SoC-Labs/TideLink-Chiplet-Interconnect-AHB/docs/CALIBRATOR_9_11F_POSTREBOOT_SESSION_2026_05_28.md

# §9.11f post-reboot session — Layer-2 bit-error-rate confirmed

Date: 2026-05-28 (continuing from §9.11e overnight session report 4f31f41)
Branch: `feat/calibrator-eyecenter` HEAD = 4f31f41
Boards: bridge1 (z2_02 master die_a, z2_03 slave die_b), POST-REBOOT
Lease: bridge1 held mapstone-dev → 1h TTL

## Headline

Boards rebooted clean. §9.11d-equivalent bitstreams redeployed, **bilateral
LINK_IDLE recovers reproducibly** (Symptom A from yesterday: SOLVED). However
**no data traffic crosses in either direction post-LINK_IDLE** (Symptom B from
yesterday: still UNSOLVED). New evidence below isolates this to **long-packet
bit-error-rate failure** — the calibrator's eye-center is correct for the
training pattern and for short link-control packets (CR / CRACK), but
insufficient for long data packets (AHB-encapsulated writes such as the
doorbell-response).
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
