SoC-Labs/TideLink-Chiplet-Interconnect-AHB/syn/asic/fusion-compiler/INTEGRATION_CHANGES.md

# TideLink FC partition — integration changes + characterised dead-ends

This document captures the non-obvious decisions, characterised dead-ends,
and waivers the TideLink FC partition flow carries. Read this **before**
investigating any of the following symptoms — they are all already
explained.

---

## 1. PG floating-cell count (~4.6k) — PASS\*, not WAIVE

**Symptom:** `check_pg_connectivity` reports ~4622 floating std-cells in
the post-route block, despite check_pg_drc PASS, timing closed, LEC PASS.

**Characterised mechanism:** trim:true PG-mesh wire-stub fragments +
partition PG-terminal hand-off gaps (ZRT-740). The cells are tied to
VDD/VSS via the lib_cell `pg_pin` attribute (inferred), not via explicit
Verilog wiring — `get_cells -of_objects [get_nets VDD]` walks explicit
connections only, so the inferred ties appear as "floating" in the
canonical net's cells_of_objects collection.

**Audit script:** `scripts/pg_deepdive.tcl` (`make fc_pg_deepdive`).
Confirmed 49,622 / 54,868 = 90.4% of leaf cells are explicit-tied; the
9.6% "neither VDD nor VSS" population matches check_pg_connectivity's
count to within ~600 (same fragment population, slightly different
counting methodology between the two tools).

**Disposition:** PASS\* — characterised benign, ceiling at
`FC_PG_CONN_FLOAT_MAX=5500` (default). `FC_PG_CONN_WAIVER=0` restores
the strict ==0 gate.

**Supporting evidence the count is artefact:**
- `check_pg_drc` PASS (no PG geometric defect)
- Timing closed on both setup (WNS 0.00 ns) and hold (-0.00 ns) —
  would fail catastrophically if cells were truly disconnected
- Formality LEC clean (18,531 / 0 / 0 / 0)
- Same mechanism characterised by ahb_qspi's INTEGRATION_CHANGES.md
  "PG floating-cell deep-dive"

**Dead-end:** tightening the M5/M6 mesh from 50 µm → 25 µm in
pg_mesh.tcl was tried (2026-05-20) and **doubled** the count to ~9023.
The denser mesh adds more trim:true stub fragments; the count is a
property of trim:true geometry, not a function of mesh density.
Reverted.

---

## 2. End-of-line spacing DRCs — 9 residual after 3-pass ECO

**Symptom:** `check_routes` reports 9 EOL spacing DRCs concentrated in
the std-cell band shadowing the rf_16k macro (bottom-right corner).

**Convergence path proven on this build:**
| Pass | DRCs |
|---|---|
| Initial `route_auto` + `route_opt` (4_route.tcl) | 99 |
| Single `route_eco` (4_route.tcl, –max_detail_route_iterations 40) | 57 |
| 3-pass loop in pg_rails.tcl (route_eco / route_detail / route_eco, each 40 iter) | 9 |

The 3-pass loop is the ECO-relief recipe the ahb_qspi reference flow
validated. App_options that materially affect the convergence:
- `route.detail.force_max_number_iterations = true`
- `route.detail.drc_convergence_effort_level = high`
- `route.detail.eco_max_number_of_iterations = 50`
- `place.legalize.reduce_conservatism_in_eol_check = true`
- `route.common.eco_route_fix_existing_drc = true`

All set in pg_rails.tcl before the route_eco loop.

**Dead-end:** `route_opt -from final_route -to final_route` (the
ahb_qspi flow's documented relief command) is **ICC2-only syntax** —
fc_shell FS-COMPILER_2022.12 rejects it with CMD-010. Both the
ahb_qspi and tidelink flows were silently catch-and-skipping this
command for months before the diagnosis (2026-05-20). `route_eco`
without positional args is the FC equivalent.

**Disposition:** 9 EOL residuals are structural at this util /
floorplan (router can't escape local congestion without re-placement,
which would risk timing). Chip-top ECO required at top-level assembly,
or foundry waiver. Documented in the per-build MANIFEST.md.

---

## 3. Wav cell substitution (gap B + C) — DORMANT in v1

**Symptom:** enabling `+define+ASIC_TSMC65` (which swaps the
WavDemet{Set,Reset,Reset_*} flops to explicit `SDFFRPQ_X1M_A12TR` /
`SDFFSRPQ_X1M_A12TR` instances + the WavClockMux to a structural
glitch-free 2-flop-handshake mux) **regressed scen_fast hold WNS to
−4.85 ns** on 63 endpoints. Setup remained clean.

**Investigation log:**

| Attempt | Change | Hold WNS (scen_fast) | Note |
|---|---|---|---|
| 1 (2026-05-20) | Substitution raw, no SDC handling | −4.71 ns | Hypothesised reset-tree imbalance |
| 2 (2026-05-21) | Added `set_false_path -to` on 840 R/SN pins | −4.85 ns | False_path didn't help — failure mode isn't the reset pins |
| 3 (2026-05-21) | 2× `BUF_X1M_A12TR` between u_f1.Q and u_f2.D | −4.76 ns | 160 ps of explicit BUF delay → barely improved. Failure mode is NOT a localised f1→f2 hold-margin issue |

**Real failure mode (attempt 3 finding):** attempt 2's hypothesis was
wrong. ~160 ps of explicit BUF delay on the f1→f2 path moved hold WNS
by only ~90 ps (−4.85 → −4.76). The violations CANNOT all be local f1→f2
hold-margin issues — that scale of regression points at either
(a) a global clock-skew change when SDFFRPQ replaces FC's inferred
flops, (b) violations on OTHER paths (e.g. demet f2.Q fanning into
Wlink Chisel combinational paths with very short delays), or (c) FC's
hold-fix opto being inhibited on the substituted instances.

**v1.1 next step:** open the pg_probe.design block and inspect WHERE
the −4.76 ns hold violations actually are (count by ref_name; check
the failing-endpoint distribution; verify clock-tree skew around the
substituted vs non-substituted cells). Don't rebuild blind a fourth
time — the next iteration needs `report_timing -delay_type min -max_paths 50`
on the substituted block first.

**Attempt 3 mechanical record:** inserted two `BUF_X1M_A12TR` cells in
series between each u_f1.Q and u_f2.D inside each WavDemet*.v
`\`ifdef ASIC_TSMC65` arm. Per-bit inside the generate-for loop for the
width variants. The wrappers are still in-tree (no harm when the gate
is off); re-enable `+define+ASIC_TSMC65` once the actual failure
mechanism is diagnosed.

**Timing guards:** pg_rails.tcl now has both a setup WNS guard
(< −0.05 ns aborts) and a scen_fast hold WNS guard (< −0.5 ns aborts),
both via `report_qor` text parse (fc_shell doesn't expose `setup_wns`
as a scenario attribute in this build — ATTR-1 warning).

---

## 4. fc_shell vs ICC2 syntax — the silent failures

fc_shell FS-COMPILER_2022.12 inherits much of its command set from
ICC2 but has subtle differences. Several ICC2 idioms silently fail
here (`Error: unknown option …` is caught and the command becomes a
no-op):

| Command / option | Status in this build | Workaround |
|---|---|---|
| `route_opt -from final_route -to final_route` | REJECTED | Use `route_eco` |
| `route_opt -effort high` | REJECTED | Fall back to a second default-effort `route_opt` |
| `get_attribute [get_scenarios …] setup_wns` | Returns "" | Parse `report_qor` text output instead |
| `get_ports -quiet` (in SDC) | REJECTED | Use unconditional get_ports, accept warning |
| `sizeof_collection` (in SDC) | REJECTED | Move to read_sdc caller (full fc_shell Tcl scope) |
| `check_design -checks {netlist_pre_check}` | EMS-035 (not a valid check name) | Skip — handled by 7_drc.tcl's adv-runner |
| `check_design -checks {pre_signoff_stage}` | EMS-035 | Same |
| `check_design -checks {placement}` | EMS-035 | Same |

Every one of these is caught by `catch{}` in the flow scripts so the
flow proceeds; the failures appear only in the .log. The diagnostic
hint is "this command does nothing" — if a command was supposed to
make a measurable change and you can't see one, grep the log for
`(CMD-010|CMD-005|CMD-012|EMS-035)`.

---

## 5. ICG library safety net — Wav clock-gates land on PREICG

**Risk:** the Wlink Chisel `WavClockGate` + `wav_latch_model` cells are
not explicitly mapped at RTL — they rely on FC's clock-gating
inference to land on the sc12 `PREICG_X*B_A12TR` ICG family (20 cells).
If `set_dont_use */PREICG_*_A12TR` is ever applied earlier in the link
chain (e.g. ahb_qspi-style global ban) the 870 ICG sites silently
collapse to ungated enable-fanout flops — large dynamic-power
regression that survives DRC, LEC, and timing checks.

**Safety net:** setup.tcl asserts the 20 PREICG cells are visible at
the start of every stage. If `sizeof_collection` returns 0, `error`
out with a diagnostic listing the likely causes (wrong TARGET_LIB,
wrong sc12 cut, fusion_lib without Liberty). The supported off-switch
remains `FC_CLOCK_GATING=off` in setup_design_options.tcl — that path
applies `set_dont_use` AFTER the assertion has run.

---

## 6. GDS-034 noise around write_gds — suppressed

**Symptom:** `write_gds` fires ~400 GDS-034 "view ' layout' not
available" warnings during the lib-cell layout lookup pass, even when
the warned cells ARE present in the `-merge_files` stream.

**Mechanism:** the lib-view lookup runs before merge-substitution.
ahb_qspi's logs show the same warning count and they tape out clean.
The warnings are benign — the cells DO land in the emitted GDS.

**Fix:** `suppress_message GDS-034` around the `write_gds` call in
6_partition_export.tcl. Removed the noise (407 → 3 warnings in the
log) without affecting the GDS output.

---

## 7. Scripting conventions that bit us

- **fc_shell exits 0 even on Tcl errors.** Every stage script ends
  with a `puts "FC_STAGE_OK: <stage>"` marker; the Makefile recipes
  `grep -q` for that marker and exit 1 if absent. **Do not** rely on
  the bash exit code of `fc_shell` alone.
- **`get_attribute [get_scenarios X] setup_wns` returns empty string,
  not an error.** Test the value (`eq ""`) before using.
- **SDC-mode is stricter than fc_shell Tcl.** read_sdc rejects
  procs that work in standalone Tcl (sizeof_collection,
  get_ports -quiet, get_clocks -quiet). For conditional logic,
  apply commands from the read_sdc caller (1_init_design.tcl).
- **`catch {expr {"" < -0.05}}` returns 1 in some interpreter modes
  and 0 in others.** Always guard `expr` with explicit `eq ""` test
  before comparing parsed values to a threshold.

---

## 8. What is NOT in the flow (and why)

| Stage | Reason |
|---|---|
| DFT compiler / scan stitching | Out of scope for v1. Substituted SI/SE pins on SDFFRPQ scan flops are tied to 1'b0 — a later DFT step needs to rip them up and stitch chains. |
| Foundry sign-off DRC (ICV runset) | Needs cln65lp .rs runset from foundry. Hook exists: `ICV_DRC_RUNSET=<path> make fc_drc`. |
| Sign-off LVS | Needs Calibre or ICV LVS with the foundry deck. Run against `tidelink_top.pg.v`. |
| Power IR-drop / EM | Needs RedHawk-SC or Voltus + SAIF/VCD activity. PG mesh is a conservative starting point (50 µm M5/M6) but never characterised against real current density. |
| Crosstalk SI delta-delay | `update_timing -full` ran with TLU+ but no explicit SI annotation pass. Needs PrimeTime SI run. |
| MBIST for rf_16k | Chip-top responsibility — the rf_16k macro exposes BIST hooks but no wrapper here. |

---

## Reference / further reading

- ahb_qspi reference flow: `/home/dam1n19/SoCLabs/ahb_qspi/syn/asic/fusion-compiler/INTEGRATION_CHANGES.md`
- ASIC_HARD_IP_INVENTORY: `/home/dam1n19/td_idelay_wt/docs/ASIC_HARD_IP_INVENTORY.md` (§4.2, §4.3, §7.5 for gap B/C context)
- PG floating-cell deep-dive audit: `reports/08_pg_deepdive.rep` (after `make fc_pg_deepdive`)
- DRC summary: `reports/07_summary.rep`
- Per-build manifest: `outputs/MANIFEST.md`
