SoC-Labs/TideLink-Chiplet-Interconnect-AHB/src/rtl/tidelink_ptp_servo.sv

//-----------------------------------------------------------------------------
// SoCLabs TideLink PTP Servo — Autonomous Hardware Clock Synchronisation
//
// Implements fully autonomous PTP clock synchronisation without CPU
// intervention. Operates in one of two modes:
//
//   Grandmaster: Captures t1/t4 timestamps after SYNC/DELAY_REQ exchange,
//                sends timestamps to Subordinate via FC SIDEBAND packets.
//
//   Subordinate: Captures t2/t3 timestamps, receives t1/t4 from Grandmaster
//                via FC SIDEBAND mailbox, computes offset/delay, adjusts PHC.
//
// Timestamp exchange uses FC SIDEBAND packets (4 per timestamp, 32 bits each)
// written to the remote side's mailbox registers via the existing FC RX
// config path. No short packet data_id allocation is needed.
//
// Clock discipline:
//   - Large offset (|offset| > threshold or seconds mismatch): SET_TIME phase step
//   - Small offset: PI controller adjusts NS_INCR_FRAC for frequency steering
//
// A joint work commissioned on behalf of SoC Labs, under Arm Academic
// Access license.
//
// Contributors
//
// David Mapstone (d.a.mapstone@soton.ac.uk)
//
// Copyright 2026, SoC Labs (www.soclabs.org)
//-----------------------------------------------------------------------------

module tidelink_ptp_servo #(
    parameter SYS_DATA_W = 32,
    parameter FC_DATA_W  = 48,
    // Default PI gains in Q0.32 fixed-point
    parameter [SYS_DATA_W-1:0] DEFAULT_KP         = 32'h0000_B333,  // ~0.7
    parameter [SYS_DATA_W-1:0] DEFAULT_KI         = 32'h0000_4CCC,  // ~0.3
    parameter [SYS_DATA_W-1:0] DEFAULT_STEP_THRESH = 32'd1000,       // 1000 ns
    // Multiplier mode: 0=iterative (small, 32-cycle), 1=combinational (large, 1-cycle)
    parameter MULTIPLIER_MODE = 0
)(
    // --------------------------------------------------------------------------
    // Clock and Reset
    // --------------------------------------------------------------------------
    input  logic                    clk,
    input  logic                    resetn,

    // --------------------------------------------------------------------------
    // Register Interface (Region 3 from APB pass-through)
    // --------------------------------------------------------------------------
    input  logic                    servo_reg_write,
    input  logic              [2:0] servo_reg_addr,
    input  logic   [SYS_DATA_W-1:0] servo_reg_wdata,
    output logic   [SYS_DATA_W-1:0] servo_reg_rdata,

    // --------------------------------------------------------------------------
    // PTP Event Inputs (from tidelink_ptp)
    // --------------------------------------------------------------------------
    input  logic                    sync_tx_done,
    input  logic                    dreq_tx_done,
    input  logic                    sync_rx_done,
    input  logic                    dreq_rx_done,

    // --------------------------------------------------------------------------
    // PHC Hardware Capture (direct wire from PHC clock core)
    // --------------------------------------------------------------------------
    input  logic             [47:0] hw_cap_seconds,
    input  logic             [29:0] hw_cap_nanoseconds,

    // --------------------------------------------------------------------------
    // FC SIDEBAND Injection (to FC adapter TX arbiter)
    // --------------------------------------------------------------------------
    output logic                    servo_fc_valid,
    output logic   [FC_DATA_W-1:0]  servo_fc_data,
    input  logic                    servo_fc_ready,

    // --------------------------------------------------------------------------
    // Timestamp Mailbox Write (from FC RX config path via APB)
    // --------------------------------------------------------------------------
    input  logic                    mbox_reg_write,
    input  logic              [2:0] mbox_reg_addr,   // 3-bit offset within mailbox
    input  logic  [SYS_DATA_W-1:0]  mbox_reg_wdata,

    // --------------------------------------------------------------------------
    // DELAY_REQ Trigger (to tidelink_ptp TX path)
    // --------------------------------------------------------------------------
    output logic                    servo_dreq_trigger,

    // --------------------------------------------------------------------------
    // PHC Adjustment Outputs (direct wire to PHC clock core)
    // --------------------------------------------------------------------------
    output logic                    phc_hw_set_time,
    output logic             [47:0] phc_hw_set_seconds,
    output logic             [29:0] phc_hw_set_nanoseconds,
    output logic                    phc_hw_adj_valid,
    output logic  [SYS_DATA_W-1:0]  phc_hw_adj_ns_incr_frac,

    // --------------------------------------------------------------------------
    // Status
    // --------------------------------------------------------------------------
    output logic                    servo_locked
);

    // =========================================================================
    // Constants
    // =========================================================================
    localparam [1:0]  PKT_SIDEBAND = 2'b01;
    // (NS_PER_SECOND was declared here and never referenced; ONE_SEC_NS below
    // is the constant this block actually uses. Removed rather than waived.)
    // One second in nanoseconds
    localparam signed [31:0] ONE_SEC_NS = 32'sd1_000_000_000;

    // Saturated seconds-difference encodings, shared by the assignment sites
    // and the case tags below. Named because `-2'sd1` is a unary-minus
    // EXPRESSION rather than a literal, and an expression used as a case item
    // is a real trap in general (HAL CSTEXP) -- here the value is constant-
    // folded, so this is naming, not a behaviour change. 2'sd(-1) == 2'b11.
    localparam signed [1:0] SEC_DIFF_ZERO = 2'sd0;
    localparam signed [1:0] SEC_DIFF_POS1 = 2'sd1;
    localparam signed [1:0] SEC_DIFF_NEG1 = -2'sd1;

    // Mailbox target offsets (where SIDEBAND packets write on the remote side)
    // These are APB register offsets within TideLink config space
    localparam [13:0] MBOX_SEC_LO_OFFSET  = 14'h068;
    localparam [13:0] MBOX_SEC_HI_OFFSET  = 14'h06C;
    localparam [13:0] MBOX_NS_OFFSET      = 14'h070;
    // Mailbox slot 0x074 (sub-ns) exists in the remote register map but this
    // Grandmaster never transmits it -- the sub-ns field is dropped from the
    // 30-bit ns arithmetic below. The localparam that named it was unreferenced
    // and is removed; the address is recorded here so the map stays documented.

    // =========================================================================
    // Configuration Registers
    // Region 2 (addr 3-7, servo_reg_addr 0-4):
    //   0 (0x04C): SERVO_CTRL       — [0] enable, [1] mode (0=GM, 1=Sub)
    //   1 (0x050): SERVO_KP         — Proportional gain Q0.32
    //   2 (0x054): SERVO_KI         — Integral gain Q0.32
    //   3 (0x058): SERVO_STEP_THRESH — Step threshold (ns)
    //   4 (0x05C): SERVO_STATUS     — [0] locked, [1] active, [31:2] offset
    // Region 3 (addr 0-1, servo_reg_addr 5-6):
    //   5 (0x060): SERVO_DELAY      — Last one-way delay (ns)
    //   6 (0x064): SERVO_NS_FRAC    — Current NS_INCR_FRAC driven
    // =========================================================================

    logic        servo_enable_r;
    logic        servo_mode_r;           // 0=Grandmaster, 1=Subordinate
    logic [SYS_DATA_W-1:0] servo_kp_r;
    logic [SYS_DATA_W-1:0] servo_ki_r;
    logic [SYS_DATA_W-1:0] servo_step_thresh_r;

    // Status registers (read-only, updated by computation)
    logic signed [31:0] last_offset_r;   // Signed nanoseconds
    logic        [31:0] last_delay_r;    // Unsigned nanoseconds
    logic [SYS_DATA_W-1:0] current_frac_r;

    // Forward declarations (FSMs defined below)
    wire gm_active;
    wire sub_active;

    // Register writes
    always_ff @(posedge clk or negedge resetn) begin
        if (!resetn) begin
            servo_enable_r     <= 1'b0;
            servo_mode_r       <= 1'b0;
            servo_kp_r         <= DEFAULT_KP;
            servo_ki_r         <= DEFAULT_KI;
            servo_step_thresh_r <= DEFAULT_STEP_THRESH;
        end else if (servo_reg_write) begin
            case (servo_reg_addr)
                3'h0: begin
                    servo_enable_r <= servo_reg_wdata[0];
                    servo_mode_r   <= servo_reg_wdata[1];
                end
                3'h1: servo_kp_r          <= servo_reg_wdata;
                3'h2: servo_ki_r          <= servo_reg_wdata;
                3'h3: servo_step_thresh_r <= servo_reg_wdata;
                default: ;
            endcase
        end
    end

    // Register reads (addr 0-4 = config from Region 2, addr 5-6 = status from Region 3)
    always_comb begin
        servo_reg_rdata = '0;
        case (servo_reg_addr)
            3'h0: servo_reg_rdata = {{(SYS_DATA_W-2){1'b0}}, servo_mode_r, servo_enable_r};
            3'h1: servo_reg_rdata = servo_kp_r;
            3'h2: servo_reg_rdata = servo_ki_r;
            3'h3: servo_reg_rdata = servo_step_thresh_r;
            3'h4: servo_reg_rdata = {{(SYS_DATA_W-2){1'b0}}, gm_active | sub_active, servo_locked};
            3'h5: servo_reg_rdata = $unsigned(last_offset_r);  // Region 3 offset 0x060 (signed ns, read as a raw word)
            3'h6: servo_reg_rdata = last_delay_r;        // Region 3 offset 0x064
            3'h7: servo_reg_rdata = current_frac_r;      // Region 3 offset 0x068
            default: ;
        endcase
    end

    // =========================================================================
    // Timestamp Storage (110 bits each: 48-bit sec + 30-bit ns + 32-bit sub_ns)
    // =========================================================================

    // GM timestamps (captured from PHC hw_cap wires)
    logic [47:0] gm_t1_sec, gm_t4_sec;
    logic [29:0] gm_t1_ns,  gm_t4_ns;

    // Sub local timestamps (captured from PHC hw_cap wires)
    logic [47:0] sub_t2_sec, sub_t3_sec;
    logic [29:0] sub_t2_ns,  sub_t3_ns;

    // Sub remote timestamps (received via FC SIDEBAND mailbox)
    logic [47:0] sub_t1_sec, sub_t4_sec;
    logic [29:0] sub_t1_ns,  sub_t4_ns;

    // =========================================================================
    // Timestamp Mailbox — Receives FC SIDEBAND writes from remote side
    // =========================================================================
    // The FC RX config path writes SIDEBAND payload to APB registers.
    // When the address falls in the mailbox range, it's routed here.
    // Writing SUB_NS (last word) triggers a "timestamp complete" pulse.

    logic [31:0] mbox_sec_lo_r;
    logic [15:0] mbox_sec_hi_r;
    logic [29:0] mbox_ns_r;
    logic        mbox_ts_complete;  // Pulse: full timestamp received

    always_ff @(posedge clk or negedge resetn) begin
        if (!resetn) begin
            mbox_sec_lo_r   <= '0;
            mbox_sec_hi_r   <= '0;
            mbox_ns_r       <= '0;
            mbox_ts_complete <= 1'b0;
        end else begin
            mbox_ts_complete <= 1'b0;
            if (mbox_reg_write) begin
                // Region 3 paddr[4:2]: 2=SEC_LO, 3=SEC_HI, 4=NS (last word triggers complete)
                case (mbox_reg_addr)
                    3'h2: mbox_sec_lo_r <= mbox_reg_wdata;
                    3'h3: mbox_sec_hi_r <= mbox_reg_wdata[15:0];
                    3'h4: begin
                        mbox_ns_r        <= mbox_reg_wdata[29:0];
                        mbox_ts_complete <= 1'b1;
                    end
                    default: ;
                endcase
            end
        end
    end

    // Assembled mailbox timestamp
    wire [47:0] mbox_seconds    = {mbox_sec_hi_r, mbox_sec_lo_r};
    wire [29:0] mbox_nanoseconds = mbox_ns_r;

    // =========================================================================
    // Grandmaster FSM
    // =========================================================================

    typedef enum logic [3:0] {
        GM_IDLE         = 4'd0,
        GM_CAPTURE_T1   = 4'd1,
        GM_WAIT_DREQ_RX = 4'd2,
        GM_CAPTURE_T4   = 4'd3,
        GM_SEND_T1_0    = 4'd4,
        GM_SEND_T1_1    = 4'd5,
        GM_SEND_T1_2    = 4'd6,
        GM_SEND_T1_3    = 4'd7,
        GM_SEND_T4_0    = 4'd8,
        GM_SEND_T4_1    = 4'd9,
        GM_SEND_T4_2    = 4'd10,
        GM_SEND_T4_3    = 4'd11
    } gm_state_t;

    gm_state_t gm_state_r;
    assign gm_active = (gm_state_r != GM_IDLE);

    always_ff @(posedge clk or negedge resetn) begin
        if (!resetn) begin
            gm_state_r <= GM_IDLE;
        end else if (!servo_enable_r || servo_mode_r) begin
            // Disabled or in Subordinate mode
            gm_state_r <= GM_IDLE;
        end else begin
            case (gm_state_r)
                GM_IDLE: begin
                    if (sync_tx_done)
                        gm_state_r <= GM_CAPTURE_T1;
                end

                GM_CAPTURE_T1: begin
                    gm_t1_sec  <= hw_cap_seconds;
                    gm_t1_ns   <= hw_cap_nanoseconds;

                    gm_state_r <= GM_WAIT_DREQ_RX;
                end

                GM_WAIT_DREQ_RX: begin
                    if (dreq_rx_done)
                        gm_state_r <= GM_CAPTURE_T4;
                end

                GM_CAPTURE_T4: begin
                    gm_t4_sec  <= hw_cap_seconds;
                    gm_t4_ns   <= hw_cap_nanoseconds;

                    gm_state_r <= GM_SEND_T1_0;
                end

                // Send t1 as 3 FC SIDEBAND packets (sec_lo, sec_hi, ns)
                GM_SEND_T1_0: if (servo_fc_ready) gm_state_r <= GM_SEND_T1_1;
                GM_SEND_T1_1: if (servo_fc_ready) gm_state_r <= GM_SEND_T1_2;
                GM_SEND_T1_2: if (servo_fc_ready) gm_state_r <= GM_SEND_T4_0;

                // Send t4 as 3 FC SIDEBAND packets (sec_lo, sec_hi, ns)
                GM_SEND_T4_0: if (servo_fc_ready) gm_state_r <= GM_SEND_T4_1;
                GM_SEND_T4_1: if (servo_fc_ready) gm_state_r <= GM_SEND_T4_2;
                GM_SEND_T4_2: if (servo_fc_ready) gm_state_r <= GM_IDLE;

                default: gm_state_r <= GM_IDLE;
            endcase
        end
    end

    // GM FC SIDEBAND TX mux
    logic                   gm_fc_valid;
    logic [FC_DATA_W-1:0]  gm_fc_data;

    always_comb begin
        gm_fc_valid = 1'b0;
        gm_fc_data  = '0;
        case (gm_state_r)
            GM_SEND_T1_0: begin gm_fc_valid = 1'b1; gm_fc_data = {PKT_SIDEBAND, MBOX_SEC_LO_OFFSET, gm_t1_sec[31:0]};  end
            GM_SEND_T1_1: begin gm_fc_valid = 1'b1; gm_fc_data = {PKT_SIDEBAND, MBOX_SEC_HI_OFFSET, {16'b0, gm_t1_sec[47:32]}}; end
            GM_SEND_T1_2: begin gm_fc_valid = 1'b1; gm_fc_data = {PKT_SIDEBAND, MBOX_NS_OFFSET,     {2'b0, gm_t1_ns}};  end
            GM_SEND_T4_0: begin gm_fc_valid = 1'b1; gm_fc_data = {PKT_SIDEBAND, MBOX_SEC_LO_OFFSET, gm_t4_sec[31:0]};  end
            GM_SEND_T4_1: begin gm_fc_valid = 1'b1; gm_fc_data = {PKT_SIDEBAND, MBOX_SEC_HI_OFFSET, {16'b0, gm_t4_sec[47:32]}}; end
            GM_SEND_T4_2: begin gm_fc_valid = 1'b1; gm_fc_data = {PKT_SIDEBAND, MBOX_NS_OFFSET,     {2'b0, gm_t4_ns}};  end
            default: ;
        endcase
    end

    // =========================================================================
    // Subordinate FSM
    // =========================================================================

    typedef enum logic [3:0] {
        SUB_IDLE         = 4'd0,
        SUB_CAPTURE_T2   = 4'd1,
        SUB_SEND_DREQ    = 4'd2,
        SUB_WAIT_DREQ_TX = 4'd3,
        SUB_CAPTURE_T3   = 4'd4,
        SUB_WAIT_T1      = 4'd5,
        SUB_LATCH_T1     = 4'd6,
        SUB_WAIT_T4      = 4'd7,
        SUB_LATCH_T4     = 4'd8,
        SUB_COMPUTE_1    = 4'd9,
        SUB_COMPUTE_2    = 4'd10,
        SUB_COMPUTE_3    = 4'd11,
        SUB_COMPUTE_4    = 4'd12,
        SUB_ADJUST       = 4'd13,
        SUB_PI_MUL_P     = 4'd14,
        SUB_PI_MUL_I     = 4'd15
    } sub_state_t;

    sub_state_t sub_state_r;
    assign sub_active = (sub_state_r != SUB_IDLE);

    // =========================================================================
    // Offset/Delay Computation Pipeline Registers
    // =========================================================================
    // All arithmetic uses 30-bit nanosecond values (sub-ns dropped).
    // Seconds differences checked separately for phase step decisions.

    // 32 bits: after a +/-1 s carry a path difference reaches +/-1.999999999 s,
    // which overflowed the old 31-bit form above 1.07 s (rev-2 LP-13, measured
    // 2026-09-23: a +1.5 s start stepped once and ended 1.57 s off).
    logic signed [31:0] d_fwd_r;      // t2 - t1 (forward path, ns)
    logic signed [31:0] d_rev_r;      // t4 - t3 (reverse path, ns)
    logic signed [32:0] raw_offset_r; // d_fwd - d_rev spans +/-4 s
    logic signed [32:0] raw_delay_r;
    logic signed [31:0] offset_r;     // raw_offset >>> 1
    logic signed [31:0] delay_r;      // raw_delay >>> 1

    // Seconds difference tracking (compressed: only need -1/0/+1 or overflow)
    logic signed [1:0]  sec_diff_fwd_r;   // -1, 0, +1 (saturated)
    logic               sec_diff_fwd_ovf; // |diff| > 1 → force phase step
    logic signed [1:0]  sec_diff_rev_r;   // -1, 0, +1 (saturated)
    logic               sec_diff_rev_ovf; // |diff| > 1 → force phase step
    logic               needs_phase_step_r;

    // PI controller state (32-bit: ±2.15 seconds max accumulated error)
    logic signed [31:0] integral_r;

    // Locked detection: offset below threshold for consecutive exchanges
    // Sized to lock_counter_r's width so the `<` below compares like with like
    // (was an unsized integer -> 32-bit RHS, HAL ULRELE). lock_counter_r is
    // unsigned and saturates at LOCK_COUNT, so zero-extending the 4-bit LHS to
    // 32 bits gave the same answer -- this is width hygiene, not a bug fix.
    localparam [3:0] LOCK_COUNT = 4'd4;
    logic [3:0] lock_counter_r;

    // =========================================================================
    // Iterative Multiplier for PI Controller
    // =========================================================================
    logic              mul_start;
    logic signed [31:0] mul_a;
    logic        [31:0] mul_b;
    logic signed [63:0] mul_result;
    logic              mul_done;
    logic              mul_busy;
    logic signed [31:0] pi_p_term_r;

    generate
        if (MULTIPLIER_MODE == 0) begin : gen_iter_mul
            tidelink_mul_iter u_mul (
                .clk    (clk),
                .resetn (resetn),
                .start  (mul_start),
                .busy   (mul_busy),
                .done   (mul_done),
                .a      (mul_a),
                .b      (mul_b),
                .result (mul_result)
            );
        end else begin : gen_comb_mul
            assign mul_result = $signed({{32{mul_a[31]}}, mul_a}) * $signed({1'b0, mul_b});
            assign mul_done   = mul_start;
            assign mul_busy   = 1'b0;
        end
    endgenerate

    // =========================================================================
    // Subordinate FSM Logic
    // =========================================================================

    // ── Carry-adjusted reverse path, used by SUB_COMPUTE_3 in the same cycle ──
    logic signed [31:0] d_rev_adj;
    always_comb begin
        case (sec_diff_rev_r)
            SEC_DIFF_POS1: d_rev_adj = d_rev_r + ONE_SEC_NS;
            SEC_DIFF_NEG1: d_rev_adj = d_rev_r - ONE_SEC_NS;
            default:       d_rev_adj = d_rev_r;
        endcase
    end

    // ── Saturating frequency word (see SUB_PI_MUL_I) ─────────────────────────
    logic signed [33:0] frac_next;
    logic        [31:0] frac_next_sat;
    always_comb begin
        frac_next = $signed({2'b00, current_frac_r})
                  - (34'(pi_p_term_r) + 34'($signed(mul_result[63:32])));
        if (frac_next < 0)
            frac_next_sat = 32'h0000_0000;
        else if (frac_next > 34'sh0_FFFF_FFFF)
            frac_next_sat = 32'hFFFF_FFFF;
        else
            frac_next_sat = frac_next[31:0];
    end

    // ── Phase-step target: master time at t2 = t1 + one-way delay ─────────────
    // delay_r is trusted only when both seconds differences were representable
    // (|dsec| <= 1) and it is non-negative and below a second; otherwise the step
    // lands on t1 itself and the next exchange removes the residual path delay.
    logic               step_delay_ok;
    logic signed [31:0] step_delay;
    logic signed [31:0] step_ns_sum;     // t1_ns (< 1e9) + delay (< 1e9) < 2^31
    logic        [47:0] step_sec;
    logic        [29:0] step_ns;
    always_comb begin
        step_delay_ok = !sec_diff_fwd_ovf && !sec_diff_rev_ovf &&
                        !delay_r[31] && (delay_r < ONE_SEC_NS);
        step_delay    = step_delay_ok ? delay_r : 32'sd0;
        step_ns_sum   = $signed({2'b00, sub_t1_ns}) + step_delay;
        if (step_ns_sum >= ONE_SEC_NS) begin
            step_sec = sub_t1_sec + 48'd1;
            step_ns  = 30'(step_ns_sum - ONE_SEC_NS);
        end else begin
            step_sec = sub_t1_sec;
            step_ns  = 30'(step_ns_sum);
        end
    end

    always_ff @(posedge clk or negedge resetn) begin
        if (!resetn) begin
            sub_state_r        <= SUB_IDLE;
            d_fwd_r            <= 32'sd0;
            d_rev_r            <= 32'sd0;
            raw_offset_r       <= 33'sd0;
            raw_delay_r        <= 33'sd0;
            offset_r           <= 32'sd0;
            delay_r            <= 32'sd0;
            sec_diff_fwd_r     <= SEC_DIFF_ZERO;
            sec_diff_fwd_ovf   <= 1'b0;
            sec_diff_rev_r     <= SEC_DIFF_ZERO;
            sec_diff_rev_ovf   <= 1'b0;
            needs_phase_step_r <= 1'b0;
            integral_r         <= 32'sd0;
            lock_counter_r     <= '0;
            servo_locked       <= 1'b0;
            last_offset_r      <= 32'sd0;
            last_delay_r       <= '0;
            current_frac_r     <= '0;
            phc_hw_set_time       <= 1'b0;
            phc_hw_set_seconds    <= '0;
            phc_hw_set_nanoseconds <= '0;
            phc_hw_adj_valid      <= 1'b0;
            phc_hw_adj_ns_incr_frac <= '0;
        end else begin
            // Default: deassert one-cycle pulses
            phc_hw_set_time  <= 1'b0;
            phc_hw_adj_valid <= 1'b0;

            if (!servo_enable_r || !servo_mode_r) begin
                // Disabled or in Grandmaster mode
                sub_state_r <= SUB_IDLE;
            end else begin
                case (sub_state_r)
                    SUB_IDLE: begin
                        if (sync_rx_done)
                            sub_state_r <= SUB_CAPTURE_T2;
                    end

                    SUB_CAPTURE_T2: begin
                        sub_t2_sec  <= hw_cap_seconds;
                        sub_t2_ns   <= hw_cap_nanoseconds;

                        sub_state_r <= SUB_SEND_DREQ;
                    end

                    SUB_SEND_DREQ: begin
                        // servo_dreq_trigger asserted combinationally below
                        sub_state_r <= SUB_WAIT_DREQ_TX;
                    end

                    SUB_WAIT_DREQ_TX: begin
                        if (dreq_tx_done)
                            sub_state_r <= SUB_CAPTURE_T3;
                    end

                    SUB_CAPTURE_T3: begin
                        sub_t3_sec  <= hw_cap_seconds;
                        sub_t3_ns   <= hw_cap_nanoseconds;

                        sub_state_r <= SUB_WAIT_T1;
                    end

                    SUB_WAIT_T1: begin
                        if (mbox_ts_complete)
                            sub_state_r <= SUB_LATCH_T1;
                    end

                    SUB_LATCH_T1: begin
                        sub_t1_sec  <= mbox_seconds;
                        sub_t1_ns   <= mbox_nanoseconds;

                        sub_state_r <= SUB_WAIT_T4;
                    end

                    SUB_WAIT_T4: begin
                        if (mbox_ts_complete)
                            sub_state_r <= SUB_LATCH_T4;
                    end

                    SUB_LATCH_T4: begin
                        sub_t4_sec  <= mbox_seconds;
                        sub_t4_ns   <= mbox_nanoseconds;

                        sub_state_r <= SUB_COMPUTE_1;
                    end

                    // ── Offset Computation Pipeline ──────────────────────
                    SUB_COMPUTE_1: begin
                        // d_fwd = t2_ns - t1_ns
                        d_fwd_r <= $signed({2'b00, sub_t2_ns}) -
                                   $signed({2'b00, sub_t1_ns});
                        // PER-EXCHANGE, not sticky. Until 2026-09-23 this flag was
                        // only ever SET (COMPUTE_2/3) and cleared by reset, so one
                        // exchange with |dsec| > 1 (a start more than a second out,
                        // or a software coarse set) forced the step branch on every
                        // later exchange: the servo never frequency-steered and
                        // servo_locked could never set. Re-derived each exchange.
                        needs_phase_step_r <= 1'b0;
                        // Seconds difference: compressed to -1/0/+1 with overflow flag
                        if (sub_t2_sec == sub_t1_sec) begin
                            sec_diff_fwd_r  <= SEC_DIFF_ZERO;
                            sec_diff_fwd_ovf <= 1'b0;
                        end else if (sub_t2_sec == sub_t1_sec + 48'd1) begin
                            sec_diff_fwd_r  <= SEC_DIFF_POS1;
                            sec_diff_fwd_ovf <= 1'b0;
                        end else if (sub_t2_sec + 48'd1 == sub_t1_sec) begin
                            sec_diff_fwd_r  <= SEC_DIFF_NEG1;
                            sec_diff_fwd_ovf <= 1'b0;
                        end else begin
                            sec_diff_fwd_r  <= SEC_DIFF_ZERO;
                            sec_diff_fwd_ovf <= 1'b1;  // |diff| > 1 → phase step
                        end
                        sub_state_r <= SUB_COMPUTE_2;
                    end

                    SUB_COMPUTE_2: begin
                        // d_rev = t4_ns - t3_ns
                        d_rev_r <= $signed({2'b00, sub_t4_ns}) -
                                   $signed({2'b00, sub_t3_ns});
                        // Seconds difference for reverse path
                        if (sub_t4_sec == sub_t3_sec) begin
                            sec_diff_rev_r  <= SEC_DIFF_ZERO;
                            sec_diff_rev_ovf <= 1'b0;
                        end else if (sub_t4_sec == sub_t3_sec + 48'd1) begin
                            sec_diff_rev_r  <= SEC_DIFF_POS1;
                            sec_diff_rev_ovf <= 1'b0;
                        end else if (sub_t4_sec + 48'd1 == sub_t3_sec) begin
                            sec_diff_rev_r  <= SEC_DIFF_NEG1;
                            sec_diff_rev_ovf <= 1'b0;
                        end else begin
                            sec_diff_rev_r  <= SEC_DIFF_ZERO;
                            sec_diff_rev_ovf <= 1'b1;
                        end
                        // Adjust d_fwd for seconds borrow/carry
                        case (sec_diff_fwd_r)
                            SEC_DIFF_ZERO: ; // Same second — no adjustment
                            SEC_DIFF_POS1: d_fwd_r <= d_fwd_r + ONE_SEC_NS;
                            SEC_DIFF_NEG1: d_fwd_r <= d_fwd_r - ONE_SEC_NS;
                            default: ;
                        endcase
                        if (sec_diff_fwd_ovf)
                            needs_phase_step_r <= 1'b1;
                        sub_state_r <= SUB_COMPUTE_3;
                    end

                    SUB_COMPUTE_3: begin
                        // Adjust d_rev for seconds borrow/carry. The adjusted value
                        // is ALSO what raw_offset/raw_delay below must use: they are
                        // computed in this same state, and a non-blocking update of
                        // d_rev_r is not visible to them until the next cycle. Until
                        // 2026-09-23 they read the UNADJUSTED d_rev_r, so the reverse
                        // carry was silently dropped: at a +/-0.5 s offset where the
                        // two paths straddle a second boundary in opposite directions
                        // the computed offset came out near ZERO and the servo
                        // declared servo_locked=1 while 0.5 s wrong (measured in the
                        // closed-loop bench, cocotb/tidelink_ptp_servo/test_closed_loop.py).
                        d_rev_r <= d_rev_adj;
                        // Compute raw offset and delay.
                        // d_fwd_r/d_rev_adj are `signed [31:0]`, raw_* are
                        // `signed [32:0]`; the 33'() casts sign-extend.
                        raw_offset_r <= 33'(d_fwd_r) - 33'(d_rev_adj);
                        raw_delay_r  <= 33'(d_fwd_r) + 33'(d_rev_adj);
                        if (sec_diff_rev_ovf)
                            needs_phase_step_r <= 1'b1;
                        sub_state_r <= SUB_COMPUTE_4;
                    end

                    SUB_COMPUTE_4: begin
                        // Divide by 2 (arithmetic right shift)
                        // raw_* are 33-bit; halved they span +/-2 s and fit 32 bits.
                        offset_r <= 32'(raw_offset_r >>> 1);
                        delay_r  <= 32'(raw_delay_r  >>> 1);
                        sub_state_r <= SUB_ADJUST;
                    end

                    // ── Clock Adjustment ─────────────────────────────────
                    SUB_ADJUST: begin
                        // offset_r and delay_r are now directly in nanoseconds
                        last_offset_r <= offset_r;
                        last_delay_r  <= $unsigned(delay_r);  // delay is non-negative by construction

                        if (needs_phase_step_r ||
                            (offset_r > $signed(servo_step_thresh_r)) ||
                            (offset_r < -$signed(servo_step_thresh_r))) begin
                            // Phase step — correct time directly
                            // Step to the MASTER's time at the t2 instant: t1 + one-way
                            // delay, with the seconds carried. Until 2026-09-23 this
                            // wrote sub_t2_sec (the slave's OWN seconds) and
                            // sub_t2_ns - offset_r[29:0] (30-bit truncation, no
                            // borrow), so a start more than a second out was stepped
                            // back onto itself every exchange and never corrected.
                            // The delay is taken from this exchange only when its
                            // seconds differences were representable; otherwise 0,
                            // leaving one path delay for the next exchange to remove.
                            phc_hw_set_time        <= 1'b1;
                            phc_hw_set_seconds     <= step_sec;
                            phc_hw_set_nanoseconds <= step_ns;
                            needs_phase_step_r     <= 1'b0;
                            integral_r     <= 32'sd0;
                            lock_counter_r <= '0;
                            servo_locked   <= 1'b0;
                            sub_state_r    <= SUB_IDLE;
                        end else begin
                            // Frequency steering — update integral then start PI multiply
                            if ((integral_r[31] == 1'b0) && (offset_r[31] == 1'b0) &&
                                (integral_r + offset_r < 0))
                                integral_r <= 32'sh7FFF_FFFF;
                            else if ((integral_r[31] == 1'b1) && (offset_r[31] == 1'b1) &&
                                     (integral_r + offset_r >= 0))
                                integral_r <= 32'sh8000_0000;
                            else
                                integral_r <= integral_r + offset_r;

                            // Start P-term multiply: kp × offset
                            mul_start   <= 1'b1;
                            mul_a       <= offset_r;
                            mul_b       <= servo_kp_r;
                            sub_state_r <= SUB_PI_MUL_P;
                        end
                    end

                    // ── PI P-term Multiply ───────────────────────────────
                    SUB_PI_MUL_P: begin
                        mul_start <= 1'b0;
                        if (mul_done) begin
                            pi_p_term_r <= mul_result[63:32];
                            mul_start   <= 1'b1;
                            mul_a       <= integral_r;
                            mul_b       <= servo_ki_r;
                            sub_state_r <= SUB_PI_MUL_I;
                        end
                    end

                    // ── PI I-term Multiply ───────────────────────────────
                    SUB_PI_MUL_I: begin
                        mul_start <= 1'b0;
                        if (mul_done) begin
                            // SATURATE, never wrap. The PHC consumes this as an UNSIGNED
                            // fraction added to a software-set integer increment, so a
                            // negative result used to wrap to ~+1 ns/tick: at 250 MHz the
                            // subordinate ran 25% FAST exactly when it was ahead and
                            // needed to slow (measured 2026-09-23 in the closed-loop
                            // bench: +50 ns grew to +2.7 us in ten exchanges). Clamping
                            // to [0, 2^32-1] stops the runaway. It does NOT give the
                            // servo a way to run slower than the integer increment:
                            // that needs either a signed adjust in the PHC or software
                            // running the PHC one integer ns low with a biased fraction
                            // (registered separately; a design decision, not a fix here).
                            current_frac_r          <= frac_next_sat;
                            phc_hw_adj_valid        <= 1'b1;
                            phc_hw_adj_ns_incr_frac <= frac_next_sat;

                            // Lock detection: |offset| < step_thresh/4.
                            //
                            // BEHAVIOUR-CHANGING FIX (was: `$unsigned(offset_r)
                            // < servo_step_thresh_r[31:2]`). offset_r is
                            // `logic signed [31:0]` (:362). $unsigned() is a
                            // reinterpretation of the bit pattern, NOT an
                            // absolute value: any negative offset became
                            // >= 2**31, which can never be below
                            // servo_step_thresh_r[31:2] (max 2**30-1), so the
                            // else arm fired and cleared lock_counter_r and
                            // servo_locked. Lock could therefore only latch on
                            // LOCK_COUNT consecutive POSITIVE offsets, and a
                            // tracking servo dithers about zero -- so it never
                            // latched in practice. Line 585-587 of this file
                            // does the equivalent magnitude test correctly with
                            // a bidirectional $signed() compare; this is that
                            // form, applied to the quarter-threshold.
                            //
                            // {2'b00, ...} keeps the value non-negative before
                            // $signed(), so a software-written threshold with
                            // bit[31] set cannot flip the comparison sign.
                            // Also clears the HAL ULRELE (32 vs 30 bits) here.
                            if ((offset_r <  $signed({2'b00, servo_step_thresh_r[31:2]})) &&
                                (offset_r > -$signed({2'b00, servo_step_thresh_r[31:2]}))) begin
                                if (lock_counter_r < LOCK_COUNT)
                                    lock_counter_r <= lock_counter_r + 4'd1;
                                else
                                    servo_locked <= 1'b1;
                            end else begin
                                lock_counter_r <= '0;
                                servo_locked   <= 1'b0;
                            end

                            sub_state_r <= SUB_IDLE;
                        end
                    end

                    default: sub_state_r <= SUB_IDLE;
                endcase
            end
        end
    end

    // =========================================================================
    // Output Muxing — Servo DELAY_REQ Trigger
    // =========================================================================
    assign servo_dreq_trigger = (sub_state_r == SUB_SEND_DREQ);

    // =========================================================================
    // Output Muxing — FC SIDEBAND TX (from active FSM)
    // =========================================================================
    // Only GM FSM sends FC packets; Sub FSM only receives via mailbox.
    assign servo_fc_valid = gm_fc_valid;
    assign servo_fc_data  = gm_fc_data;

endmodule
