SoC-Labs/TideLink-Chiplet-Interconnect-AHB/src/rtl/tidelink_top.sv

//-----------------------------------------------------------------------------
// SoCLabs TideLink Top-Level Chiplet Subsystem
//
// Wraps all chiplet communication components into a single module:
//   - TideLink RX FIFO (tidelink_fifo_ahb): receive-side packet buffer
//   - TideLink FC Adapter: bridges AHB TX aperture and returner to
//     a dedicated Wlink FC node (data_id=0xa1, 48-bit)
//   - XHB500 AHB-to-AXI bridge: regular AHB subordinate path
//   - XHB500 AXI-to-AHB bridge: regular AHB manager path
//   - Address Translator: APB-configurable address remapping for AXI path
//   - Chiplet Controller (modified Wlink): link layer, FC, CRC/ECC, PHY
//
// External interfaces:
//   ahb_sub_*  — AHB subordinate: regular AHB access to remote side
//                (via XHB500 → AXI → Wlink, address translated)
//   ahb_tx_*   — AHB subordinate: TideLink TX aperture (direct to FC node,
//                same aperture size as remote RX FIFO, no address translation)
//   ahb_fifo_* — AHB subordinate: local RX FIFO data window (read packets)
//   ahb_mng_*  — AHB manager: incoming from remote side (via XHB500)
//   apb_*      — APB subordinate: unified configuration port
//                (0x0000-0x1FFF: Wlink chiplet controller,
//                 0x2000-0x3FFF: TideLink config + PTP registers,
//                 0x4000-0x5FFF: Address translator configuration)
//
// Reference: nanosoc_ss_chiplet_mng.v in nanosoc-chiplet-tech
//
// A joint work commissioned on behalf of SoC Labs, under Arm Academic
// Access license.
//
// Contributors
//
// David Mapstone (d.a.mapstone@soton.ac.uk)
//
// Copyright 2026, SoC Labs (www.soclabs.org)
//-----------------------------------------------------------------------------

module tidelink_top #(
    // System parameters
    parameter SYS_ADDR_W = 32,
    parameter SYS_DATA_W = 32,

    // TideLink FIFO parameters
    parameter RAM_ADDR_W = 14,       // FIFO SRAM address width (16KB default)
    parameter RAM_DATA_W = 32,       // FIFO SRAM data width
    parameter APB_ADDR_W = 12,       // APB register address width

    // TideLink FC node parameters
    parameter FC_DATA_W  = 48,       // FC node data width (matches AXI W channel)

    // PHY parameters
    parameter NUM_PHY_LANES = 8,     // Number of GPIO PHY lanes (default 8 for production)

    // Default pair base address (for returner — routed through FC sideband)
    parameter [SYS_ADDR_W-1:0] TIDELINK_PAIR_BASE = '0,

    // PHC lock gate for multi-hop PTP chaining
    // 0 = no gating (backward compat), 1 = gate HW sync on phc_locked_i
    parameter PHC_LOCK_GATE_EN = 0,

    // SoC Labs §9 structural fix: per-lane IDELAYE2 RX delay element driven
    // by the calibrator. 0 (default) = bit-exact passthrough, no Xilinx
    // primitive (sim / ASIC). The FPGA IP wrapper overrides to 1 (carried in
    // the packaged IP's component.xml — no preprocessor define needed; see
    // tidelink_idelay_rx.sv header for why the old `ifdef was removed).
    parameter USE_IDELAY = 1'b0,
    // §9 clock fix: recovered-RX-clock BUFG forward (sim/ASIC default 0;
    // FPGA wrapper sets 1, carried in component.xml). tidelink_rxclk_buf.sv.
    parameter USE_CLKBUF = 1'b0,
    // §9 T3a (2026-05-19): per-lane self-aligning RX comma hunt (sim/ASIC
    // default 0; FPGA wrapper sets 1, carried in component.xml). Each
    // WavD2DGpioRx slips its `count` once per io_por_reset to align to the
    // peer's training-byte boundary, killing the per-deploy 16-cycle phase
    // lottery. See deps/.../wlink/WavD2DGpioRx.v header.
    parameter USE_T3A    = 1'b0,
    // Z2 no-data-delivery fix (2026-07-30, docs/HANDOVER_Z2_PICKUP_2026_07_30.md
    // §5): pass-through to axi_chiplet_controller.EPOCH_ANCHOR_EN ->
    // Wlink.EPOCH_ANCHOR_EN -> WlinkGPIOPHY_v2 (V2 only; inert under V1 — the
    // V1 WlinkGPIOPHY has no such parameter, and Wlink.v only forwards it to
    // the phy instance under `ifdef TIDELINK_PHY_V2). Default 0 = today's
    // shipping deskew corrector (SYNC_REANCHOR_EN), which never arms on real
    // silicon because the idle-gated SYNC beacon can't fire. 1 swaps in the
    // training-EXIT anchored corrector proven in sim to fix s2m delivery.
    // This is a real netlist change; a board integration opts in explicitly.
    parameter EPOCH_ANCHOR_EN = 1'b0,
    // S2 scaffold (PLAN_TIDELINK_INTEGRATION, 2026-06-10): select the NEW
    // shared PHY component (deps/tidelink-phy, feat/phy-refactor line) in
    // place of the current WavD2DGpio datapath inside u_chiplet_controller.
    // 0 (default, EVERYWHERE today) = bit-identical to the pre-scaffold RTL:
    // the g_phy_v2 generate arm (see u_chiplet_controller site below)
    // elaborates empty and nothing else is touched. 1 = reserved for the S3
    // drop-in; sources come from flists/tidelink_phy_v2.flist (not yet
    // included by any live flist). Do NOT set to 1 yet — the arm is a
    // placeholder, not a functional PHY.
    parameter logic USE_PHY_V2 = 1'b0,
    // Tier 2 RTL hardening (2026-05-25): force swi_enable=1 on any APB write
    // that asserts swi_swreset=1 to Wlink register 0x208. Protects the 7
    // FCSMs from buggy SW that writes {swreset=1, swi_enable=0} together —
    // without this guard such a write returns all FCSMs to IDLE and loses
    // CR/CRACK sticky state per FC.scala:619. Default 1 (ON) on FPGA/ASIC
    // — bit-exact-safe because the OR engages ONLY when SW already toggles
    // swreset, leaving the well-behaved swreset W1S→W1C sequence unaffected.
    // See docs/TIDELINK_PHASE0_OBS_20260524_2109.md §9.
    parameter HARDEN_SWI_ENABLE = 1'b1,

    // Interface-debug stubs (Phase 3 of TIDELINK_INTERFACE_DEBUG_PLAN §5).
    // When asserted, the corresponding module is replaced by tie-offs to
    // minimise the implicated logic surface for ILA debug bitstreams.
    // Defaults to 0 → normal instantiation (this change is a no-op).
    //   STUB_SERVO        — replaces u_servo (tidelink_ptp_servo)
    //   STUB_PERF         — replaces u_perf  (tidelink_perf)
    //   STUB_PTP          — replaces u_ptp   (tidelink_ptp); REQUIRES
    //                       STUB_SERVO=1 (servo waits on dreq_tx_done from PTP)
    //   BYPASS_ADDR_XLAT  — replaces u_addr_translator with passthrough
    parameter STUB_SERVO       = 1'b0,
    parameter STUB_PERF        = 1'b0,
    parameter STUB_PTP         = 1'b0,
    parameter BYPASS_ADDR_XLAT = 1'b0,

    // v1 PL-side TX traffic generator (docs/TXGEN_V1_DESIGN.md). Present on
    // FPGA benchmark builds; set 0 for tapeout so the block AND its mux are
    // removed by the generate below and the netlist is provably unchanged.
    parameter TXGEN_PRESENT     = 1'b1,
    // SIM-ONLY negative control: defeats the hardware credit gate so a test can
    // prove the peer DOES overrun without it. NEVER set in a shipping flist.
    parameter TXGEN_CREDIT_GATE_DIS = 1'b0,

    // Phase 2 autonomy — POR-default for NEGO_TRAIN_CFG @ 0x4403_210C.
    // 16'h0001 = train_auto_en=1; all timers fall back to FSM defaults.
    // ASIC, FPGA and sim all enter the autonomous training arm out of
    // reset with no SW config write. Cocotb wrappers that need to test
    // the legacy bypass (train_auto_en=0) override this to 16'h0000.
    parameter [15:0] NEGO_TRAIN_CFG_RESET = 16'h0001,
    // NEGO_CFG POR value (companion to NEGO_TRAIN_CFG_RESET).
    // 7'h61 = nego_en + nego_force_lock + mask_hs_auto_en
    // ASIC + FPGA POR boot directly into autonomous bring-up.
    // SoC Labs 2026-06-18: default 7'h00 (autoneg OFF, SW-driven) for the
    // reduced-lane bring-up — see axi_chiplet_controller NEGO_CFG_RESET note.
    // The slave's lane mask is autoneg-locked at 0xff under 7'h61; SW-driven
    // lets both dies set their mask. Revisit 7'h61 once mask-handshake
    // propagates the reduced mask to the slave.
    parameter [6:0]  NEGO_CFG_RESET       = 7'h00,
    // Zero-poke winscan converge-lock — POR-default forwarded verbatim to the
    // axi_chiplet_controller (see its WINSCAN_CONVERGE_LOCK_EN note). 1'b0 =
    // today's behaviour, bit-identical for sim/ASIC; the FPGA vivado wrapper
    // drives 1'b1, exactly the NEGO_CFG_RESET plumbing pattern.
    parameter bit    WINSCAN_CONVERGE_LOCK_EN = 1'b0,
    // HONEST_MASK_HS — peer-mask handshake authenticity gate (from kr260-pair-onchip).
    //   1 (DEFAULT — see the declaration immediately below) = drive the inner
    //       axi_chiplet_controller from the real top-level apb_debug_unlock_i /
    //       mask_hs_bypass_i ports (declared in the port list below; they were
    //       DEAD before this param existed) so the peer-mask handshake must
    //       GENUINELY match. Used by the kr260 on-chip pair to prove hardware
    //       autonomy without either bypass strap, and the intended ASIC
    //       production posture (closes the "APB permanently unlocked"
    //       chip-killer).
    //   0 = legacy bench tie: those two controller inputs are held 1'b1 (see the
    //       u_chiplet_controller instantiation below), so mask_hs_gate_open is
    //       permanently forced open.
    //
    // HISTORY — READ THIS BEFORE TRUSTING ANY OLDER NOTE. DECISION #2 (David,
    // 2026-07-19) is DECIDED AND APPLIED. The default was 1'b0 from 227d1f95
    // until 27db79f9 ("feat: DECISION #2 — APPLY the split; debug UNLOCKED +
    // HONEST_MASK_HS=1"), which flipped it to 1'b1 and split the old single
    // knob into HONEST_MASK_HS + DEBUG_UNLOCK_DEFAULT below. Any comment that
    // still says "default 0", "SPLIT PREPARED, NOT APPLIED", "nothing is
    // applied here" or "byte-identical to today" predates that commit and is
    // WRONG. Ground truth: nanosoc_eth_chiplet.sv instantiates tidelink_top
    // WITHOUT overriding this, so the taped-out eth-chiplet netlists carry the
    // 1'b1 default.
    parameter        HONEST_MASK_HS       = 1'b1,
    // DECISION #2 (David, 2026-07-19) — APPLIED in 27db79f9. Debug-unlock, now
    // INDEPENDENT of HONEST_MASK_HS.
    //   1'b1 (DEFAULT, and what the eth-chiplet ships) = apb_debug_unlock_i
    //       tied 1 at the controller: APB debug permanently unlocked.
    //       nanosoc_eth_chiplet.sv instantiates tidelink_top without overriding
    //       this, so the taped-out die carries 1'b1.
    //   1'b0 = drive the controller from the real top-level apb_debug_unlock_i
    //       port, so APB debug is strap-lockable. This is what the ASIC DFT
    //       wrapper selects (src/rtl/asic/tidelink_dft_wrapper.sv); that
    //       wrapper is NOT in the eth-chiplet's instantiation path.
    // HONEST_MASK_HS=1'b1 with this left at 1'b1 — the combination that ships —
    // is an honest peer-mask handshake WITH debug still unlocked. That holds
    // only because 5c856024 removed apb_debug_unlock_i from mask_hs_gate_open
    // in src/rtl/local_overrides/axi_chiplet_controller.sv; against the
    // unpatched deps/axi-chiplet-controller copy, which still ORs it in,
    // DEBUG_UNLOCK_DEFAULT=1 forces the gate open regardless of HONEST_MASK_HS.
    parameter        DEBUG_UNLOCK_DEFAULT = 1'b1,
    // Phase 2 autonomy — RETIRE-AUTONOMY enable (the B->A channel fix).
    // Forwards to axi_chiplet_controller.RETIRE_EN. When 1, an event-gated
    // retire latches on (reanchored & fcsm==4) held ~160 ms and DISARM-PARKs
    // the winscan FSM, replicating the manual `0x210C=0` escape hatch that the
    // silicon recipe takes. Silicon-validated 10/10 all channels at cd2db38.
    //
    // DEFAULT = 1'b1. Deliberate; the reasoning:
    //  1. BIT-EQUIVALENCE (mandatory): the FPGA image is validated WITH the
    //     retire. Defaulting 0 here would silently REVERT the validated
    //     bitstream to the known-livelocking B->A 0/10 behaviour — the exact
    //     class of regression the NEGO_CFG_RESET precedent warns about
    //     (plumbed, never forwarded => every bitstream silently built 7'h00).
    //  2. NOT A SILENT CHIP-DEFAULT: the retire SET is *already* gated on the
    //     raw armed conjunction (nego_en & role_locked & train_auto_en). The
    //     autonomy opt-in gate is NEGO_CFG_RESET, whose tidelink_top default
    //     is the safe 7'h00 => nego_en=0 => the retire can NEVER fire on a
    //     default ASIC integration regardless of RETIRE_EN. So 1'b1 changes
    //     behaviour for nobody who has not ALREADY consciously opted into
    //     autonomy by strapping NEGO_CFG_RESET != 0.
    //  3. FAIL-SAFE DIRECTION: an ASIC that DOES strap nego_en wants autonomy
    //     that WORKS. RETIRE_EN=0 + nego_en=1 is precisely the broken
    //     configuration (winscan livelock, B->A dead). Defaulting 0 would ship
    //     the known-bad autonomy to any integration that straps 7'h61.
    // The F4 gap is closed by making RETIRE_EN EXPRESSIBLE at the top (and on
    // the packaged IP face), not by flipping the default: the ASIC integration
    // can now set 0 or wire a bond strap without editing the controller.
    parameter        RETIRE_EN            = 1'b1,
    // RX-FIFO TWIN 2 master enable. Forwards to
    // tidelink_fifo → tidelink_fifo_mem → tidelink_fifo_ctrl.ENABLE_AHB_WRITE.
    //   1'b1 (default, and the ASIC setting) = AHB CPU-write-into-RX is a
    //         SUPPORTED, FUNCTIONAL path (David, 2026-07-19).
    //   1'b0 = optional FC-write-only posture for an integration that wants it.
    // TWIN 2 (stray AHB write mis-frames the next FC packet) is closed by the
    // QUALIFIED write-side arm in tidelink_fifo_ctrl, NOT by this gate.
    parameter bit    ENABLE_AHB_WRITE     = 1'b1,
    // Terminal role from strap, not the I2C-NACK constant.
    // Forwards to axi_chiplet_controller.ROLE_FROM_STRAP → tidelink_autoneg.
    // DECISION (David, 2026-07-19): ENABLED GLOBALLY — default is now 1'b1.
    //   1'b1 (default) = NACK terminal role AND timeout fallback derive from
    //         role_strap_i, so a (master,slave) strap survives a dead I2C.
    //         The FPGA paired targets drive role_strap_i from a real AXI GPIO
    //         (0x4404_0000 bit 0, per-die from FPGAHUB_LOCAL_ROLE: die_a=0
    //         master, die_b=1 slave), so the FPGA inherits the correct pair.
    //   1'b0 = LEGACY trap: I2C NACK => slave, timeout => nego_fallback, so a
    //         dead I2C makes BOTH dies slave and autonomy is structurally dead.
    parameter bit    ROLE_FROM_STRAP      = 1'b1,
    // Forwards to axi_chiplet_controller.TRAIN_ENTRY_FALLBACK → tidelink_autoneg.
    // DEFAULT OFF (shipping behaviour unchanged). 1 = training-entry starts from
    // strap on a dead I2C bus, so the SYNC beacon lights and the link can
    // self-start without a peer I2C ACK — the training-side completion of #3.
    parameter bit    TRAIN_ENTRY_FALLBACK = 1'b0,
    // Forwards to axi_chiplet_controller.SELF_ARM_TRAIN_EN (I1 eth-chiplet
    // bring-up fix, docs/I1_SELFARM_FIX.md). DEFAULT OFF — every existing target
    // is byte-behaviour-identical. When 1, a SW W1S of ROLE_CFG[1] self-latches
    // role_lock without the peer mask-handshake gate (the eth-chiplet's peer-I2C
    // control plane never completes). Enabled ONLY on the eth-chiplet's
    // tidelink_top instantiation (nanosoc_eth_chiplet.sv passes 1'b1); the
    // standalone-link FPGA/ASIC wrappers keep the default OFF.
    parameter bit    SELF_ARM_TRAIN_EN    = 1'b0,
    // Forwards to axi_chiplet_controller.AUTO_ANCHOR_EN (2026-08-04): on link-up,
    // pulse the SYNC beacon once (TX-idle-gated) to latch the deskew re-anchor on
    // the SELF_ARM path. DEFAULT OFF; nanosoc_eth_chiplet.sv passes 1'b1.
    parameter bit    AUTO_ANCHOR_EN       = 1'b0,
    // Link-rate control registers (docs/D2D_RATE_CONTROL_ARCH.md). When 1, the
    // previously undecoded APB quadrant 11 (apb_paddr[14:13]==2'b11, SoC
    // 0x2E03_6000 on the ethernet chiplet) is populated with
    // tidelink_link_rate_regs, and its ratio takes over u_link_clk_div.ratio_i
    // through a STICKY source mux once software has written CTRL at least once.
    //
    // DEFAULT OFF, and the OFF build is behaviourally identical to the build
    // before this parameter existed: BOTH the register instance AND the source
    // mux live inside the generate below, so at 1'b0 the divider's ratio_i is
    // the link_clk_div_ratio_i port itself (a plain alias, no mux), quadrant 11
    // keeps its old read-as-zero / pready=1 fall-through, and no flop is added.
    // The feature is NOT confined to that generate, though — apb_sel_rate, the
    // rate_* response wires and the u_link_clk_div port bindings are at module
    // scope in both arms. The block comment at g_link_rate_regs enumerates that
    // residue, says why each item is inert at 1'b0, and says what a real revert
    // has to touch.
    parameter bit    LINK_RATE_REGS_PRESENT = 1'b0
)(
    // --------------------------------------------------------------------------
    // Clock and Reset
    // --------------------------------------------------------------------------
    input  wire                     hclk,           // AHB / application clock
    input  wire                     hresetn,        // Active-low reset
    input  wire                     poresetn,       // Power-on reset (active-low)
    input  wire                     phc_clk,        // PHC clock (may differ from hclk)
    input  wire                     phc_resetn,     // PHC reset (active-low)

    // --------------------------------------------------------------------------
    // AHB Subordinate — Regular AHB access to remote side
    // (via XHB500 AHB→AXI → Wlink → remote XHB500 AXI→AHB)
    // --------------------------------------------------------------------------
    input  wire                     ahb_sub_hsel,
    input  wire  [SYS_ADDR_W-1:0]  ahb_sub_haddr,
    input  wire               [2:0] ahb_sub_hburst,
    input  wire               [3:0] ahb_sub_hprot,
    input  wire               [2:0] ahb_sub_hsize,
    input  wire               [1:0] ahb_sub_htrans,
    input  wire  [SYS_DATA_W-1:0]  ahb_sub_hwdata,
    input  wire                     ahb_sub_hwrite,
    input  wire                     ahb_sub_hready,
    output wire  [SYS_DATA_W-1:0]  ahb_sub_hrdata,
    output wire                     ahb_sub_hresp,
    output wire                     ahb_sub_hreadyout,

    // BURST FIX (2026-08-18): per-BEAT W-consumption strobe for the chiplet's
    // peer-write data-hold re-arm. = internal s_axi_wvalid & s_axi_wready (the
    // XHB500 u_xhb_sub W handshake). Replaces a downward hierarchical reference
    // from nanosoc_eth_chiplet into u_tidelink. Plain observability output; no
    // existing tb wires it (unobserved, not X).
    output wire                     ahb_sub_w_beat_consumed_o,

    // --------------------------------------------------------------------------
    // AHB Subordinate — TideLink TX Aperture
    // (direct to TideLink FC node, same size as remote RX FIFO)
    // --------------------------------------------------------------------------
    input  wire                     ahb_tx_hsel,
    input  wire  [RAM_ADDR_W-1:0]  ahb_tx_haddr,
    input  wire               [1:0] ahb_tx_htrans,
    input  wire               [2:0] ahb_tx_hsize,
    input  wire                     ahb_tx_hwrite,
    input  wire  [SYS_DATA_W-1:0]  ahb_tx_hwdata,
    input  wire                     ahb_tx_hready,
    output wire  [SYS_DATA_W-1:0]  ahb_tx_hrdata,
    output wire                     ahb_tx_hresp,
    output wire                     ahb_tx_hreadyout,

    // --------------------------------------------------------------------------
    // AHB Subordinate — Local RX FIFO data window (read received packets)
    // --------------------------------------------------------------------------
    input  wire                     ahb_fifo_hsel,
    input  wire   [RAM_ADDR_W-1:0]  ahb_fifo_haddr,
    input  wire               [1:0] ahb_fifo_htrans,
    input  wire               [2:0] ahb_fifo_hsize,
    input  wire                     ahb_fifo_hwrite,
    input  wire   [SYS_DATA_W-1:0]  ahb_fifo_hwdata,
    input  wire                     ahb_fifo_hready,
    output wire   [SYS_DATA_W-1:0]  ahb_fifo_hrdata,
    output wire                     ahb_fifo_hresp,
    output wire                     ahb_fifo_hreadyout,

    // --------------------------------------------------------------------------
    // AHB Manager — Incoming from remote side (via XHB500 AXI→AHB)
    // --------------------------------------------------------------------------
    output wire    [SYS_ADDR_W-1:0] ahb_mng_haddr,
    output wire               [2:0] ahb_mng_hburst,
    output wire               [6:0] ahb_mng_hprot,
    output wire               [2:0] ahb_mng_hsize,
    output wire               [1:0] ahb_mng_htrans,
    output wire    [SYS_DATA_W-1:0] ahb_mng_hwdata,
    output wire                     ahb_mng_hwrite,
    // HREADY flows slave→manager in AHB. tidelink_top is the manager
    // on this bus (the chiplet drives transactions out into the local
    // SoC fabric), so HREADY is an input — the slave's ready signal
    // back to the manager. Formality LEC flagged the previous `output`
    // declaration as a directly-undriven primary output port.
    input  wire                     ahb_mng_hready,
    input  wire    [SYS_DATA_W-1:0] ahb_mng_hrdata,
    input  wire                     ahb_mng_hresp,

    // --------------------------------------------------------------------------
    // APB Subordinate — Unified configuration port
    //   0x0000-0x1FFF: Wlink chiplet controller (PHY, link, FC nodes)
    //   0x2000-0x203F: TideLink FIFO config + PTP registers
    // --------------------------------------------------------------------------
    input  wire              [14:0] apb_paddr,
    input  wire                     apb_penable,
    input  wire                     apb_pwrite,
    input  wire               [3:0] apb_pstrb,
    input  wire               [2:0] apb_pprot,
    input  wire  [SYS_DATA_W-1:0]  apb_pwdata,
    input  wire                     apb_psel,
    output wire  [SYS_DATA_W-1:0]  apb_prdata,
    output wire                     apb_pready,
    output wire                     apb_pslverr,

    // --------------------------------------------------------------------------
    // Scan / DFT
    // --------------------------------------------------------------------------
    input  wire                     scan_mode,
    input  wire                     scan_asyncrst_ctrl,
    input  wire                     scan_clk,
    input  wire                     scan_shift,
    input  wire                     scan_in,
    output wire                     scan_out,

    // --------------------------------------------------------------------------
    // Reference clock for Wlink PLL
    // --------------------------------------------------------------------------
    input  wire                     user_ref_clk,

    // --------------------------------------------------------------------------
    // Link-clock divider ratio (quasi-static, integration-driven)
    //
    // 0=/1 bypass, 1=/2, 2=/4, 3=/8, 4=/16. Lowers the D2D bit rate at bring-up
    // to open a marginal receive eye without moving the SoC system clock. See
    // tidelink_link_clk_div.sv for the safety properties.
    //
    // SAFE TO LEAVE UNCONNECTED. An undriven (X) ratio never satisfies the
    // divider's two-consecutive-samples-equal filter, so the ratio register
    // holds its RATIO_RESET value and the module stays in /1 bypass — i.e.
    // byte-behaviour-identical to this module before the divider existed.
    // That property is deliberate and load-bearing: it is what lets the ~20
    // existing cocotb tb_top.sv instantiations stay untouched, and what lets
    // the compute chiplet pick this up on its next bump without a coordinated
    // change. Do not "improve" the filter into something X-optimistic.
    // --------------------------------------------------------------------------
    input  wire               [2:0] link_clk_div_ratio_i,

    // --------------------------------------------------------------------------
    // PHY Pads (width depends on NUM_PHY_LANES: 1 for GPIO, 8 for SerDes)
    // --------------------------------------------------------------------------
    output wire                              pad_clk_tx,
    output wire        [NUM_PHY_LANES-1:0]   pad_tx,
    input  wire                              pad_clk_rx,
    input  wire        [NUM_PHY_LANES-1:0]   pad_rx,

    // SoC Labs §9 IDELAYE2 RX delay: 200 MHz IDELAYCTRL reference clock.
    // Used only when USE_IDELAY=1 (FPGA). Tie 1'b0 in sim / ASIC — the
    // controller's tidelink_idelay_rx is pure passthrough then.
    input  wire                              idelay_ref_clk,

    // --------------------------------------------------------------------------
    // AHB Subordinate — PTP TX Write Port
    // (CPU writes here to trigger PTP FC messages)
    // --------------------------------------------------------------------------
    input  wire                     ahb_ptp_hsel,
    input  wire               [3:0] ahb_ptp_haddr,
    input  wire               [1:0] ahb_ptp_htrans,
    input  wire               [2:0] ahb_ptp_hsize,
    input  wire                     ahb_ptp_hwrite,
    input  wire  [SYS_DATA_W-1:0]  ahb_ptp_hwdata,
    input  wire                     ahb_ptp_hready,
    output wire  [SYS_DATA_W-1:0]  ahb_ptp_hrdata,
    output wire                     ahb_ptp_hresp,
    output wire                     ahb_ptp_hreadyout,

    // --------------------------------------------------------------------------
    // PHC Hardware Capture Output (directly to external PHC hw_capture input)
    // --------------------------------------------------------------------------
    output wire                     phc_hw_capture,

    // --------------------------------------------------------------------------
    // PHC Time Inputs (from external PHC, for hardware sync initiator)
    // --------------------------------------------------------------------------
    input  wire              [29:0] phc_nanoseconds,
    input  wire              [47:0] phc_seconds,
    input  wire                     phc_pps,

    // --------------------------------------------------------------------------
    // PHC Hardware Capture Inputs (from external PHC, for servo timestamp capture)
    // --------------------------------------------------------------------------
    input  wire              [47:0] phc_hw_cap_seconds,
    input  wire              [29:0] phc_hw_cap_nanoseconds,
    input  wire  [SYS_DATA_W-1:0]  phc_hw_cap_sub_nanoseconds,

    // --------------------------------------------------------------------------
    // PHC Hardware Adjustment Outputs (from servo to external PHC)
    // --------------------------------------------------------------------------
    output wire                     phc_hw_set_time,
    output wire              [47:0] phc_hw_set_seconds,
    output wire              [29:0] phc_hw_set_nanoseconds,
    output wire                     phc_hw_adj_valid,
    output wire    [SYS_DATA_W-1:0] phc_hw_adj_ns_incr_frac,

    // --------------------------------------------------------------------------
    // External PHC Lock Gate (for multi-hop PTP chaining)
    // When PHC_LOCK_GATE_EN=1, gates HW sync initiator on this signal.
    // Tie to 1'b1 for single-link deployments.
    // --------------------------------------------------------------------------
    input  wire                     phc_locked_i,

    // --------------------------------------------------------------------------
    // Servo Status
    // --------------------------------------------------------------------------
    output wire                     servo_locked,

    // --------------------------------------------------------------------------
    // Interrupt Outputs
    // --------------------------------------------------------------------------
    output wire                     released_credits_irq,
    output wire                     doorbell_irq,
    output wire                     packet_committed_irq,
    output wire                     ptp_irq,
    output wire                     perf_irq,
    output wire                     wlink_irq,

    // --------------------------------------------------------------------------
    // TideChart AXI-Stream Port (for TideChart or other external modules)
    // Packets with pkt_type=2'b10 are routed to/from this port.
    // Subtype 0x0020 (PUF_READ_REQ) is handled locally by the FC adapter.
    // --------------------------------------------------------------------------
    input  wire                     tc_axis_tx_tvalid,
    input  wire    [FC_DATA_W-1:0]  tc_axis_tx_tdata,
    output wire                     tc_axis_tx_tready,

    output wire                     tc_axis_rx_tvalid,
    output wire    [FC_DATA_W-1:0]  tc_axis_rx_tdata,
    input  wire                     tc_axis_rx_tready,

    // --------------------------------------------------------------------------
    // QoS Priority Hint (Phase 5A, from TideChart TC_QOS_CFG register)
    // When >0: TideChart PKT_EXT packets are prioritised above FIFO_DATA
    // When =0: original fixed priority (FIFO_DATA may win over PKT_EXT)
    // --------------------------------------------------------------------------
    input  wire               [2:0] tc_qos_priority,

    // --------------------------------------------------------------------------
    // Congestion sideband (Phase 1, to TideChart link-state agent)
    // Pure combinational: same hclk domain as everything else in this module.
    // See docs/../../../tidechart/docs/CONGESTION_AWARE_ROUTING.md.
    //   tl_local_link_state_o = {starve, trend[1:0], level[1:0]}
    //   tl_link_state_change_o = one-cycle pulse on any quantised transition
    //   tl_bcast_ack_i = level-sensitive, clears starve-sticky after broadcast
    // --------------------------------------------------------------------------
    output wire               [4:0] tl_local_link_state_o,
    output wire                     tl_link_state_change_o,
    output wire              [12:0] tl_ewma_credit_o,
    input  wire                     tl_bcast_ack_i,

    // --------------------------------------------------------------------------
    // Link active status (Wlink link layer is up and operational)
    // --------------------------------------------------------------------------
    output wire                     link_active,

    // --------------------------------------------------------------------------
    // Data-mode strobe (TideChart election sequencing contract — G1 dual-root)
    // See docs/TIDECHART_G1_SEQUENCING_CONTRACT.md.
    //
    // 1 = the Wlink link layer has reached its credit/data-exchange region
    // (FCSM state >= 4), i.e. the link genuinely CARRIES FC/EXT words.
    //
    // This is DISTINCT from link_active above. link_active == role_locked_o,
    // which asserts ~5us EARLIER, at role-lock, when the link cannot yet carry
    // anything. TideChart's root election MUST be gated on this port, not on
    // link_active: gating on link_active lets both dies settle their election
    // before any CLAIM crosses the die boundary, producing a silent dual-root
    // (neither die installs an uplink, enumeration never crosses the boundary).
    //
    // Domain: apb_clk (== hclk in all current integrations). Already CDC-synced
    // inside the chiplet controller; it is a direct flop output, so it is a
    // clean, glitch-free level. link_active/role_locked_o keep their existing
    // meaning and existing users (d2d TX aperture, status/LEDs) unchanged.
    // --------------------------------------------------------------------------
    output wire                     tl_data_mode_o,

    // --------------------------------------------------------------------------
    // Reset output
    // --------------------------------------------------------------------------
    output wire                     d2d_reset_o,

    // --------------------------------------------------------------------------
    // Chiplet Controller Role Selection
    // --------------------------------------------------------------------------
    input  wire                     role_strap_i,
    output wire                     role_is_master_o,
    output wire                     role_locked_o,
    input  wire                     apb_debug_unlock_i,
    input  wire                     mask_hs_bypass_i,

    // --------------------------------------------------------------------------
    // Auto-Negotiation
    // --------------------------------------------------------------------------
    input  wire [15:0]              nego_priority_i,    // External negotiation priority (OTP/UID)
    input  wire [15:0]              puf_seed,           // From TideChart PUF sampler
    input  wire                     puf_ready,          // PUF sampling complete
    output wire                     nego_error_irq,     // Negotiation error interrupt
    // Phase 1 autonomy G1b: sticky IRQ asserted when the autoneg FSM enters
    // ST_TRAIN_FAIL (see deps/axi-chiplet-controller/logical/top/tidelink_autoneg.sv
    // line 1665). Latched and W1C-cleared inside u_chiplet_controller —
    // Region 8 slot 3'h3 bit[16] (MMIO 0x4403_210C). Kept separate from
    // nego_error_irq so existing handlers don't get re-routed.
    output wire                     train_fail_irq,

    // --------------------------------------------------------------------------
    // I2C Sideband (open-drain tristate)
    // --------------------------------------------------------------------------
    input  wire                     i2c_scl_i,
    output wire                     i2c_scl_o,
    output wire                     i2c_scl_t,
    input  wire                     i2c_sda_i,
    output wire                     i2c_sda_o,
    output wire                     i2c_sda_t,

    // --------------------------------------------------------------------------
    // I2C Sideband AXI (master mode: CPU → I2C master → remote)
    // --------------------------------------------------------------------------
    input  wire                     s_i2c_axi_awvalid,
    input  wire               [1:0] s_i2c_axi_awid,
    input  wire               [3:0] s_i2c_axi_awaddr,
    input  wire               [7:0] s_i2c_axi_awlen,
    input  wire               [2:0] s_i2c_axi_awsize,
    input  wire               [1:0] s_i2c_axi_awburst,
    input  wire                     s_i2c_axi_awlock,
    input  wire               [3:0] s_i2c_axi_awcache,
    input  wire               [2:0] s_i2c_axi_awprot,
    output wire                     s_i2c_axi_awready,
    input  wire                     s_i2c_axi_wvalid,
    input  wire  [SYS_DATA_W-1:0]  s_i2c_axi_wdata,
    input  wire               [3:0] s_i2c_axi_wstrb,
    input  wire                     s_i2c_axi_wlast,
    output wire                     s_i2c_axi_wready,
    output wire                     s_i2c_axi_bvalid,
    output wire               [1:0] s_i2c_axi_bid,
    output wire               [1:0] s_i2c_axi_bresp,
    input  wire                     s_i2c_axi_bready,
    input  wire                     s_i2c_axi_arvalid,
    input  wire               [1:0] s_i2c_axi_arid,
    input  wire               [3:0] s_i2c_axi_araddr,
    input  wire               [7:0] s_i2c_axi_arlen,
    input  wire               [2:0] s_i2c_axi_arsize,
    input  wire               [1:0] s_i2c_axi_arburst,
    input  wire                     s_i2c_axi_arlock,
    input  wire               [3:0] s_i2c_axi_arcache,
    input  wire               [2:0] s_i2c_axi_arprot,
    output wire                     s_i2c_axi_arready,
    output wire                     s_i2c_axi_rvalid,
    output wire               [1:0] s_i2c_axi_rid,
    output wire  [SYS_DATA_W-1:0]  s_i2c_axi_rdata,
    output wire               [1:0] s_i2c_axi_rresp,
    output wire                     s_i2c_axi_rlast,
    input  wire                     s_i2c_axi_rready,

    // --------------------------------------------------------------------------
    // I2C Interrupts
    // --------------------------------------------------------------------------
    output wire                     i2c_nbsy_irq,
    output wire                     i2c_nrd_empty_irq
);

    // =========================================================================
    // Internal AXI wiring (XHB500 ↔ Chiplet Controller)
    // =========================================================================

    // AXI subordinate path (ahb_sub → XHB500 AHB→AXI → chiplet controller s_axi)
    wire [11:0]  s_axi_awid;
    wire [35:0]  s_axi_awaddr;
    wire  [7:0]  s_axi_awlen;
    wire  [2:0]  s_axi_awsize;
    wire  [1:0]  s_axi_awburst;
    wire         s_axi_awlock;
    wire  [3:0]  s_axi_awcache;
    wire  [2:0]  s_axi_awprot;
    wire  [3:0]  s_axi_awqos;
    wire         s_axi_awvalid;
    wire         s_axi_awready;

    wire [31:0]  s_axi_wdata;
    wire  [3:0]  s_axi_wstrb;
    wire         s_axi_wlast;
    wire         s_axi_wvalid;
    wire         s_axi_wready;

    // BURST FIX (2026-08-18): drive the new output from the internal per-beat W
    // handshake. This is TL-002's own wr_hold_clr WITHOUT the & s_axi_wlast term,
    // so it strobes on EVERY beat, not just the burst-final one — which is the
    // whole point: the chiplet's capture must re-arm per beat, not per burst.
    assign ahb_sub_w_beat_consumed_o = s_axi_wvalid & s_axi_wready;

    wire [11:0]  s_axi_bid;         // muxed: controller B, or synthetic SLVERR (F-1/F-2)
    wire  [1:0]  s_axi_bresp;
    wire         s_axi_bvalid;
    wire [11:0]  s_axi_bid_ctrl;    // real B from the chiplet controller (pre-mux)
    wire  [1:0]  s_axi_bresp_ctrl;
    wire         s_axi_bvalid_ctrl;
    wire         s_axi_bready;

    wire [11:0]  s_axi_arid;
    wire [35:0]  s_axi_araddr;
    wire  [7:0]  s_axi_arlen;
    wire  [2:0]  s_axi_arsize;
    wire  [1:0]  s_axi_arburst;
    wire         s_axi_arlock;
    wire  [3:0]  s_axi_arcache;
    wire  [2:0]  s_axi_arprot;
    wire  [3:0]  s_axi_arqos;
    wire         s_axi_arvalid;
    wire         s_axi_arready;

    wire [11:0]  s_axi_rid;
    wire [31:0]  s_axi_rdata;
    wire  [1:0]  s_axi_rresp;
    wire         s_axi_rlast;
    wire         s_axi_rvalid;
    wire         s_axi_rready;

    // AXI manager path (chiplet controller m_axi → XHB500 AXI→AHB → ahb_mng)
    wire [11:0]  m_axi_awid;
    wire [35:0]  m_axi_awaddr;
    wire  [7:0]  m_axi_awlen;
    wire  [2:0]  m_axi_awsize;
    wire  [1:0]  m_axi_awburst;
    wire         m_axi_awlock;
    wire  [3:0]  m_axi_awcache;
    wire  [2:0]  m_axi_awprot;
    wire  [3:0]  m_axi_awqos;
    wire         m_axi_awvalid;
    wire         m_axi_awready;

    wire [31:0]  m_axi_wdata;
    wire  [3:0]  m_axi_wstrb;
    wire         m_axi_wlast;
    wire         m_axi_wvalid;
    wire         m_axi_wready;

    wire [11:0]  m_axi_bid;
    wire  [1:0]  m_axi_bresp;
    wire         m_axi_bvalid;
    wire         m_axi_bready;

    wire [11:0]  m_axi_arid;
    wire [35:0]  m_axi_araddr;
    wire  [7:0]  m_axi_arlen;
    wire  [2:0]  m_axi_arsize;
    wire  [1:0]  m_axi_arburst;
    wire         m_axi_arlock;
    wire  [3:0]  m_axi_arcache;
    wire  [2:0]  m_axi_arprot;
    wire  [3:0]  m_axi_arqos;
    wire         m_axi_arvalid;
    wire         m_axi_arready;

    wire [11:0]  m_axi_rid;
    wire [31:0]  m_axi_rdata;
    wire  [1:0]  m_axi_rresp;
    wire         m_axi_rlast;
    wire         m_axi_rvalid;
    wire         m_axi_rready;

    // =========================================================================
    // TideLink FC Node wiring (FC adapter ↔ Chiplet Controller)
    // =========================================================================
    // Separate valid/ready/data signals (used by FC adapter)
    // mark_debug — Bug A probes per docs/ILA_PLACEMENT_AUDIT_2026_05_29.md §3
    // (master FC TX boundary + slave FC RX boundary). hclk-native, captured by
    // u_dbg_int via insert_debug_core.tcl auto-scrape.
    wire                   tl_fc_a2l_valid;
    wire [FC_DATA_W-1:0]   tl_fc_a2l_data;
    wire                   tl_fc_a2l_ready;
    wire                   tl_fc_l2a_valid;
    wire [FC_DATA_W-1:0]   tl_fc_l2a_data;
    wire                   tl_fc_l2a_accept;

    // =========================================================================
    // PTP Short Packet wiring (PTP module ↔ Chiplet Controller)
    // =========================================================================
    // mark_debug on PHC short-packet boundary nets — ILA capture per
    // docs/PHC_PHASE1_HW_REPORT.md §"Build #13 + Proposal #3"
    // (feat/phc-ila-debug). hclk-domain, captured by insert_debug_core.tcl.
    wire                   ptp_sp_tx_valid;
    wire            [7:0]  ptp_sp_tx_data_id;
    wire           [15:0]  ptp_sp_tx_payload;
    wire                   ptp_sp_tx_ready;
    wire                   ptp_sp_rx_valid;
    wire            [7:0]  ptp_sp_rx_data_id;
    wire           [15:0]  ptp_sp_rx_payload;
    wire                   ptp_sp_rx_accept;

    // TX link idle signal from chiplet controller (Wlink tx_link_idle output)
    // Directly driven by .tx_link_idle port on the Wlink instance
    // mark_debug — Bug B probe (HW_SYNC defer gate) per audit §4
    wire                   tx_router_idle;

    // PTP register interface (PTP module ↔ APB regs, via pass-through)
    wire                   ptp_reg_write;
    wire            [2:0]  ptp_reg_addr;
    wire [SYS_DATA_W-1:0] ptp_reg_wdata;
    wire [SYS_DATA_W-1:0] ptp_reg_rdata;
    wire                   ptp_reg_region;

    // Servo register interface (servo ↔ APB regs, via pass-through)
    wire                   servo_reg_write;
    wire            [2:0]  servo_reg_addr;
    wire [SYS_DATA_W-1:0] servo_reg_wdata;
    wire [SYS_DATA_W-1:0] servo_reg_rdata;

    // Servo mailbox interface (FC RX SIDEBAND → servo timestamp mailbox)
    wire                   mbox_reg_write;
    wire            [2:0]  mbox_reg_addr;
    wire [SYS_DATA_W-1:0] mbox_reg_wdata;

    // Chiplet controller register interface (APB regs Regions 4 + 8 + C ↔ controller).
    // ctrl_reg_addr is 5 bits — bits[2:0] are the slot within the region;
    // bits[4:3] are the region selector:
    //   2'b01 → Region 4 (slots 0..7, 0x080..0x09C, ROLE/I²C/NEGO)
    //   2'b10 → Region 8 (slots 0..7, 0x100..0x11C, PHY-align / I²C-train)
    //   2'b11 → Region C (slots 0..7, 0x180..0x19C, Bug N7/N8 silicon
    //                     observability — autoneg probe registers, RO)
    wire                   ctrl_reg_write;
    wire            [4:0]  ctrl_reg_addr;
    // SoC Labs perlane-wp (2026-06-16): Region 10 (SoC 0x2144/0x2148/0x214C)
    // select from tidelink_apb_regs into the chiplet controller (the sweep
    // oracle + per-lane word-pin registers). V1 ties it low (bit-identical).
    wire                   ctrl_reg_r10;
    // SoC Labs RX-FRAMER long-DATA STICKY CAPTURE 2026-06-21 (rxcap): Region D
    // (SoC 0x4403_21A0-0x4403_21A8) select from tidelink_apb_regs into the
    // chiplet controller. V1 ties it low (bit-identical).
    wire                   ctrl_reg_rd;
    // SoC Labs AXI data-node observability 2026-07-29 (I4): Region F
    // (SoC 0x4403_21E0) select from tidelink_apb_regs into the chiplet
    // controller (OBS_AXI_NODES). LIVE in both V1 and V2.
    wire                   ctrl_reg_rf;
    wire [SYS_DATA_W-1:0] ctrl_reg_wdata;
    wire [SYS_DATA_W-1:0] ctrl_reg_rdata;

    // Performance profiling register interface (APB regs Regions 5-7 ↔ perf)
    wire                   perf_reg_write;
    wire            [2:0]  perf_reg_addr;
    wire [SYS_DATA_W-1:0] perf_reg_wdata;
    wire [SYS_DATA_W-1:0] perf_reg_rdata;
    wire            [1:0]  perf_reg_region;
    wire [RAM_ADDR_W-2:0]  perf_credit_count;

    // Servo ↔ PTP event signals
    wire                   sync_tx_done;
    wire                   dreq_tx_done;
    wire                   sync_rx_done;
    wire                   dreq_rx_done;
    wire                   servo_dreq_trigger;

    // Servo ↔ FC adapter (SIDEBAND injection)
    wire                   servo_fc_valid;
    wire [FC_DATA_W-1:0]  servo_fc_data;
    wire                   servo_fc_ready;

    // =========================================================================
    // PHC CDC intermediate wires (hclk-domain ↔ tidelink_phc_cdc ↔ phc_clk)
    // =========================================================================
    // _raw signals: hclk-domain outputs from u_ptp / u_servo (before CDC)
    // _sync signals: hclk-domain inputs to u_ptp / u_servo (after CDC)
    wire                    phc_hw_capture_raw;     // from u_ptp → CDC → PHC
    wire             [29:0] phc_nanoseconds_sync;   // from PHC → CDC → u_ptp
    wire             [47:0] phc_seconds_sync;        // from PHC → CDC → u_ptp
    wire                    phc_pps_sync;            // from PHC → CDC → u_ptp
    wire             [47:0] phc_hw_cap_seconds_sync;       // from PHC → CDC → u_servo
    wire             [29:0] phc_hw_cap_nanoseconds_sync;   // from PHC → CDC → u_servo
    wire [SYS_DATA_W-1:0]  phc_hw_cap_sub_nanoseconds_sync;
    wire                    phc_hw_set_time_raw;           // from u_servo → CDC → PHC
    wire             [47:0] phc_hw_set_seconds_raw;
    wire             [29:0] phc_hw_set_nanoseconds_raw;
    wire                    phc_hw_adj_valid_raw;
    wire [SYS_DATA_W-1:0]  phc_hw_adj_ns_incr_frac_raw;

    // =========================================================================
    // Returner AHB master wiring (tidelink_fifo_ahb → FC adapter interception)
    // =========================================================================
    wire [SYS_ADDR_W-1:0]  rtn_haddr;
    wire [SYS_DATA_W-1:0]  rtn_hwdata;
    wire              [1:0] rtn_htrans;
    wire              [2:0] rtn_hsize;
    wire                    rtn_hwrite;
    wire                    rtn_hready;
    wire                    rtn_hresp;
    wire [SYS_DATA_W-1:0]  rtn_hrdata;

    // =========================================================================
    // FC adapter RX direct write wiring (single-cycle, replaces AHB mux)
    // =========================================================================
    wire                    fc_rx_fifo_valid;
    wire                    fc_rx_fifo_write;
    wire [RAM_ADDR_W-1:0]  fc_rx_fifo_addr;
    wire [SYS_DATA_W-1:0]  fc_rx_fifo_wdata;
    // mark_debug — Bug A probe (back-pressure from FIFO controller) per audit §3
    wire                    fc_rx_fifo_ready;

    // SoC Labs Bug-A FCSM observation 2026-06-02 — apb_clk synced gate
    // signals for the FCSM state-4 → state-5 transition, exposed by
    // u_chiplet_controller. mark_debug + dont_touch + keep_hierarchy is
    // needed because the signal chain from WlinkGenericFCSM_6 has no
    // logical sink outside dbg_hub — without dont_touch Vivado optimizes
    // the whole chain away. (mark_debug alone works for fc_rx_fifo_wdata
    // because it has real downstream logic sinks; obs_* don't.)
    wire        obs_a2l_replay_link_valid_w;
    wire [7:0]  obs_fe_rx_credit_max_w;
    wire        obs_fe_rx_is_full_w;
    // SoC Labs Bug-A FCSM observation 2026-06-03
    wire        obs_a2l_replay_app_valid_w;

    // PUF SRAM read path (FC adapter ↔ FIFO)
    wire [RAM_ADDR_W-3:0]  puf_addr;
    wire                    puf_req;
    wire [31:0]             puf_rdata;
    wire                    puf_ack;

    // FC adapter RX config path — APB-native
    wire [APB_ADDR_W-1:0]  fc_cfg_apb_paddr;
    wire [SYS_DATA_W-1:0]  fc_cfg_apb_pwdata;
    wire                    fc_cfg_apb_psel;
    wire                    fc_cfg_apb_penable;
    wire                    fc_cfg_apb_pwrite;
    wire [SYS_DATA_W-1:0]  fc_cfg_apb_prdata;
    wire                    fc_cfg_apb_pready;
    wire                    fc_cfg_apb_pslverr;

    // =========================================================================
    // Unified APB address decode
    //   paddr[14:13] == 00 → Wlink chiplet controller (paddr[12:0])
    //   paddr[14:13] == 01 → TideLink config registers (paddr[11:0])
    //   paddr[14:13] == 10 → Address translator config (paddr[12:0])
    //   paddr[14:13] == 11 → Link-rate control registers (paddr[12:0]),
    //                        populated only when LINK_RATE_REGS_PRESENT=1.
    //                        With the parameter at its 1'b0 default this
    //                        quadrant behaves exactly as the "Reserved,
    //                        undecoded" quadrant it used to be: reads return
    //                        zero, pready is 1, pslverr is 0 — see the
    //                        rate_* constant tie-off in the generate below.
    // =========================================================================
    wire apb_sel_wlink     = apb_psel && !apb_paddr[14] && !apb_paddr[13];
    wire apb_sel_tidelink  = apb_psel && !apb_paddr[14] &&  apb_paddr[13];
    wire apb_sel_addr_xlat = apb_psel &&  apb_paddr[14] && !apb_paddr[13];
    wire apb_sel_rate      = apb_psel &&  apb_paddr[14] &&  apb_paddr[13];

    // Wlink APB response signals
    wire [SYS_DATA_W-1:0] wlink_prdata;
    wire                   wlink_pready;
    wire                   wlink_pslverr;

    // TideLink regs APB response signals (from APB mux below)
    wire [SYS_DATA_W-1:0] tl_regs_prdata;
    wire                   tl_regs_pready;
    wire                   tl_regs_pslverr;

    // Address translator APB response signals
    wire [SYS_DATA_W-1:0] adr_xlat_prdata;
    wire                   adr_xlat_pready;
    wire                   adr_xlat_pslverr;

    // Link-rate regs APB response signals. Driven either by the register bank
    // or, at LINK_RATE_REGS_PRESENT=0, by the constants that reproduce the old
    // undecoded fall-through exactly ('0 / 1'b1 / 1'b0) — see g_link_rate_*
    // beside u_link_clk_div.
    wire [SYS_DATA_W-1:0] rate_prdata;
    wire                   rate_pready;
    wire                   rate_pslverr;

    // Unified APB response mux
    assign apb_prdata  = apb_sel_wlink     ? wlink_prdata     :
                         apb_sel_tidelink  ? tl_regs_prdata   :
                         apb_sel_addr_xlat ? adr_xlat_prdata  :
                         apb_sel_rate      ? rate_prdata      : '0;
    assign apb_pready  = apb_sel_wlink     ? wlink_pready     :
                         apb_sel_tidelink  ? tl_regs_pready   :
                         apb_sel_addr_xlat ? adr_xlat_pready  :
                         apb_sel_rate      ? rate_pready      : 1'b1;
    assign apb_pslverr = apb_sel_wlink     ? wlink_pslverr    :
                         apb_sel_tidelink  ? tl_regs_pslverr  :
                         apb_sel_addr_xlat ? adr_xlat_pslverr :
                         apb_sel_rate      ? rate_pslverr     : 1'b0;

    // =========================================================================
    // TideLink config APB mux: 2:1 TRANSACTION-ATOMIC arbiter
    //   Source 0: FC adapter RX config (fc_cfg_apb_*, APB-native; peer
    //             credit/doorbell/returner config writes)
    //   Source 1: external unified APB port (PS CPU reads/writes to Region 8)
    //
    // The FC config port must NEVER preempt an external PS access that is already
    // in its ACCESS phase.  On the Zynq-7000 M_AXI_GP there is NO bus timeout, so
    // a preempted PS access hangs the CPU for ever (Bus error on every later
    // access).  The FC adapter, by contrast, tolerates pready backpressure -- its
    // RX FSM (tidelink_fc_adapter.sv:588-630) holds psel/paddr/pwdata stable and
    // waits on fc_rx_cfg_pready, and tidelink_apb_regs acks combinationally
    // (fifo/tidelink_apb_regs.sv:650, pready=1'b1), so a held-off FC waits at
    // most 1-2 cycles.  So the PS wins any conflict; the FC waits.
    //
    //   ext_txn    : an external Region-8 access is in its ACCESS phase (psel &
    //                penable) -- the exact window the old bare mux corrupted.
    //   ext_lock_q : registered grant, latched from the first STALLED external
    //                ACCESS cycle and held until the access is acked.  Belt &
    //                braces: even if a slow Region-10/11 shim slave stretches the
    //                access across many cycles, the FC can never slip in on an
    //                intermediate edge.  The bare !ext_txn term already covers the
    //                common single-cycle-ack case; the lock hardens the
    //                multi-cycle stall.
    // The FC config port is granted only when no external access owns or is
    // waiting for the bus.  (The bounded-stall watchdog that makes the PS bus
    // structurally hang-proof lives just below the tl_apb_* declarations, since
    // it references tl_apb_pready.)
    // =========================================================================
    wire ext_txn = apb_sel_tidelink && apb_penable;   // external in ACCESS phase

    reg  ext_lock_q;
    always_ff @(posedge hclk or negedge hresetn) begin
        if (!hresetn)
            ext_lock_q <= 1'b0;
        else if (ext_txn && !tl_regs_pready)          // access started, not yet acked
            ext_lock_q <= 1'b1;
        else if (tl_regs_pready)                       // access completed -> release
            ext_lock_q <= 1'b0;
    end

    wire fc_cfg_apb_active = fc_cfg_apb_psel && !ext_txn && !ext_lock_q;

    // SoC Labs mailbox-RO fix (2026-07-31): mbox_reg_write as computed by
    // tidelink_apb_regs.sv (fifo/tidelink_apb_regs.sv:527) is just
    // apb_write && Region-3-decode -- apb_write there is the raw shared-bus
    // psel&&penable&&pwrite with NO source qualifier, so it asserts for a
    // plain external APB write to 0x4403_2068 exactly the same as it does
    // for a genuine peer sideband injection. That silently let the CPU/debug
    // side overwrite mbox_sec_lo_r/mbox_sec_hi_r/mbox_ns_r -- the assembled
    // cross-die PTP timestamp -- even though this very port's comment always
    // said the mailbox is fed "from FC RX config path via APB": the FC peer
    // was always meant to be the ONLY legitimate writer, but nothing enforced
    // that structurally. Gated with fc_cfg_apb_active above -- the same signal
    // that already keeps the PEER from writing TXGEN over the link in the
    // opposite direction (see the "SECURITY" comment on txgen_reg_wr) -- it is
    // true only in the cycles the 2:1 tl_apb_* arbiter has granted the shared
    // bus to the FC adapter's RX config path, not the external PS/debug port.
    wire mbox_reg_write_fc_only = mbox_reg_write && fc_cfg_apb_active;

    // APB signals to tidelink_fifo APB slave
    wire [APB_ADDR_W-1:0]  tl_apb_paddr;
    wire                    tl_apb_psel;
    wire                    tl_apb_penable;
    wire                    tl_apb_pwrite;
    wire [SYS_DATA_W-1:0]  tl_apb_pwdata;
    wire [SYS_DATA_W-1:0]  tl_apb_prdata;
    wire                    tl_apb_pready;
    wire                    tl_apb_pslverr;

    // -------------------------------------------------------------------------
    // BOUNDED EXTERNAL STALL (belt & braces).  The arbitration above stops the FC
    // from starving the PS, but a genuinely stuck sub-slave (tl_apb_pready never
    // rising) would still hang the PS -- and the Zynq has no timeout of its own.
    // Saturate a counter on a stalled external ACCESS and, past the limit,
    // complete it with pready+pslverr so the PS bus is STRUCTURALLY incapable of
    // locking up.  ext_stall_err_q latches sticky (POR-cleared) for post-mortem
    // (waveform/ILA-visible; not APB-mapped -- no free obs-reg slot, see the
    // commit message).  EXT_STALL_LIMIT >> any legal ack (apb_regs acks in 1).
    // -------------------------------------------------------------------------
    localparam [10:0] EXT_STALL_LIMIT = 11'd1024;
    reg  [10:0] ext_stall_ctr_q;
    reg         ext_stall_err_q;
    wire ext_stalled = ext_txn && !tl_apb_pready && !fc_cfg_apb_active;
    wire ext_timeout = (ext_stall_ctr_q == EXT_STALL_LIMIT);

    always_ff @(posedge hclk or negedge hresetn) begin
        if (!hresetn) begin
            ext_stall_ctr_q <= 11'd0;
            ext_stall_err_q <= 1'b0;
        end else if (!ext_stalled) begin
            ext_stall_ctr_q <= 11'd0;                   // idle or completing -> reset
        end else if (ext_stall_ctr_q != EXT_STALL_LIMIT) begin
            ext_stall_ctr_q <= ext_stall_ctr_q + 11'd1;
            if (ext_stall_ctr_q == EXT_STALL_LIMIT - 11'd1)
                ext_stall_err_q <= 1'b1;                // latch sticky as it fires
        end
    end

    assign tl_apb_paddr   = fc_cfg_apb_active ? fc_cfg_apb_paddr   : apb_paddr[APB_ADDR_W-1:0];
    assign tl_apb_psel    = fc_cfg_apb_active ? fc_cfg_apb_psel    : apb_sel_tidelink;
    assign tl_apb_penable = fc_cfg_apb_active ? fc_cfg_apb_penable : apb_penable;
    assign tl_apb_pwrite  = fc_cfg_apb_active ? fc_cfg_apb_pwrite  : apb_pwrite;
    assign tl_apb_pwdata  = fc_cfg_apb_active ? fc_cfg_apb_pwdata  : apb_pwdata;

    // =========================================================================
    // v2 Eye visibility shim: tidelink_eye_regs (Region 10, paddr 0x140-0x17F).
    //
    // Same OR-mux pattern as the FCSM debug shim above: tidelink_apb_regs
    // returns 0 for the Region 10 range and the shim's prdata/pready/
    // pslverr are substituted at this scope when eye_shim_sel matches.
    //
    // The calibrator-side ports (swi_eye_*, eye_*) are wired through to
    // the calibrator inside u_chiplet_controller.  Until that submodule
    // is regenerated to expose the new ports on its boundary, the
    // calibrator-data inputs to the shim (eye_status_i and friends) are
    // tied off to 0 and the control outputs (swi_eye_ctrl, etc.) are
    // routed into the top-level so a follow-on commit can wire them via
    // hierarchical reference or via new chiplet-controller ports.
    // =========================================================================
    // =========================================================================
    // v1 PL-side TX traffic generator (docs/TXGEN_V1_DESIGN.md)
    // =========================================================================
    // APB Region E (paddr[8:5]==4'b1110, SoC 0x21C0-0x21DC). Regions E and F
    // were unclaimed: absent from the tidelink_apb_regs read mux, ctrl_reg_write,
    // the perf bound (<=4'b0111) and pslverr, and from every [8:5] compare here
    // and in the chiplet controller.
    //
    // SECURITY: WRITES are qualified with !fc_cfg_apb_active. The FC RX config
    // path shares this APB bus and carries a PEER-SUPPLIED offset, so without
    // this a mis-set PAIR_BASE or a faulty/hostile peer could arm our traffic
    // generator across the link.
    wire txgen_reg_sel = tl_apb_psel && (tl_apb_paddr[8:5] == 4'b1110);
    wire txgen_reg_wr  = txgen_reg_sel && tl_apb_penable && tl_apb_pwrite
                                       && !fc_cfg_apb_active;

    wire                    txgen_owns;
    wire [RAM_ADDR_W-1:0]  txgen_haddr;
    wire              [1:0] txgen_htrans;
    wire              [2:0] txgen_hsize;
    wire                    txgen_hwrite;
    wire [SYS_DATA_W-1:0]  txgen_hwdata;
    wire                    fc_tx_hreadyout;
    wire [SYS_DATA_W-1:0]  txgen_pair_credit;
    wire                    txgen_credit_consume_vld;
    wire [SYS_DATA_W-1:0]  txgen_credit_consume_val;
    wire [SYS_DATA_W-1:0]  txgen_prdata;

    // The external master sees the adapter's own hreadyout, EXCEPT while the
    // generator owns the port: an external beat arriving mid-packet must not be
    // silently accepted (that was the L11 watchdog's sin). Holding hreadyout
    // low stalls it honestly; the adapter's own TX_STALL_TIMEOUT remains the
    // backstop against an indefinite stall.
    assign ahb_tx_hreadyout = txgen_owns ? 1'b0 : fc_tx_hreadyout;

    // Effective credit-gate-disable: the shipping value is the TXGEN_CREDIT_GATE_DIS
    // parameter (POR 0 = gate ON). `TXGEN_FORCE_CREDIT_GATE_DIS` is a SIM-ONLY
    // define that forces it to 1 for the mandatory negative-control build (c3),
    // proving the peer DOES overrun without the gate. It must NEVER appear in a
    // shipping flist; with the define absent this is bit-identical to the param.
    localparam bit TXGEN_CGD_EFF = TXGEN_CREDIT_GATE_DIS
`ifdef TXGEN_FORCE_CREDIT_GATE_DIS
        | 1'b1
`endif
        ;

    generate
    if (TXGEN_PRESENT) begin : g_txgen
        tidelink_tx_gen #(
            .SYS_DATA_W      (SYS_DATA_W),
            .RAM_ADDR_W      (RAM_ADDR_W),
            .CREDIT_GATE_DIS (TXGEN_CGD_EFF)
        ) u_tx_gen (
            .hclk               (hclk),
            .hresetn            (hresetn),
            .reg_sel            (txgen_reg_sel),
            .reg_addr           (tl_apb_paddr[4:2]),
            .reg_write          (txgen_reg_wr),
            .reg_wdata          (tl_apb_pwdata),
            .reg_rdata          (txgen_prdata),
            .pair_credit_count  (txgen_pair_credit),
            .pair_credit_en     (1'b1),
            .credit_consume_vld (txgen_credit_consume_vld),
            .credit_consume_val (txgen_credit_consume_val),
            .gen_owns           (txgen_owns),
            .gen_haddr          (txgen_haddr),
            .gen_htrans         (txgen_htrans),
            .gen_hsize          (txgen_hsize),
            .gen_hwrite         (txgen_hwrite),
            .gen_hwdata         (txgen_hwdata),
            .fc_hreadyout       (fc_tx_hreadyout),
            .fc_hresp           (ahb_tx_hresp),
            .ext_htrans         (ahb_tx_htrans),
            .txgen_active       ()
        );
    end else begin : g_no_txgen
        // Tapeout arm: the block AND the mux vanish, so the netlist is
        // provably identical to a build that never had the generator.
        assign txgen_owns               = 1'b0;
        assign txgen_haddr              = '0;
        assign txgen_htrans             = 2'b00;
        assign txgen_hsize              = 3'b010;
        assign txgen_hwrite             = 1'b0;
        assign txgen_hwdata             = '0;
        assign txgen_credit_consume_vld = 1'b0;
        assign txgen_credit_consume_val = '0;
        assign txgen_prdata             = '0;
    end
    endgenerate

    wire eye_shim_sel = tl_apb_psel && (tl_apb_paddr[8:5] == 4'b1010);

    wire [SYS_DATA_W-1:0]  eye_shim_prdata;
    wire                    eye_shim_pready;
    wire                    eye_shim_pslverr;

    // Calibrator-facing wires.  Connected through axi_chiplet_controller's
    // new v2 eye-visibility ports (deps/axi-chiplet-controller@ed3bd0f).
    wire [2:0]  eye_swi_lane_sel_w;
    wire [31:0] eye_swi_dwell_us_w;
    wire [31:0] eye_swi_ctrl_w;
    wire [31:0] eye_status_w;
    wire [6:0]  eye_score_idx_w;
    wire [5:0]  eye_score_data_w;
    wire        eye_score_lane_passed_w;
    wire [5:0]  eye_score_best_w;
    wire [2:0]  eye_score_best_slip_w;
    wire [3:0]  eye_score_best_phase_w;
    wire [31:0] eye_force_phase_en_w;
    wire [31:0] eye_force_phase_val_w;
    wire [31:0] eye_force_slip_val_w;
    wire        eye_crc_err_cnt_clr_w;

    // EYE_LAST_LATCHED mirror — sourced from u_chiplet_controller (see below).
    wire [23:0] eye_last_slip_w;
    wire [7:0]  eye_last_lane_fault_w;

    // tidelink-gpio-phy observability bus from the new lane_checker (replaces
    // the legacy 8x crc_err_cnt counters; see
    // deps/tidelink-gpio-phy/docs/TRAINING_MODULE_SPEC.md §6, INTEGRATION_GUIDE
    // §6.2). Each per-lane signal packs 5/2/1 bits/lane × 8 lanes as documented
    // in the submodule's RTL_ARCHITECTURE.md.
    wire [23:0] lane_lock_thresh_w;       // APB regs → checker
    wire        lane_clear_noise_w;       // APB regs → checker (1-cycle pulse)
    wire [7:0]  lane_mismatch_pulse_w;
    wire [15:0] lane_wire_status_w;
    wire [39:0] lane_dist_raw_w;
    wire [39:0] lane_dist_voted_w;
    wire [39:0] lane_dwell_min_dist_w;
    wire [39:0] lane_noise_min_w;
    wire [39:0] lane_noise_max_w;
    wire [39:0] lane_noise_mean_w;
    wire [39:0] lane_noise_current_w;
    wire [7:0]  lane_canary_pass_w;
    wire [7:0]  lane_canary_valid_w;
    // Recovered RX clock surfaced from u_chiplet_controller.link_rx_clk_o
    // (deps/axi-chiplet-controller@3e0e711) for the new gpio_phy_apb_regs
    // slave's link_rx_clk port.
    wire        gpio_phy_link_rx_clk_w;

    // CLK_MHZ = 250 (FPGA app_clk) — same constant as the calibrator's
    // CLK_MHZ default.  Used here only to document the timing assumption
    // shared by the dwell-counter conversion in tidelink_phy_align_calibrator.

`ifndef TIDELINK_PHY_V2
    tidelink_eye_regs #(
        .APB_ADDR_W (APB_ADDR_W),
        .SYS_DATA_W (SYS_DATA_W)
    ) u_eye_regs (
        .hclk                    (hclk),
        .hresetn                 (hresetn),

        .psel                    (eye_shim_sel),
        .penable                 (tl_apb_penable),
        .pwrite                  (tl_apb_pwrite),
        .paddr                   (tl_apb_paddr),
        .pwdata                  (tl_apb_pwdata),
        .prdata                  (eye_shim_prdata),
        .pready                  (eye_shim_pready),
        .pslverr                 (eye_shim_pslverr),

        .swi_eye_lane_sel        (eye_swi_lane_sel_w),
        .swi_eye_dwell_us        (eye_swi_dwell_us_w),
        .swi_eye_ctrl            (eye_swi_ctrl_w),
        .eye_status_i            (eye_status_w),
        .eye_score_idx           (eye_score_idx_w),
        .eye_score_data_i        (eye_score_data_w),
        .eye_score_lane_passed_i (eye_score_lane_passed_w),
        .eye_score_best_i        (eye_score_best_w),
        .eye_score_best_slip_i   (eye_score_best_slip_w),
        .eye_score_best_phase_i  (eye_score_best_phase_w),

        .swi_force_phase_en      (eye_force_phase_en_w),
        .swi_force_phase_val     (eye_force_phase_val_w),
        .swi_force_slip_val      (eye_force_slip_val_w),

        // Legacy CRC counters tied to 0 — eye-toolkit web GUI migrates per
        // deps/tidelink-gpio-phy/docs/INTEGRATION_GUIDE.md §6.2 to consume
        // SWI_LANE_NOISE_VOTED_* from the new tidelink_gpio_phy_apb_regs slave
        // instantiated below (paddr[8:5]==4'b1011, relative offset 0x160).
        .lane_crc_err_cnt_0_i    (8'h0),
        .lane_crc_err_cnt_1_i    (8'h0),
        .lane_crc_err_cnt_2_i    (8'h0),
        .lane_crc_err_cnt_3_i    (8'h0),
        .lane_crc_err_cnt_4_i    (8'h0),
        .lane_crc_err_cnt_5_i    (8'h0),
        .lane_crc_err_cnt_6_i    (8'h0),
        .lane_crc_err_cnt_7_i    (8'h0),
        .lane_crc_err_cnt_clr_o  (eye_crc_err_cnt_clr_w),

        .eye_last_slip_i         (eye_last_slip_w),
        .eye_last_lane_fault_i   (eye_last_lane_fault_w)
    );
`else
    // S3 PHY swap: eye-vis retired (AUDIT #17) — tidelink_eye_regs is absent
    // from the V2 flist. Tie every net the instance drove. Region 10 APB
    // reads return 0 with no wait states; the eye control/force surface is
    // inert. (lane_lock_thresh_w / lane_clear_noise_w are unaffected — they
    // come from the tidelink_gpio_phy_apb_regs slave, which remains.)
    assign eye_shim_prdata        = {SYS_DATA_W{1'b0}};
    assign eye_shim_pready        = 1'b1;
    assign eye_shim_pslverr       = 1'b0;
    assign eye_swi_lane_sel_w     = 3'h0;
    assign eye_swi_dwell_us_w     = 32'h0;
    assign eye_swi_ctrl_w         = 32'h0;
    assign eye_score_idx_w        = 7'h0;
    assign eye_force_phase_en_w   = 32'h0;
    assign eye_force_phase_val_w  = 32'h0;
    assign eye_force_slip_val_w   = 32'h0;
    assign eye_crc_err_cnt_clr_w  = 1'b0;
`endif

    // SWI_FORCE_PHASE_EN/VAL/SLIP_VAL are reserved register slots (proposal
    // §5); the calibrator does not consume them in v2 — kept as drivable
    // RW shadows for SW.  Mark as intentionally unused at this scope.
    // eye_crc_err_cnt_clr_w is still produced by tidelink_eye_regs but the
    // counters it used to clear were removed by the lane-checker rewrite
    // (deps/tidelink-gpio-phy, INTEGRATION_GUIDE §6.2); marked unused at
    // this scope until the eye_regs slot is repurposed or deprecated.
    /* verilator lint_off UNUSED */
    wire _unused_eye_force = |{eye_force_phase_en_w, eye_force_phase_val_w,
                                eye_force_slip_val_w};
    wire _unused_eye_crc_clr = eye_crc_err_cnt_clr_w;
    /* verilator lint_on UNUSED */

    // =========================================================================
    // tidelink-gpio-phy APB slave (Region 11, paddr 0x160-0x17F).
    //
    // Instantiated per deps/tidelink-gpio-phy/docs/TRAINING_MODULE_SPEC.md §6.1
    // and INTEGRATION_GUIDE.md §5/§6.3. Carries the per-lane noise
    // observability + SW-writable lock threshold + wiring/canary status that
    // replace the legacy crc_err_cnt counters now sourced from the new
    // u_chiplet_controller observability bus (see below). Same OR-mux pattern
    // as the dbg_shim and eye_shim blocks above.
    //
    // SPEC DEVIATION: the spec quotes absolute address 0x4403_2120 (§6.1),
    // implying offset 0x120 inside the tidelink APB region. The dbg shim
    // already owns paddr[8:5]==4'b1001 (0x120-0x13F), and eye_regs owns
    // 4'b1010 (0x140-0x15F), so the next free 32-byte aperture is 4'b1011
    // (0x160-0x17F). The internal register map (THRESH at slave-paddr 0x20
    // through CANARY at 0x3C) is preserved by synthesising the slave-facing
    // paddr as {3'b001, tl_apb_paddr[4:0]} so its address decode still
    // matches.
    //
    // CLOCK DOMAIN NOTE: the spec's CDC (apb_clk ↔ link_rx_clk) is satisfied
    // by wiring the slave's link_rx_clk to the controller's new link_rx_clk_o
    // output (added in deps/axi-chiplet-controller@3e0e711). The slave's
    // 2-flop synchronisers now operate across genuine hclk → recovered RX
    // clock boundaries per spec §6.
    //
    // rst_n is driven directly from role_locked per INTEGRATION_GUIDE §5.2
    // ("Connect .rst_n(role_locked) directly — NO inverter"). apb_rst_n is
    // the standard hresetn.
    // =========================================================================
    // Region 11 gpio_phy slave: SoC 0x2160-0x217F (paddr[8:5]==4'b1011) ->
    // slave-internal 0x20-0x3F. The slave also defines SWI_EPOCH_STATUS at
    // slave-paddr 0x40, which does NOT fit the 32-byte 0x1011 window (Region C
    // autoneg owns 0x2180+). In V2 the eye_regs block (Region 10, paddr[8:5]==
    // 4'b1010, SoC 0x2140-0x215F) is ABSENT, so its first word at SoC 0x2140 is
    // free; we route exactly that word to slave-paddr 0x40. SWI_EPOCH_STATUS is
    // therefore readable at SoC 0x4403_2140 in V2 (matches the PHY REGISTER_MAP).
`ifdef TIDELINK_PHY_V2
    wire gpio_phy_epoch_sel = tl_apb_psel && (tl_apb_paddr[8:0] == 9'h140);
    wire gpio_phy_apb_sel   = (tl_apb_psel && (tl_apb_paddr[8:5] == 4'b1011))
                              || gpio_phy_epoch_sel;
`else
    wire gpio_phy_apb_sel = tl_apb_psel && (tl_apb_paddr[8:5] == 4'b1011);
`endif

    wire [SYS_DATA_W-1:0]  gpio_phy_apb_prdata;
    wire                    gpio_phy_apb_pready;
    wire                    gpio_phy_apb_pslverr;

`ifdef TIDELINK_PHY_V2
    // SoC Labs V2 epoch-anchor engagement obs 2026-06-14. Driven by
    // u_chiplet_controller (WlinkGPIOPHY lane-deskew anchor state, in the
    // recovered link_rx_rx_link_clk domain) and consumed by the
    // tidelink_gpio_phy_apb_regs slave below, which 2-flop-syncs into apb_clk
    // and exposes them at SWI_EPOCH_STATUS (paddr 0x40 -> SoC MMIO 0x4403_2140:
    // [0]=epoch_anchored, [6:1]=epoch_span). V1 builds never see these.
    wire                    gpio_phy_epoch_anchored_w;
    wire [5:0]              gpio_phy_epoch_span_w;
`endif

    tidelink_gpio_phy_apb_regs u_gpio_phy_apb_regs (
        // APB clock / reset
        .apb_clk             (hclk),
        .apb_rst_n           (hresetn),

        // APB3 interface — paddr synthesised so the slave's internal
        // localparams (8'h20..8'h3C) line up with the four LSB-bits of
        // tl_apb_paddr inside the 0x160-0x17F aperture.
        .psel                (gpio_phy_apb_sel),
        .penable             (tl_apb_penable),
        .pwrite              (tl_apb_pwrite),
`ifdef TIDELINK_PHY_V2
        // SoC 0x2140 (freed eye word, V2-only) -> slave-paddr 0x40
        // (SWI_EPOCH_STATUS); the Region 11 window 0x2160-0x217F maps as before.
        .paddr               (gpio_phy_epoch_sel ? 8'h40
                                                 : {3'b001, tl_apb_paddr[4:0]}),
`else
        .paddr               ({3'b001, tl_apb_paddr[4:0]}),
`endif
        .pwdata              (tl_apb_pwdata),
        .prdata              (gpio_phy_apb_prdata),
        .pready              (gpio_phy_apb_pready),
        .pslverr             (gpio_phy_apb_pslverr),

        // link_rx_clk domain — recovered RX clock exposed on the controller
        // (deps/axi-chiplet-controller@3e0e711). role_locked is active-high,
        // connected directly to rst_n per INTEGRATION_GUIDE §5.2.
        .link_rx_clk         (gpio_phy_link_rx_clk_w),
        .link_rx_rst_n       (role_locked_o),

        // CDC outputs → u_chiplet_controller (consumed by the new lane_checker
        // through the controller's lane_lock_thresh_i / lane_clear_noise_i
        // ports added in deps/axi-chiplet-controller@68d625d).
        .lock_thresh_o       (lane_lock_thresh_w),
        .noise_mode_o        (/* unused at tidelink_top scope */),
        .clear_noise_pulse_o (lane_clear_noise_w),

        // Per-lane observability inputs — driven by u_chiplet_controller's
        // new lane_*_o outputs (see u_chiplet_controller instantiation below).
        .noise_min_i         (lane_noise_min_w),
        .noise_max_i         (lane_noise_max_w),
        .noise_mean_i        (lane_noise_mean_w),
        .noise_current_i     (lane_noise_current_w),
        .dist_raw_i          (lane_dist_raw_w),
        .dist_voted_i        (lane_dist_voted_w),
        .wire_status_i       (lane_wire_status_w),
        .canary_pass_i       (lane_canary_pass_w),
        .canary_valid_i      (lane_canary_valid_w)
`ifdef TIDELINK_PHY_V2
        // SoC Labs V2 epoch-anchor obs 2026-06-14 — engagement state from the
        // WlinkGPIOPHY lane-deskew engine (via u_chiplet_controller). Read at
        // SWI_EPOCH_STATUS (paddr 0x40 -> SoC MMIO 0x4403_2140).
        ,
        .epoch_anchored_i    (gpio_phy_epoch_anchored_w),
        .epoch_span_i        (gpio_phy_epoch_span_w)
`endif
    );

    // Observability-bus outputs from u_chiplet_controller that the new APB
    // slave does NOT directly consume (mismatch_pulse_o, dwell_min_dist_o).
    // mismatch_pulse_o is consumed by the eye-toolkit GUI via aggregated
    // readback (INTEGRATION_GUIDE §6.2); dwell_min_dist_o feeds the
    // calibrator (internal to the controller). Both are pinned to the
    // observability bus here for downstream consumers / future bind probes
    // and marked intentionally unused at this scope.
    /* verilator lint_off UNUSED */
    wire _unused_lane_obs = |{lane_mismatch_pulse_w, lane_dwell_min_dist_w};
    /* verilator lint_on UNUSED */

    // tl_apb_prdata mux: when a shim is selected, return its rdata;
    // otherwise return u_tidelink's APB rdata (tidelink_internal_prdata).
    // Order: Region 10 (eye) > Region 11 (gpio_phy) > everything else.
    wire [SYS_DATA_W-1:0]  tidelink_internal_prdata;
    wire                    tidelink_internal_pready;
    wire                    tidelink_internal_pslverr;

`ifdef TIDELINK_PHY_V2
    // V2: SoC 0x2140 (gpio_phy_epoch_sel) lives inside the eye_shim_sel address
    // range (0x2140-0x215F), so the gpio_phy slave must win that single word.
    // eye_shim returns 0 in V2 anyway (Region 10 retired), so checking the
    // gpio slave first is safe for every other address too.
    //
    // SoC Labs perlane-wp (2026-06-16): the new sweep-oracle / per-lane word-pin
    // registers also live in the eye_shim address range (SoC 0x2144/0x2148/
    // 0x214C). They are served by the chiplet controller via tidelink_internal_*
    // (ctrl_reg path), so they must fall THROUGH eye_shim — exclude them here,
    // exactly like gpio_phy_epoch_sel excludes 0x2140.
    // EYE-WIDTH OBS DECODE FIX (2026-06-17): slot 4 (SoC 0x2150, paddr[4:0]=5'h10)
    // is the EYE_WIDTH_SEL diagnostic. It is decoded in the chiplet controller's
    // region10_rdata (ctrl_reg_r10 path) and reaches this scope via
    // tidelink_internal_prdata. Like 0x2144/0x2148/0x214C it MUST be excluded
    // from eye_shim_sel_eff so it falls through to tidelink_internal_prdata;
    // otherwise eye_shim (tied to 0 in V2) wins and 0x2150 reads 0x00000000 with
    // NO 0xE7 marker — the silicon symptom. region10_hit in tidelink_apb_regs
    // already routes 0x2150 (paddr[4:2]=3'h4 != 0) to ctrl_reg_r10, so the
    // controller serves {0xE7,...,sync_eye_width_1} once eye_shim is excluded.
    wire perlane_wp_sel = tl_apb_psel
                          && (tl_apb_paddr[8:5] == 4'b1010)
                          && ((tl_apb_paddr[4:0] == 5'h04)    // 0x2144 SYNC_LANE_LIVE
                           || (tl_apb_paddr[4:0] == 5'h08)    // 0x2148 WORD_PIN_PERLANE
                           || (tl_apb_paddr[4:0] == 5'h0C)    // 0x214C WORD_PIN_PERLANE_EN
                           || (tl_apb_paddr[4:0] == 5'h10)    // 0x2150 EYE_WIDTH_SEL (RO)
                           || (tl_apb_paddr[4:0] == 5'h14)    // 0x2154 EYE_LANE_SEL (RW, Task 3)
                           // SoC Labs V2 data-send obs 2026-06-21: 0x2158 is the
                           // A2L_REPLAY_OBS RO word (Region 10 slot 6), served by the
                           // chiplet controller's region10_rdata. Exclude it from
                           // eye_shim so it falls through to tidelink_internal_prdata;
                           // otherwise eye_shim (tied 0 in V2) wins and 0x2158 reads
                           // 0x00000000 with NO 0xA2 marker (same trap as 0x2150).
                           || (tl_apb_paddr[4:0] == 5'h18)    // 0x2158 A2L_REPLAY_OBS (RO)
                           // STICKY-POISON sync_seen obs 2026-06-23: 0x215C is the
                           // SYNC_SEEN_VEC RO word (Region 10 slot 7), served by the
                           // chiplet controller's region10_rdata. Exclude it from
                           // eye_shim so it falls through to tidelink_internal_prdata;
                           // otherwise eye_shim (tied 0 in V2) wins and 0x215C reads
                           // 0x00000000 with NO 0x5F marker (same trap as 0x2150/0x2158).
                           || (tl_apb_paddr[4:0] == 5'h1C));  // 0x215C SYNC_SEEN_VEC (RO)
    wire eye_shim_sel_eff = eye_shim_sel && !perlane_wp_sel;
    assign tl_apb_prdata  = txgen_reg_sel      ? txgen_prdata          :
                            gpio_phy_apb_sel   ? gpio_phy_apb_prdata   :
                            eye_shim_sel_eff   ? eye_shim_prdata       :
                                                 tidelink_internal_prdata;
    assign tl_apb_pready  = txgen_reg_sel      ? 1'b1                  :
                            gpio_phy_apb_sel   ? gpio_phy_apb_pready   :
                            eye_shim_sel_eff   ? eye_shim_pready       :
                                                 tidelink_internal_pready;
    assign tl_apb_pslverr = txgen_reg_sel      ? 1'b0                  :
                            gpio_phy_apb_sel   ? gpio_phy_apb_pslverr  :
                            eye_shim_sel_eff   ? eye_shim_pslverr      :
                                                 tidelink_internal_pslverr;
`else
    assign tl_apb_prdata  = txgen_reg_sel      ? txgen_prdata          :
                            eye_shim_sel       ? eye_shim_prdata       :
                            gpio_phy_apb_sel   ? gpio_phy_apb_prdata   :
                                                 tidelink_internal_prdata;
    assign tl_apb_pready  = txgen_reg_sel      ? 1'b1                  :
                            eye_shim_sel       ? eye_shim_pready       :
                            gpio_phy_apb_sel   ? gpio_phy_apb_pready   :
                                                 tidelink_internal_pready;
    assign tl_apb_pslverr = txgen_reg_sel      ? 1'b0                  :
                            eye_shim_sel       ? eye_shim_pslverr      :
                            gpio_phy_apb_sel   ? gpio_phy_apb_pslverr  :
                                                 tidelink_internal_pslverr;
`endif

    // Route APB responses back to both sources.  GATE the FC response: the FC is
    // told 'ready' only in the cycles it actually owns the bus (fc_cfg_apb_active)
    // -- otherwise it is held off (pready=0) and, per its RX FSM, cleanly stalls
    // with its transaction intact.  prdata is passed through unconditionally: the
    // FC issues writes only (fc_rx_cfg_pwrite=1) and ignores read data.
    assign fc_cfg_apb_prdata  = tl_apb_prdata;
    assign fc_cfg_apb_pready  = fc_cfg_apb_active ? tl_apb_pready  : 1'b0;
    assign fc_cfg_apb_pslverr = fc_cfg_apb_active ? tl_apb_pslverr : 1'b0;

    // External (PS) response.  When the FC owns the bus the PS is stalled
    // (pready=0) -- but the arbiter above guarantees fc_cfg_apb_active=0 whenever
    // an external access is in its ACCESS phase, so the PS is never actually
    // starved here.  ext_timeout force-completes a stuck-slave stall with a bus
    // error so the PS can never hang (the Zynq has no timeout of its own).
    assign tl_regs_prdata  = fc_cfg_apb_active ? '0   : tl_apb_prdata;
    assign tl_regs_pready  = fc_cfg_apb_active ? 1'b0 : (tl_apb_pready  | ext_timeout);
    assign tl_regs_pslverr = fc_cfg_apb_active ? 1'b0 : (tl_apb_pslverr | ext_timeout);

    // =========================================================================
    // Address translation wiring + pipeline register
    // =========================================================================
    wire [SYS_ADDR_W-1:0]  translated_sub_haddr;  // combinational output from translator

    // Pipeline register: breaks the 256:1 segment mux + adder combinational
    // path between the address translator and XHB500. Inserts one wait state
    // per new NONSEQ transfer; SEQ beats pass through without stalling.
    logic [SYS_ADDR_W-1:0] pipe_haddr_r;
    logic              [1:0] pipe_htrans_r;
    logic              [2:0] pipe_hsize_r;
    logic                    pipe_hwrite_r;
    logic              [2:0] pipe_hburst_r;
    logic              [3:0] pipe_hprot_r;
    logic                    pipe_hsel_r;
    logic                    pipe_valid_r;   // latched address phase ready for XHB500

    // Detect new address phase on external port.
    // SoC Labs 2026-07-05 comb-loop fix: do NOT qualify with ahb_sub_hready.
    // The FPGA wrapper loops ahb_sub_hreadyout back into ahb_sub_hready, and
    // ahb_sub_hreadyout (below) depended on ext_is_nonseq -> hreadyout was a
    // combinational function of itself (Vivado: "1 combinational loop (HIGH)").
    // On silicon the bridge / this pipe / XHB500 sampled the ring divergently:
    // window WRITES phantom-completed at the bridge (vanish), HWDATA was
    // captured one cycle late (poison), double-accepts corrupted FC credit
    // (fcsm 4->0 under sustained window traffic). Reproduced deterministically
    // in sim by test_v2_xhb_window_bridge (bridge-accurate BFM). Dropping the
    // hready term is safe for this single-master port: pipe_valid_r blocks
    // re-latch of a held NONSEQ, and the pipe clears exactly at the master's
    // address-phase completion edge (hreadyout==raw whenever pipe_valid_r).
    wire ext_addr_phase = ahb_sub_hsel & ahb_sub_htrans[1];
    // ── XHB500 burst arm is WRITE-unsafe behind this front end (TL-050, 2026-09-23) ──
    // XHB500 takes its multi-beat ("non-singles") arm only when HPROT[3]=1
    // (vendor core_addr.sv:147, singles_burst <= ~hprot[3] || hexcl || INCR).
    // Measured with a protocol-correct AHB master
    // (cocotb/tidelink_top_pair_v2/test_v2_ahb_compliant.py): a cacheable INCR4
    // WRITE on that arm emits one AW but eight W beats and lands beat 0's data at
    // all four addresses; cacheable INCR4 READS on the same arm are correct (and
    // ~3.7x faster than the singles path). Until the write front end handles
    // real bursts, HPROT[3] is cleared toward the bridge for WRITES only, so every
    // write takes the singles path the gate and silicon have always exercised.
    // This is the protection the ethernet chiplet applies at its wrapper
    // ({2'b00, hprot[1:0]} on the peer port) and the compute chiplet applies by
    // rejecting bufferable/burst peer writes; here it holds for every integrator.
    wire [3:0] sub_hprot_eff = ahb_sub_hwrite ? {1'b0, ahb_sub_hprot[2:0]} : ahb_sub_hprot;
    wire ext_is_nonseq  = ext_addr_phase & (ahb_sub_htrans == 2'b10);

    // XHB500 hreadyout / hresp (raw, before pipeline + timeout insertion)
    wire xhb_sub_hreadyout_raw;
    wire xhb_sub_hresp_raw;

    // ── ahb_sub bounded stall backstop (2026-07-06) ───────────────────────────
    // The XHB500 subordinate holds hreadyout low for the whole data phase of a
    // window transfer while it waits on the AXI/link round-trip to the peer. If
    // the link wedges (credit stall, PHY drop), that hreadyout can stay low
    // FOREVER -> ahb_sub_hreadyout (below) stays low -> the Xilinx
    // axi_ahblite_bridge and the Zynq PS interconnect block indefinitely with no
    // PS-side timeout, wedging z2_02 off-net (physical power-cycle to recover;
    // bench-confirmed on the tl-data aperture before its own backstop —
    // tidelink_fc_adapter.sv:247-329, TX_STALL_TIMEOUT). This mirrors that fix
    // for the window path: after SUB_STALL_TIMEOUT hclk cycles of a single
    // transfer held stalled, terminate it with the standard AHB two-cycle ERROR
    // response (cy1: HREADYOUT=0 + HRESP=1; cy2: HREADYOUT=1 + HRESP=1) so the
    // bridge/PS un-block with a recoverable bus error (SIGBUS) instead of hanging.
    //
    // 2^16 hclk (~2.6 ms @ 25 MHz FPGA rig, ~14 ms @ 4.7 MHz) is orders beyond a
    // legitimate slow-but-progressing window round-trip: the counter RESETS every
    // time the front-end stops stalling (i.e. on every completed beat — see
    // sub_ext_stalled), so a long healthy burst never accumulates; ONLY a single beat
    // held stalled continuously past the timeout (a genuine wedge) can trip it.
    //
    // NO COMB LOOP (this is the load-bearing invariant that cb33c9f established):
    // every term below is a register or derives ONLY from ahb_sub_hsel/htrans
    // (ext_is_nonseq), pipe_valid_r (reg) and xhb_sub_hreadyout_raw (XHB500's own
    // output) — NEVER from ahb_sub_hready (the wrapper loopback). ahb_sub_hreadyout
    // gains only the sub_err{1,2}_r register overrides, so it remains free of any
    // combinational dependence on ahb_sub_hready.
`ifdef TIDELINK_SUB_STALL_TIMEOUT_LOG2
    // Sim override (cocotb/tidelink_top_pair_v2/test_v2_xhb_window_stall.py drives
    // it small so the backstop trips in a few hundred cycles instead of ~2^16).
    localparam int SUB_STALL_TIMEOUT_LOG2 = `TIDELINK_SUB_STALL_TIMEOUT_LOG2;
`else
    localparam int SUB_STALL_TIMEOUT_LOG2 = 16;   // ~2^16 hclk; see rationale above
`endif
    // I5 (2026-07-29): a SEPARATE timeout for the outstanding-response backstop
    // (below). Sized independently of the per-beat stall timer so it tracks the
    // whole-transaction round-trip, and so a sim can trip exactly ONE of the two
    // backstops to prove which fired. Same 2^16 default rationale as above.
`ifdef TIDELINK_SUB_OUTSTANDING_TIMEOUT_LOG2
    localparam int SUB_OUTSTANDING_TIMEOUT_LOG2 = `TIDELINK_SUB_OUTSTANDING_TIMEOUT_LOG2;
`else
    localparam int SUB_OUTSTANDING_TIMEOUT_LOG2 = 16;
`endif
    // ── TL-044 (2026-08-24): READ DEAD-GATE CONTAINMENT parameters ───────────
    // See the "XHB500 DEAD-BRIDGE CONTAINMENT" block below the
    // ahb_sub_hreadyout assign for the full rationale. Three named knobs, all
    // overridable from a `+define+` so a sim can reach them and so the
    // thresholds can be retuned when the on-silicon measurement lands:
    //
    //   XHB_DEAD_ARM_LOG2       consecutive hclk of "XHB500 not ready AND zero
    //                           s_axi progress", AFTER a 2-cycle ERROR has
    //                           fired on this port, before the bridge is
    //                           declared DEAD. Default 12 (4096 hclk, ~164 us
    //                           @25 MHz): the SAME threshold the existing
    //                           xhb_stall_stuck_sticky deadlock witness uses
    //                           (:1865, 12'hFFF), so containment engages on the
    //                           same evidence the obs word already calls a
    //                           deadlock — and 16x SHORTER than the 2^16 stall
    //                           timeout, so containment is in place before the
    //                           next transfer would have to pay another full
    //                           stall window.
    //   XHB_DEAD_RECOVER_LOG2   consecutive hclk of xhb_sub_hreadyout_raw HIGH
    //                           required to DEBOUNCE the sticky clear. Default
    //                           12 — deliberately EQUAL to the arm threshold:
    //                           the evidence bar for declaring the bridge alive
    //                           again must be at least as strong as the bar
    //                           used to declare it dead, or a single ready blip
    //                           drops the port straight back onto the unbounded
    //                           fall-through this fix exists to remove. A
    //                           one-cycle (or one-sample) observation of raw
    //                           going high is explicitly NOT sufficient.
    //   XHB_DEAD_RELAPSE_MAX    how many times the sticky may clear and re-arm
    //                           before it latches PERMANENTLY (reset-only).
    //                           Default 2. See the INTERMITTENT branch note.
`ifdef TIDELINK_XHB_DEAD_ARM_LOG2
    localparam int XHB_DEAD_ARM_LOG2     = `TIDELINK_XHB_DEAD_ARM_LOG2;
`else
    localparam int XHB_DEAD_ARM_LOG2     = 12;
`endif
`ifdef TIDELINK_XHB_DEAD_RECOVER_LOG2
    localparam int XHB_DEAD_RECOVER_LOG2 = `TIDELINK_XHB_DEAD_RECOVER_LOG2;
`else
    localparam int XHB_DEAD_RECOVER_LOG2 = 12;
`endif
`ifdef TIDELINK_XHB_DEAD_RELAPSE_MAX
    localparam int XHB_DEAD_RELAPSE_MAX  = `TIDELINK_XHB_DEAD_RELAPSE_MAX;
`else
    localparam int XHB_DEAD_RELAPSE_MAX  = 2;
`endif
    // TL-044 containment state. Declared HERE because `default_nettype none`
    // forbids the forward reference from the address-pipeline always_ff (:1660)
    // that consumes dg_act_abort; DRIVEN in its own always_ff below the
    // ahb_sub_hreadyout assign (it reads sub_mst_dphase_r, which is itself
    // driven there).
    logic                                  xhb_dead_r;        // sticky: bridge declared DEAD
    logic                                  xhb_dead_perm_r;   // anti-oscillation permanent latch
    logic                                  dg_armed_r;        // an ERROR fired and nothing has moved since
    logic [XHB_DEAD_ARM_LOG2:0]            dg_dead_ctr_r;     // raw-low + no-progress age
    logic [XHB_DEAD_RECOVER_LOG2:0]        dg_alive_ctr_r;    // raw-HIGH debounce age
    logic [3:0]                            dg_relapse_ctr_r;  // saturating clear/re-arm count
    logic                                  dg_err1_r, dg_err2_r; // containment 2-cycle AHB ERROR

    logic [SUB_STALL_TIMEOUT_LOG2:0]       sub_stall_ctr_r;
    logic [SUB_OUTSTANDING_TIMEOUT_LOG2:0] sub_osr_ctr_r;
    logic                                  sub_rd_os_r;
    // I5 write-outstanding COUNTER (Fix H, 2026-08-01). The XHB500 AHB->AXI
    // subordinate bridge issues its early-write-response (bufferable, HPROT[2]=1)
    // path up to FOUR writes deep on s_axi (hazard_list.sv HAZARD_LIST_SIZE=4) —
    // it returns HREADYOUT and issues the next AW *before* the prior B returns.
    // A single outstanding BIT is therefore WRONG for writes: when a later write's
    // B returns it clears the bit while an earlier write is STILL outstanding, so
    // sub_axi_outstanding falsely reads idle, the age timer resets, and a
    // genuinely-stuck write (lost/delayed B) is NEVER timed out -> the PS-facing
    // ahb_sub hangs with no backstop (the on-silicon 2026-08-01 hard-wedge, where
    // the errinject resume stream is 32 pipelined bufferable writes). Count them
    // (saturating, width covers the depth-4 list with margin) so sub_axi_outstanding
    // stays asserted until EVERY outstanding write drains. Reads stay single-bit —
    // the bridge is genuinely single-outstanding for reads (ready_for_read gate).
    logic [2:0]                            sub_wr_os_ctr;
    // F-1/F-2 synth-B state (declared early: used by the pipeline-abort gate above
    // the always_ff that assigns them).
    logic [11:0]                           sub_wr_awid_r;
    logic                                  synth_b_pending;
    logic                                  sub_err1_r, sub_err2_r;
    // ── TL-037 (2026-08-14): "a master transfer is in its DATA PHASE" ────────
    // Declared here (used by the backstop always_ff below); DRIVEN after the
    // ahb_sub_hreadyout assign, which is its clear term. Set when the wrapper
    // captures a master address phase (the SAME qualifier the address pipeline
    // and wr_hold_r use), cleared the cycle the master is answered. It is the
    // AHB-legality predicate the F-1 fix actually needed: "is the master
    // waiting?", as opposed to "is a transaction outstanding on s_axi?".
    logic                                  sub_mst_dphase_r;
    // Front-end is holding HREADYOUT low (a transfer is in flight and not
    // progressing): the pipeline-fill stall cycle OR — the case that actually
    // wedges the PS — XHB500 holding its data phase low while it waits on the
    // cross-link b/r response. NOTE the data-phase stall persists AFTER
    // pipe_valid_r clears (XHB500 has already accepted the address and the
    // master has dropped to IDLE), so it is detected by xhb_sub_hreadyout_raw==0
    // directly, NOT via pipe_valid_r. On an idle bus XHB500 drives raw==1
    // (tidelink_top.sv:1181), so idle => not stalled => the counter resets and
    // every completed beat (raw pulses high) re-zeroes it. Frozen during the
    // 2-cycle ERROR response so one wedged transfer is counted exactly once.
    wire sub_stall_fill    = ext_is_nonseq && !pipe_valid_r;
    wire sub_stall_busy    = !xhb_sub_hreadyout_raw;
    // NOTE 2026-07-29: renamed from `ext_stalled` — that name is ALSO declared at
    // module scope for the APB ext-timeout (search "wire ext_stalled" ~line 896).
    // Two same-scope `wire ext_stalled` decls are a redeclaration hazard the
    // language servers flag and VCS resolves ambiguously; the unique name keeps
    // this per-beat backstop cleanly independent of the APB one.
    wire sub_ext_stalled   = (sub_stall_fill || sub_stall_busy)
                             && !sub_err1_r && !sub_err2_r;
    wire sub_stall_expired = sub_stall_ctr_r[SUB_STALL_TIMEOUT_LOG2];

    // ── I5 (2026-07-29): outstanding-response backstop (HREADYOUT-BLIND) ───────
    // The mechanism above only accumulates while xhb_sub_hreadyout_raw is LOW. A
    // peer response that is LOST — the AR/AW was accepted onto the XHB500 s_axi
    // channel and crossed the link, but the returning R(last)/B beat never comes
    // back — can leave ahb_sub_hreadyout HIGH (a posted write, or the bridge
    // parking 'ready' between beats). Then sub_stall_busy reads 0, sub_ext_stalled
    // deasserts, and the per-beat counter keeps RESETTING, so the wedge is never
    // timed out and the PS hangs exactly as in the LOW case this backstop was
    // built for. Track the transaction outstanding on the s_axi handshakes
    // directly and time it out regardless of hreadyout.
    //
    // NO COMB LOOP (same invariant as above): every term derives ONLY from the
    // XHB500 s_axi handshakes (driven by the bridge FSM from xhb_sub_hready, which
    // is pipe_valid_r/ext_is_nonseq/xhb_sub_hreadyout_raw — never ahb_sub_hready)
    // and from registers, and it feeds ONLY the registered sub_err{1,2}_r. So
    // ahb_sub_hreadyout gains no combinational dependence on ahb_sub_hready.
    wire sub_ar_accept       = s_axi_arvalid & s_axi_arready;
    wire sub_aw_accept       = s_axi_awvalid & s_axi_awready;
    wire sub_r_done          = s_axi_rvalid  & s_axi_rready & s_axi_rlast;
    wire sub_b_done          = s_axi_bvalid  & s_axi_bready;
    wire sub_axi_outstanding = sub_rd_os_r | (sub_wr_os_ctr != 3'd0);
    wire sub_axi_progress    = sub_r_done | sub_b_done;
    wire sub_osr_expired     = sub_osr_ctr_r[SUB_OUTSTANDING_TIMEOUT_LOG2];

    // ── TL-044 ACTION taps (2026-08-24) ──────────────────────────────────────
    // The containment's DETECTION (xhb_dead_r and its counters, driven below)
    // is kept strictly separate from its ACTION (these four taps). The
    // TIDELINK_XHB_DEAD_NO_ACTION mutant build zeroes ONLY the taps, so
    // detection still latches and still reports through the obs word while the
    // port behaves exactly as pristine RTL — which is what makes the
    // detection/action split a testable property rather than a claim
    // (cocotb/tidelink_axi_datanode_recovery/test_tl044_read_deadgate.py
    //  ::test_tl044_mutant_detection_without_action_still_hangs).
    //
    // dg_act_ready is qualified `& ~sub_mst_dphase_r` — "only when the master
    // has already been answered". That is the invariant that makes this
    // containment safe: it can free an IDLE bus, but it can NEVER complete a
    // master's transfer with HREADYOUT=1/HRESP=OKAY, because whenever a master
    // is waiting the tap is 0 and the bounded ERROR (dg_err1_r/dg_err2_r) is
    // what retires it. Erroring is legal; inventing read data is not.
`ifdef TIDELINK_XHB_DEAD_NO_ACTION
    wire dg_act_err1  = 1'b0;
    wire dg_act_err2  = 1'b0;
    wire dg_act_ready = 1'b0;
    wire dg_act_abort = 1'b0;
`else
    wire dg_act_err1  = dg_err1_r;
    wire dg_act_err2  = dg_err2_r;
    wire dg_act_ready = xhb_dead_r & ~sub_mst_dphase_r;
    wire dg_act_abort = dg_err1_r | (xhb_dead_r & ~sub_mst_dphase_r);
`endif

    always_ff @(posedge hclk or negedge hresetn) begin
        if (!hresetn) begin
            pipe_haddr_r   <= '0;
            pipe_htrans_r  <= 2'b00;
            pipe_hsize_r   <= 3'b0;
            pipe_hwrite_r  <= 1'b0;
            pipe_hburst_r  <= 3'b0;
            pipe_hprot_r   <= 4'b0;
            pipe_hsel_r    <= 1'b0;
            pipe_valid_r   <= 1'b0;
        end else begin
            if (ext_is_nonseq && !pipe_valid_r) begin
                // Latch address-phase signals + translated address
                pipe_haddr_r   <= translated_sub_haddr;
                pipe_htrans_r  <= ahb_sub_htrans;
                pipe_hsize_r   <= ahb_sub_hsize;
                pipe_hwrite_r  <= ahb_sub_hwrite;
                pipe_hburst_r  <= ahb_sub_hburst;
                pipe_hprot_r   <= sub_hprot_eff;
                pipe_hsel_r    <= 1'b1;
                pipe_valid_r   <= 1'b1;
            end else if (pipe_valid_r && xhb_sub_hreadyout_raw) begin
                // XHB500 accepted the address phase, clear pipeline
                pipe_valid_r   <= 1'b0;
                pipe_hsel_r    <= 1'b0;
                pipe_htrans_r  <= 2'b00;
            end else if (sub_err1_r & ~synth_b_pending) begin
                // Stall-timeout abort: abandon the in-flight (wedged) transfer so
                // it cannot re-trigger the backstop or hold hsel into XHB500.
                // (Skipped while synth_b_pending: XHB500 is completing the write.)
                pipe_valid_r   <= 1'b0;
                pipe_hsel_r    <= 1'b0;
                pipe_htrans_r  <= 2'b00;
            end else if (dg_act_abort) begin
                // ── TL-044 (2026-08-24): DEAD-BRIDGE pipeline abort ───────────
                // Same abandon as the stall-timeout arm above, for the two
                // containment cases. It is REQUIRED for correctness, not a
                // tidy-up:
                //   dg_err1_r  — retire the transfer the containment ERROR is
                //                terminating, so it cannot hold pipe_hsel_r
                //                into a bridge that will never accept it.
                //   xhb_dead_r & ~sub_mst_dphase_r — a transfer whose master
                //                has ALREADY been answered but whose pipe entry
                //                is stranded (raw never rose, so the
                //                `pipe_valid_r && xhb_sub_hreadyout_raw` clear
                //                at :1672 can never fire). Leaving it set is a
                //                SECOND dead gate: the next NONSEQ would not
                //                satisfy `ext_is_nonseq && !pipe_valid_r`, so
                //                sub_mst_dphase_r would never re-arm, the
                //                containment ERROR would never fire for it, and
                //                the fill/rd_pipe/wr_hold terms would all be 0 —
                //                the transfer would fall straight through to
                //                dg_act_ready and complete with OKAY and stale
                //                HRDATA. That is inventing read data, which this
                //                design must never do. Clearing the stranded
                //                entry is what keeps the ERROR path reachable
                //                for every subsequent transfer.
                // GATED ENTIRELY on xhb_dead_r (via dg_act_abort): when the
                // containment is not engaged this arm is dead code and the
                // pipeline is bit-identical to pristine.
                pipe_valid_r   <= 1'b0;
                pipe_hsel_r    <= 1'b0;
                pipe_htrans_r  <= 2'b00;
            end
        end
    end

    // Stall-timeout counters + 2-cycle AHB ERROR sequencer (registered; driven
    // off hclk; never combinationally dependent on ahb_sub_hready — see above).
    // TWO independent backstops feed the SAME 2-cycle ERROR sequencer:
    //   (1) per-beat HREADYOUT-low stall  (sub_stall_ctr_r / sub_stall_expired)
    //   (2) I5 outstanding-response wedge (sub_osr_ctr_r  / sub_osr_expired)
    // Either expiry drives sub_err1_r; sub_err1_r is a register with a single
    // always_ff driver, so multiple `<= 1'b1` assignments below simply OR.
    always_ff @(posedge hclk or negedge hresetn) begin
        if (!hresetn) begin
            sub_stall_ctr_r <= '0;
            sub_osr_ctr_r   <= '0;
            sub_rd_os_r     <= 1'b0;
            sub_wr_os_ctr   <= 3'd0;
            sub_err1_r      <= 1'b0;
            sub_err2_r      <= 1'b0;
        end else begin
            sub_err2_r <= sub_err1_r;   // ERROR cycle 2 follows cycle 1
            sub_err1_r <= 1'b0;         // default: one-shot

            // (1) per-beat HREADYOUT-low stall
            if (!sub_ext_stalled) begin
                sub_stall_ctr_r <= '0;                 // resets every completed beat
            end else if (sub_stall_expired) begin
                sub_stall_ctr_r <= '0;
                // ── F-1 FIX (2026-08-02): ERROR backstop is READ-ONLY ─────────
                // A stuck WRITE is retired by synth-B (sub_wr_stuck_fire), which
                // completes it through XHB500's own response path. Emitting an
                // AHB ERROR for the same write too lands a HRESP=1 pulse on an
                // idle/posted-write bus with no transfer in its data phase =
                // AHB-illegal (F-1). Reads have NO synthetic response, so a stuck
                // read still legitimately drives HRESP=ERROR here.
                if (sub_rd_os_r) sub_err1_r <= 1'b1;  // fire ERROR (read only)
                // ── TL-037 FIX (2026-08-14, sim-reproduced) ──────────────────
                // TERMINAL TIMEOUT for a transfer stalled BEFORE it ever
                // reaches s_axi. Every existing backstop on this port is
                // conditioned on a transaction ALREADY being outstanding:
                // the two ERROR fire sites on sub_rd_os_r, and the synth-B
                // drain on sub_wr_os_ctr. But XHB500 holds hreadyout LOW in
                // RESP_FSM_SEQ_NSEQ whenever it cannot SUBMIT the address
                // (core_resp.sv:181-183 `if (~address_readyout)`), and
                // pause_addr_submit (core_addr.sv:151-154) blocks a read on
                // `~ready_for_read`, whose read_counter is decremented ONLY by
                // r_done (core_resp.sv:115-123). So after ANY read whose R is
                // permanently lost -- including one the read backstop above has
                // just legitimately retired -- read_counter is parked non-zero,
                // every later peer access is paused with sub_rd_os_r == 0 AND
                // sub_wr_os_ctr == 0, and this timer expires into a DEAD GATE:
                // it resets itself and fires nothing, forever. ahb_sub_hreadyout
                // stays low, the PS store/load never returns, and the only
                // recovery is a power-on reset (TL-037; sim-reproduced
                // 2026-08-14, cocotb test_tl037_ahb_sub_terminal_timeout.py --
                // the stall timer expired 6x in that state with zero HRESP).
                // Fire the SAME 2-cycle ERROR sequencer, under the three
                // conditions that keep every earlier fix intact:
                //   sub_mst_dphase_r   the master really is waiting on a
                //                      transfer, so the ERROR lands in a data
                //                      phase and is AHB-LEGAL. This is F-1's
                //                      requirement stated correctly: F-1 barred
                //                      an ERROR on an IDLE bus, and gated on
                //                      sub_rd_os_r to do it -- which also
                //                      disabled the one case the per-beat stall
                //                      backstop was BUILT for. On an idle bus
                //                      sub_mst_dphase_r is 0, so nothing fires.
                //   sub_wr_os_ctr==0   a stuck WRITE is owned by synth-B
                //                      (sub_wr_stuck_fire keys on this SAME
                //                      expiry); never double-drive it (F-1).
                //   !synth_b_pending   the master-facing ERROR is masked by
                //                      `& ~synth_b_pending` at the two assigns
                //                      below, so firing into a drain would be
                //                      the N1 defect (an ERROR that is fired,
                //                      masked, and never re-fired).
                // NOTE this ASSERTS NOTHING and CLEARS NOTHING but its own
                // one-shot: it does not touch synth_b_pending (a LEVEL that is
                // a term of wr_hold_clr -- asserting it disables the TL-002
                // peer-write hold, which is why the TL-042 candidate was
                // rejected on hardware), sub_rd_os_r, sub_wr_os_ctr or
                // wr_hold_r. It only fires an ERROR into a stall that today
                // ends in silence. The `else` keeps the pre-existing
                // sub_rd_os_r path bit-identical, so the ONLY behaviour change
                // is in a case that previously did nothing at all.
                else if (sub_mst_dphase_r && (sub_wr_os_ctr == 3'd0)
                                          && !synth_b_pending)
                    sub_err1_r <= 1'b1;  // 2-cycle ERROR: terminal timeout
            end else begin
                // Sized increment (was `+ 1'b1`): identical value, equal-width
                // operands. TL-009 mitigation code -- deliberately a no-op.
                sub_stall_ctr_r <= sub_stall_ctr_r + (SUB_STALL_TIMEOUT_LOG2+1)'(1'b1);
            end

            // (2) I5 outstanding-response backstop. Track sub reads/writes in
            // flight on the XHB500 s_axi channel: reads SET on an accepted AR,
            // CLEAR on R(last) (single-outstanding); writes COUNT accepted AWs and
            // decrement on each returning B (up to 4 outstanding, EWR path — see
            // sub_wr_os_ctr decl). Oblivious to ahb_sub_hreadyout, so it catches
            // the lost-response wedge the per-beat timer is blind to.
            if (sub_ar_accept)   sub_rd_os_r <= 1'b1;
            else if (sub_r_done) sub_rd_os_r <= 1'b0;
            // saturating inc/dec; simultaneous AW+B is a net no-change.
            case ({sub_aw_accept, sub_b_done})
                2'b10: if (sub_wr_os_ctr != 3'd7) sub_wr_os_ctr <= sub_wr_os_ctr + 3'd1;
                2'b01: if (sub_wr_os_ctr != 3'd0) sub_wr_os_ctr <= sub_wr_os_ctr - 3'd1;
                default: /* 2'b00 idle, 2'b11 net-zero */ ;
            endcase

            if (!sub_axi_outstanding || sub_axi_progress) begin
                sub_osr_ctr_r <= '0;                   // idle, or a beat retired
            end else if (sub_osr_expired) begin
                sub_osr_ctr_r <= '0;
                // F-1 FIX: READ-ONLY ERROR (see per-beat path above). A stuck
                // WRITE is owned by synth-B (sub_wr_stuck_fire keys on the SAME
                // expiry via sub_wr_os_ctr), so it must NOT also pulse HRESP.
                // ── N1 FIX (2026-08-14, sim-reproduced) ──────────────────────
                // The master-facing ERROR is gated `& ~synth_b_pending` at :1898
                // /:1906. A COINCIDENT stuck read + stuck write expires this ONE
                // shared timer together, so the write path sets synth_b_pending on
                // the SAME cycle and MASKS the read's whole 2-cycle ERROR - while
                // the old unconditional `sub_rd_os_r <= 1'b0` below abandoned the
                // read anyway. Both ERROR fire sites (:1645 and here) are gated on
                // sub_rd_os_r, so once it is cleared NEITHER backstop can ever fire
                // for that read again: no ERROR, no retry, unrecoverable PS hang
                // (sim-reproduced 2026-08-14, cocotb
                // test_n1_read_backstop_defeat.py).
                // Abandon the read ONLY when its ERROR will actually be VISIBLE:
                // no synth-B drain in flight, and none about to arm on this same
                // expiry (inside this branch sub_osr_expired==1, so
                // sub_wr_stuck_fire reduces to sub_wr_os_ctr != 0). Otherwise keep
                // sub_rd_os_r SET - the timer restarts, the synth-B drain retires
                // the stuck writes, and the NEXT window delivers a legal, visible
                // 2-cycle ERROR. Recovery is deferred by one timeout window
                // instead of being lost forever.
                if (sub_rd_os_r && (sub_wr_os_ctr == 3'd0) && !synth_b_pending) begin
                    sub_err1_r  <= 1'b1;  // 2-cycle ERROR (read only)
                    sub_rd_os_r <= 1'b0;  // abandon the timed-out READ txn
                end
                // SOAK-DRAIN FIX (2026-08-05): do NOT zero sub_wr_os_ctr here. The
                // old zeroing abandoned all-but-one outstanding WRITE — synth-B
                // fired ONCE — so a soak with N>=2 EWR (bufferable) writes stuck left
                // N-1 un-completed -> XHB500 hazard list stays full -> die_a PS
                // SmartConnect saturates (the soak wedge, sim-reproduced). Instead the
                // synth-B drain below retires each stuck write one at a time: every
                // sub_b_done (incl. each synthetic B beat) decrements sub_wr_os_ctr via
                // the case above, and synth_b_pending stays asserted until it hits 0.
            end else begin
                // Sized increment (was `+ 1'b1`): identical value, equal-width
                // operands. TL-009 mitigation code -- deliberately a no-op.
                sub_osr_ctr_r <= sub_osr_ctr_r + (SUB_OUTSTANDING_TIMEOUT_LOG2+1)'(1'b1);
            end
        end
    end

    // ── TL-042 instance 1 FIX (2026-08-23): HEAD-OF-LINE WRITE-AGE WATCHDOG ──
    //
    // THE DEFECT (measured on silicon; obs word 0x8403_21F8 below, during a D2D
    // peer-write wedge: healthy 0xB5000001 -> wedged 0xB5000498).
    //     bit[3:1] sub_wr_os_ctr          = 4   four writes outstanding
    //     bit[4]   pipe_hprot_r[2]        = 1   bufferable / early-write-response
    //     bit[8]   sub_wr_stuck_sticky    = 0   <<< the backstop NEVER FIRED
    //     bit[10]  xhb_stall_stuck_sticky = 1   hreadyout_raw low >= 2^12 hclk
    // sub_wr_stuck_sticky is SET-ONLY (its only two assignments are `<= 1'b0`
    // under reset and `<= 1'b1` on the fire condition), so bit[8]==0 proves the
    // EXPIRY ITSELF never happened. The synth-B backstop is not masked and not
    // mis-gated: it is STARVED.
    //
    // WHY. Both existing timers are AGGREGATE-PROGRESS timers with no
    // transaction identity, so ANY unrelated completion re-arms a transaction
    // that is going nowhere:
    //     sub_axi_progress = sub_r_done | sub_b_done;      // any channel, any txn
    //     if (!sub_axi_outstanding || sub_axi_progress) sub_osr_ctr_r  <= '0;
    //     if (!sub_ext_stalled)                         sub_stall_ctr_r <= '0;
    // A cross-page READ is NOT hazarded behind a posted write (hazard_list.sv
    // match_addr_i compares chk_addr[31:12], a 4KB page), and pause_addr_submit's
    // write arm keys on hazard_full only -- so on a port carrying ordinary mixed
    // traffic every read completion re-zeroes the stuck WRITE's age, and every
    // raw-hreadyout blip re-zeroes the per-beat timer. Post-onset ILA: 2035 low
    // / 2 high in 2036 samples -- one 2-cycle pulse is enough to re-zero a
    // counter that needs 65536 CONTINUOUS cycles.
    // RAISING SUB_*_TIMEOUT_LOG2 PROVABLY CANNOT HELP: the counters never reach
    // ANY threshold. Sim-reproduced 2026-08-23,
    // cocotb/tidelink_axi_datanode_recovery/test_tl044_hol_write_age.py.
    //
    // THE FIX: give the OLDEST OUTSTANDING WRITE an IDENTITY and age THAT.
    // Two wrapping sequence numbers -- issue (incremented by an accepted AW) and
    // retire (incremented by a returning B) -- name the head-of-line write. The
    // age counter is re-zeroed ONLY when the head-of-line write itself retires
    // (sub_b_done advances the retire pointer, i.e. a NEW write becomes oldest)
    // or when nothing is outstanding. sub_r_done, an hreadyout blip, and every
    // other unrelated event CANNOT touch it. AXI requires same-ID write
    // responses to return in order and this bridge ties AWID = hmaster = 12'd0
    // (core_addr.sv:250 + .hmaster(12'd0) on u_xhb_sub), so "a B returned" IS
    // "the head-of-line write retired": the retire pointer is exactly the
    // head-of-line identity, with no per-entry timestamp array needed.
    //
    // WHAT IT DRIVES -- A DEDICATED PATH, DELIBERATELY NOT synth_b_pending.
    // The 2026-08-13 TL-042 candidate asserted synth_b_pending as its escape.
    // synth_b_pending was a LEVEL term of wr_hold_clr, so asserting it disabled
    // the TL-002 peer-write data-phase hold, and that build was REJECTED on
    // hardware (16/16 byte-exact -> 0/16). Nothing below is a term of
    // wr_hold_set / wr_hold_clr / wr_hold_r, sub_err{1,2}_r, sub_rd_os_r,
    // sub_wr_os_ctr, sub_stall_ctr_r, sub_osr_ctr_r, sub_mst_dphase_r,
    // synth_b_pending or pipe_valid_r, and it reads none of them. The only
    // pre-existing state it READS is sub_wr_awid_r (the captured, constant AWID)
    // for the Fix-K bid mux; the only nets it JOINS are s_axi_bvalid/bresp/bid,
    // as one additional OR term beside the existing synth-B.
    //
    // BOUNDED DRAIN. On expiry the ISSUE pointer is snapshot into
    // sub_wr_hol_drain_tgt_r and the drain injects exactly one OKAY B per write
    // that was outstanding AT THAT MOMENT -- never for a write accepted later,
    // and never one beat too many (the B is driven off sub_wr_hol_b_drive, which
    // deasserts on the beat that reaches the target). A real B arriving mid-drain
    // simply advances the same retire pointer, so it shortens the drain rather
    // than colliding with it. OKAY, not SLVERR, for the same reason the existing
    // synth-B uses OKAY: SLVERR triggered a PS write-retry LOOP on silicon
    // (ILA-proven) and turned a lost response into a total wedge.
    //
    // TIMEOUT 2^17 -- ONE BINADE ABOVE the two 2^16 aggregate timers, so this
    // watchdog is always LAST to fire and can never pre-empt a backstop that
    // would have fired on its own. It is an AGE, not a no-progress timer, but
    // because B is in-order any retirement re-zeroes it, so a legitimately busy
    // port never accumulates: reaching 2^17 means NO write retired for ~5.2 ms
    // at 25 MHz with writes outstanding, which is unambiguously a wedge.
    //
    // NOT COVERED (disclosed): (a) a stuck write that is never ACCEPTED onto
    // s_axi at all (sub_aw_accept never pulses) is invisible to this watchdog by
    // construction -- that is TL-037's terminal-timeout path, not this one;
    // (b) the symmetric READ-side starvation (a stuck read whose age timer is
    // re-zeroed by write completions) is NOT fixed here: its only escape is the
    // sub_err1_r ERROR path, and re-gating that would modify an existing
    // protection, which this change deliberately does not do.
    //
    // NO COMB LOOP (the load-bearing wrapper invariant, cb33c9f): every term
    // below is a register or derives ONLY from the XHB500 s_axi_* handshakes
    // (driven by the bridge FSM off xhb_sub_hready) -- never from
    // ahb_sub_hready, and never from ahb_sub_hreadyout. It feeds only
    // s_axi_bvalid/bresp/bid, exactly as synth_b_pending already does, so
    // ahb_sub_hreadyout gains no new combinational dependence.
`ifdef TIDELINK_SUB_WR_HOL_TIMEOUT_LOG2
    // Sim override (cocotb/tidelink_axi_datanode_recovery/test_tl044_hol_write_age.py
    // drives it to 2^14, one binade above the 2^13 aggregate timers that test
    // uses, preserving the shipping ordering in a sim-length window).
    localparam int SUB_WR_HOL_TIMEOUT_LOG2 = `TIDELINK_SUB_WR_HOL_TIMEOUT_LOG2;
`else
    localparam int SUB_WR_HOL_TIMEOUT_LOG2 = 17;
`endif
    // 4-bit sequence numbers: the XHB500 hazard list is 4 deep
    // (HAZARD_LIST_SIZE=4) so at most 4 writes are ever outstanding on s_axi;
    // mod-16 pointers carry 4x margin and, unlike the saturating sub_wr_os_ctr,
    // cannot desync by clipping.
    logic [3:0]                        sub_wr_hol_seq_issue_r;
    logic [3:0]                        sub_wr_hol_seq_retire_r;
    logic [3:0]                        sub_wr_hol_drain_tgt_r;
    logic [SUB_WR_HOL_TIMEOUT_LOG2:0]  sub_wr_hol_age_r;
    logic                              sub_wr_hol_b_pending;
    logic                              sub_wr_hol_stuck_sticky;  // obs 0x21F8 bit[12]
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
