SoC-Labs/TideLink-Chiplet-Interconnect-AHB/src/rtl/local_overrides/axi_chiplet_controller.sv

// -----------------------------------------------------------------------------
// Generic Chiplet Controller with Runtime Master/Slave Role Selection
//
// Wraps the Chisel-generated Wlink core with:
//   - Both I2C master and I2C slave cores
//   - A role register block (master/slave selection before link-up)
//   - APB mux for Wlink register access (master vs slave mode)
//   - Wlink POR gating until role is locked
//
// The role is determined by a strap pin default, optionally overridden by
// a CPU register write, and locked before the Wlink link trains. Once locked,
// only a full power-on reset (poresetn) can change the role.
//
// A joint work commissioned on behalf of SoC Labs, under Arm Academic Access license.
//
// Contributors
//   David Mapstone (d.a.mapstone@soton.ac.uk)
//
// Copyright 2026, SoC Labs (www.soclabs.org)
// -----------------------------------------------------------------------------

module axi_chiplet_controller #(
    // SoC Labs §9 auto-cal enable. When 0 (default), the calibrator FSM is
    // held inert (role_locked tied to 0 from the calibrator's perspective)
    // so its outputs stay at 0 and the SW-override OR-mux is bit-exact
    // unchanged from the pre-autocal behaviour — required to keep the
    // cocotb hierarchical-force sweep tests passing. FPGA / ASIC builds
    // override this to 1 from tidelink_top.sv.
    parameter AUTOCAL_ENABLE = 1'b0,
    // SoC Labs §9 structural fix (2026-05-18): per-lane IDELAYE2 RX delay
    // element driven by the calibrator's existing per-lane phase value.
    // 0 (default) = bit-exact passthrough, NO Xilinx primitive — keeps the
    // cocotb wlink_pair / phy_align sweep TBs and the ASIC flist
    // (tidelink_top_full_asic.flist) elaborating identically. The FPGA
    // build (tidelink_top.sv → fpga build) overrides this to 1 and also
    // defines TIDELINK_USE_IDELAY. See tidelink_idelay_rx.sv.
    parameter USE_IDELAY     = 1'b0,
    // §9 clock fix: recovered-RX-clock global BUFG (FPGA only). Default 0 =
    // bit-exact passthrough (sim/ASIC/UVM); FPGA wrapper sets 1. Same
    // component.xml mechanism as USE_IDELAY. See tidelink_rxclk_buf.sv.
    parameter USE_CLKBUF     = 1'b0,
    // §9 T3a (2026-05-19): per-lane self-aligning RX. Each WavD2DGpioRx hunts
    // for its peer's training byte in the io_pad stream and slips `count` to
    // align to the byte boundary, killing the per-deploy 16-cycle count-phase
    // lottery that left master/slave anti-correlated. Default 0 = bit-exact
    // passthrough (sim/ASIC/UVM); FPGA wrapper sets 1 via component.xml.
    parameter USE_T3A        = 1'b0,
    // Z2 no-data-delivery fix (2026-07-30, docs/HANDOVER_Z2_PICKUP_2026_07_30.md
    // §5): pass-through to Wlink.EPOCH_ANCHOR_EN. Default 0 = bit-exact
    // passthrough everywhere; a board-level integration overrides to 1 to swap
    // in the training-EXIT anchored deskew corrector (V2 only; inert under V1).
    parameter EPOCH_ANCHOR_EN = 1'b0,

    // Phase 2 autonomy — POR-default value for NEGO_TRAIN_CFG (Region 8 slot
    // 3'h3, MMIO 0x4403_210C). Bit[0]=train_auto_en, bit[1]=train_sw_step,
    // bits[7:4]=poll_timeout (FSM uses T_POLL_TIMEOUT_DEFAULT when 0),
    // bits[15:8]=fsm_wait_hi (FSM uses T_TRAIN_FSM_DEFAULT when 0).
    //
    // Default 16'h0001 → train_auto_en=1 at POR, all timers fall back to
    // FSM-baked defaults. This makes the ASIC + FPGA + sim all enter the
    // autonomous training arm out of reset without any SW config write,
    // matching the v1 autonomy contract. Cocotb tests that need the legacy
    // train_auto_en=0 path (where the FSM legacy-bypasses to ST_NEGO_DONE
    // directly) override this parameter via the testbench wrapper.
    parameter [15:0] NEGO_TRAIN_CFG_RESET = 16'h0001,
    // NEGO_CFG POR value.
    // 7'h61 = nego_en[0]=1 + nego_force_lock[5]=1 + mask_hs_auto_en[6]=1
    //   → autoneg FSM engages out of POR, latches role_lock on completion,
    //     and runs the mask-handshake states (gates ST_NEGO_DONE_PRE).
    // Companion to NEGO_TRAIN_CFG_RESET — the two together make the chiplet
    // POR-boot directly into autonomous bring-up without any SW write.
    // Cocotb tests that need the legacy SW-driven path override to 7'h00.
    //
    // SoC Labs 2026-06-18 — REDUCED-LANE BRING-UP: default to 7'h00 (autoneg
    // OFF, SW-driven path). With autoneg ON the SLAVE die's Wlink config block
    // (incl. the lane mask) is owned by the autoneg I2C path and ignores SW
    // GP0 writes, and the mask handshake is bypassed — so the slave is stuck
    // at the default 8-lane mask 0xff while the master masks to a reduced lane
    // set, mis-framing master->slave CR. Disabling autoneg lets SW set ROLE_CFG
    // + the lane mask on BOTH dies (the master path is already SW-writable),
    // exactly like the pair_v2 sim recipe. REVISIT for production: re-enable
    // autoneg (7'h61) once the mask handshake propagates the reduced mask to
    // the slave (wire peer_rx_lane_mask_i / un-bypass mask_hs).
    parameter [6:0]  NEGO_CFG_RESET       = 7'h00,
    // Terminal role from strap, not the I2C-NACK constant. Forwarded to
    // tidelink_autoneg.ROLE_FROM_STRAP. DECISION (David, 2026-07-19): default
    // is now 1'b1 (strap honoured) so a dead I2C no longer forces both dies
    // slave. 1'b0 = legacy trap (NACK => slave, timeout => nego_fallback).
    parameter bit    ROLE_FROM_STRAP      = 1'b1,
    // Forwards to tidelink_autoneg.TRAIN_ENTRY_FALLBACK. DEFAULT OFF (shipping
    // behaviour unchanged). 1 = on a dead I2C bus, the training transaction
    // enters training from strap instead of hanging/erroring with the SYNC
    // beacon dark. The symmetric completion of DECISION #3 for training entry.
    parameter bit    TRAIN_ENTRY_FALLBACK = 1'b0,
    // I1 eth-chiplet bring-up fix (2026-07-30, docs/I1_SELFARM_FIX.md).
    // SELF-ARM ROLE-LOCK ON EXPLICIT SW INTENT. DEFAULT OFF — every existing
    // deps/Z2/onchip build is byte-behaviour-identical (constant-folds away).
    // When 1, a SW W1S of ROLE_CFG[1] latches role_lock_reg IMMEDIATELY, without
    // waiting for the peer mask-handshake gate (mask_hs_gate_open) or the
    // nego_lost_w fallback — both stay 0 on a die whose peer-I2C control plane
    // never completes (the eth-chiplet). role_locked is a MUTUAL CLOCK ENABLE
    // (wlink_por_reset = ~role_locked, below), so with it stuck 0 the forwarded
    // pad_clk_tx / calibrator are held in reset and cal_done can never assert.
    // Self-latching on the SW intent honours the design principle "role-lock must
    // NEVER wait on a protocol event" (project_role_lock_is_a_mutual_clock_enable).
    // The genuine-integrity witness mask_hs_verified_reg (the mask_hs_match-ALONE
    // latch above) is LEFT UNTOUCHED, so RETIRED-autonomy entry still fails closed
    // — a self-armed role_lock does NOT forge it. When set, this ALSO makes SW own
    // swi_training_mode_r: the autoneg's ST_TRAIN_EXIT clear is gated off (below)
    // so it cannot wipe an SW-held training out from under the cal_done poll.
    // Set 1'b1 ONLY on the eth-chiplet tidelink_top instantiation; every other
    // integration keeps the 1'b0 default.
    parameter bit    SELF_ARM_TRAIN_EN    = 1'b0,
    // AUTO_ANCHOR_EN (2026-08-04): on link-up, pulse the SYNC beacon once (gated
    // on TX-idle so it can never delete a live D2D word) to latch the deskew
    // re-anchor on the nego_en=0 / SELF_ARM eth-chiplet path — the shipping
    // SYNC-reanchor corrector otherwise never sees a beacon (reanchored=0 ->
    // data mis-frames = the R1/deskew wedge). Default-OFF constant-folds the FSM
    // + the SYNC-port ORs (bit-identical). Set 1'b1 ONLY on the eth-chiplet.
    parameter bit    AUTO_ANCHOR_EN       = 1'b0,
    // Consolidation 2026-07-15: winscan converge-lock knob, retained ONLY for
    // tidelink_top elaboration parity (tidelink_top threads it to this ACC).
    // INERT on this line: we chose phase2's asymmetric peer-serve finalize FSM,
    // not tapeout's dormant + converge-lock strategy, so the lock mechanism is
    // absent here and the param defaults OFF. The bring-up lottery is addressed
    // physically (P-B capture-clock hoist), not by this lock.
    parameter bit    WINSCAN_CONVERGE_LOCK_EN = 1'b0,
    // SoC Labs 2026-06-29 — AUTONOMOUS ON-CHIP IDELAY WINSCAN FSM enable.
    // 1 (default) = the on-chip cross-lane deskew winscan FSM is BUILT and may
    // run, but ONLY when armed via the autonomous nego path (nego_en &
    // role_locked); when nego_en=0 (the proven SW-role_lock / host-winscan
    // path) the FSM is permanently dormant and the per-lane IDELAY tap regs
    // (swi_phase_offset_r / swi_phase_lsb_r) keep their APB-written values
    // bit-identically — the host winscan() and the SW data regression are
    // UNAFFECTED. 0 = the FSM is removed entirely (the autonomous deskew layer
    // reverts to the pre-winscan behaviour, i.e. relies on the host loop only).
    // The FSM body is additionally `ifdef TIDELINK_PHY_V2 (it consumes V2-only
    // obs_sync_dist_vec / swi_phase_lsb), so in V1 it is absent regardless.
    parameter bit    WINSCAN_FSM_EN       = 1'b1,
    // EVENT-GATED AUTONOMY RETIRE enable (2026-07-15, F4 tapeout knob). 1 =
    // once the link is provably up (reanchored & bilateral FC), the die
    // autonomously retires the winscan/force-SYNC autonomy (replicating the
    // 0x210C=0 escape hatch) — THE B->A channel fix on the FPGA autonomy path.
    // Default 1 = enabled for FPGA autonomy. The ASIC integration MUST make a
    // CONSCIOUS choice here (set 0, or wire a bond strap) per the handover
    // no-silent-chip-default rule: the retire PARKS the on-chip winscan, so an
    // ASIC that wants the classic always-armed behaviour, or a strap-gated
    // retire, sets this explicitly. Gates ONLY the retire SET; with 0 the
    // autonomy_armed term is bit-identical to the pre-fix RTL.
    parameter bit    RETIRE_EN            = 1'b1,
    // Per-tap settle dwell (apb_clk cycles). The host winscan sleeps ~50 ms per
    // tap so the IDELAYE2 reload + the cross-lane SYNC re-flood settle before
    // SYNC_DIST is sampled; 50 ms @ 50 MHz apb_clk ≈ 2.5 M cycles. Generous by
    // design — this dwell is the key correctness knob (too short and a lane is
    // sampled mid-reload / before SYNC re-floods, picking a false centre). In
    // simulation the IDELAY is passthrough and SYNC floods every beat, so the
    // TB shrinks it via the `tb_winscan_dwell_short_q` hierarchical hook (same
    // pattern as the calibrator's tb_early_exit_force_q) — see the FSM block.
    parameter int    WINSCAN_DWELL        = 2_500_000
) (

    // ── Clocks and Resets ────────────────────────────────────────────────
    input  wire             apb_clk,
    input  wire             app_clk,
    input  wire             user_hsclk,

    input  wire             poresetn,           // Power-on reset (active-low, clears role)
    input  wire             hresetn,            // System reset (active-low, preserves role)

    input  wire             sb_reset_in,
    output wire             sb_reset_out,
    output wire             sb_wake,

    // ── Role Configuration ───────────────────────────────────────────────
    input  wire             role_strap_i,        // 0=master, 1=slave (strap default)
    output wire             role_is_master_o,    // Effective role: 1=master
    output wire             role_locked_o,       // 1=role is locked, Wlink active

    // ── Debug strap: when 1, ungates external APB writes to Wlink in slave
    //                mode. Lets the slave's PYNQ Linux drive Wlink config
    //                directly, without I2C from the master. Bring-up debug
    //                only — not for production silicon.
    //
    //                DEBUG STRAP, tied to 0 in production, TAP-driven in
    //                debug only. As of Phase 4 of the autonomy plan
    //                (docs/ASIC_FPGA_IDENTICAL_AUTONOMOUS_BRINGUP_PLAN_*),
    //                the FPGA bring-up flow (deploy_pair.sh) no longer
    //                asserts this strap at deploy: the autoneg FSM's
    //                mask_hs_local_match path drives mask_hs_match=1
    //                autonomously (see line 433). The AXI GPIO at
    //                0x4404_1000 is retained on the FPGA bitstream for
    //                future TAP-style debug poke, but is not written by
    //                the standard deploy script.
    input  wire             apb_debug_unlock_i,

    // ── Mask-handshake bypass strap: when 1, the peer-mask gate on
    //                role_lock is held permanently open. Default value
    //                is implementation-defined; production silicon ties
    //                this to 0 to enforce the handshake. Bring-up flows
    //                that don't yet drive the handshake (UVM, current
    //                FPGA bring-up scripts) tie it to 1.
    //
    //                DEBUG STRAP, tied to 0 in production, TAP-driven in
    //                debug only. Sibling of apb_debug_unlock_i — both are
    //                hardwired off on the chiplet bond pads and only
    //                asserted via a JTAG/TAP path for bench debug.
    input  wire             mask_hs_bypass_i,

    // ── Auto-Negotiation ────────────────────────────────────────────────
    input  wire [15:0]      nego_priority_i,     // External priority (OTP/UID)
    input  wire [15:0]      puf_seed,            // From TideChart PUF sampler
    input  wire             puf_ready,           // PUF sampling complete
    output wire             nego_error_irq,      // Negotiation error interrupt
    // Phase 1 G1b: sticky IRQ asserted when the autoneg FSM enters
    // ST_TRAIN_FAIL. Latches on the rising edge of train_fail_irq_w and
    // is cleared by a W1C to Region 8 slot 3'h3 (NEGO_TRAIN_CFG)
    // bit[16]. Held separately from `nego_error_irq` so existing handlers
    // don't get re-routed.
    output wire             train_fail_irq_o,

    // ── Controller Register Pass-Through (from tidelink_apb_regs) ────────
    //   ctrl_reg_addr widened to 5 bits (Bug N7/N8 silicon observability,
    //   2026-06-01). bits[4:3] now selects between three regions:
    //     2'b01 → Region 4 (ROLE/I²C/NEGO   @ 0x080-0x09C)
    //     2'b10 → Region 8 (SWI_*/NEGO_TRAIN_* @ 0x100-0x11C)
    //     2'b11 → Region C (autoneg observability @ 0x180-0x19C, RO)
    //
    // Bug N2 fix (2026-05-29): the input ports were renamed to
    // `apb_ctrl_reg_*` (external CPU/AHB→APB master from tidelink_apb_regs).
    // Internal nets `ctrl_reg_*` are OR-merged below with a slv_apb_*
    // (I²C-driven) decode so that the peer's I²C-write to Region 4/8 lands
    // on the same decoder. See block titled "Bug N2 fix" below.
    input  wire             apb_ctrl_reg_write,
    input  wire  [4:0]      apb_ctrl_reg_addr,
    // SoC Labs PER-LANE SYNC-match sweep oracle + word-pin override (2026-06-16,
    // perlane-wp): Region 10 select (main APB port). High when the access is to
    // SoC 0x4403_2144/0x4403_2148/0x4403_214C (the new sweep-oracle / per-lane
    // word-pin registers). apb_region 4'b1010 would otherwise alias Region 8 on
    // ctrl_reg_addr[4:3]==2'b10, so the select rides a dedicated flag; the slot
    // (paddr[4:2]) is on ctrl_reg_addr[2:0] (folded onto the 2'b00 bank). V1 ties
    // this 0 -> the Region-10 bank is inert (bit-identical).
    input  wire             apb_ctrl_reg_r10,
    // SoC Labs RX-FRAMER long-DATA STICKY CAPTURE 2026-06-21 (rxcap) — Region D
    // disambiguator. Region D (paddr[8:5]=4'b1101, SoC 0x4403_21A0+) folds onto
    // ctrl_reg_addr[4:3]==2'b00 (same as Region 9/10); this 1-bit flag from
    // tidelink_apb_regs.sv picks Region D, exactly mirroring apb_ctrl_reg_r10.
    input  wire             apb_ctrl_reg_rd,
    // SoC Labs AXI data-node observability 2026-07-29 (I4) — Region F
    // disambiguator. Region F (paddr[8:5]=4'b1111, SoC 0x4403_21E0+) folds onto
    // ctrl_reg_addr[4:3]==2'b00 (same as Region 9/10/D); this 1-bit flag from
    // tidelink_apb_regs.sv picks Region F, exactly mirroring apb_ctrl_reg_rd.
    // Unlike the V2-only 9/10/D banks, Region F is LIVE in both V1 and V2 (the
    // AXI data nodes exist in both), so it is never tied 0 downstream.
    input  wire             apb_ctrl_reg_rf,
    input  wire  [31:0]     apb_ctrl_reg_wdata,
    output logic [31:0]     ctrl_reg_rdata,

    // ── Wlink APB (external, from tidelink_top decode) ───────────────────
    input  wire             apb_psel,
    input  wire  [12:0]     apb_paddr,
    input  wire             apb_penable,
    input  wire  [2:0]      apb_pprot,
    input  wire  [3:0]      apb_pstrb,
    input  wire             apb_pwrite,
    input  wire  [31:0]     apb_pwdata,
    output wire  [31:0]     apb_prdata,
    output wire             apb_pready,
    output wire             apb_pslverr,

    // ── AXI Target (from XHB500 AHB→AXI bridge) ─────────────────────────
    input  wire             axi_tgt_0_aw_valid,
    output wire             axi_tgt_0_aw_ready,
    input  wire  [11:0]     axi_tgt_0_aw_bits_id,
    input  wire  [35:0]     axi_tgt_0_aw_bits_addr,
    input  wire  [7:0]      axi_tgt_0_aw_bits_len,
    input  wire  [2:0]      axi_tgt_0_aw_bits_size,
    input  wire  [1:0]      axi_tgt_0_aw_bits_burst,
    input  wire             axi_tgt_0_aw_bits_lock,
    input  wire  [3:0]      axi_tgt_0_aw_bits_cache,
    input  wire  [2:0]      axi_tgt_0_aw_bits_prot,
    input  wire  [3:0]      axi_tgt_0_aw_bits_qos,

    input  wire             axi_tgt_0_w_valid,
    output wire             axi_tgt_0_w_ready,
    input  wire  [31:0]     axi_tgt_0_w_bits_data,
    input  wire  [3:0]      axi_tgt_0_w_bits_strb,
    input  wire             axi_tgt_0_w_bits_last,

    output wire             axi_tgt_0_b_valid,
    input  wire             axi_tgt_0_b_ready,
    output wire  [11:0]     axi_tgt_0_b_bits_id,
    output wire  [1:0]      axi_tgt_0_b_bits_resp,

    input  wire             axi_tgt_0_ar_valid,
    output wire             axi_tgt_0_ar_ready,
    input  wire  [11:0]     axi_tgt_0_ar_bits_id,
    input  wire  [35:0]     axi_tgt_0_ar_bits_addr,
    input  wire  [7:0]      axi_tgt_0_ar_bits_len,
    input  wire  [2:0]      axi_tgt_0_ar_bits_size,
    input  wire  [1:0]      axi_tgt_0_ar_bits_burst,
    input  wire             axi_tgt_0_ar_bits_lock,
    input  wire  [3:0]      axi_tgt_0_ar_bits_cache,
    input  wire  [2:0]      axi_tgt_0_ar_bits_prot,
    input  wire  [3:0]      axi_tgt_0_ar_bits_qos,

    output wire             axi_tgt_0_r_valid,
    input  wire             axi_tgt_0_r_ready,
    output wire  [11:0]     axi_tgt_0_r_bits_id,
    output wire  [31:0]     axi_tgt_0_r_bits_data,
    output wire  [1:0]      axi_tgt_0_r_bits_resp,
    output wire             axi_tgt_0_r_bits_last,

    // ── AXI Initiator (to XHB500 AXI→AHB bridge) ────────────────────────
    output wire             axi_ini_0_aw_valid,
    input  wire             axi_ini_0_aw_ready,
    output wire  [11:0]     axi_ini_0_aw_bits_id,
    output wire  [35:0]     axi_ini_0_aw_bits_addr,
    output wire  [7:0]      axi_ini_0_aw_bits_len,
    output wire  [2:0]      axi_ini_0_aw_bits_size,
    output wire  [1:0]      axi_ini_0_aw_bits_burst,
    output wire             axi_ini_0_aw_bits_lock,
    output wire  [3:0]      axi_ini_0_aw_bits_cache,
    output wire  [2:0]      axi_ini_0_aw_bits_prot,
    output wire  [3:0]      axi_ini_0_aw_bits_qos,

    output wire             axi_ini_0_w_valid,
    input  wire             axi_ini_0_w_ready,
    output wire  [31:0]     axi_ini_0_w_bits_data,
    output wire  [3:0]      axi_ini_0_w_bits_strb,
    output wire             axi_ini_0_w_bits_last,

    input  wire             axi_ini_0_b_valid,
    output wire             axi_ini_0_b_ready,
    input  wire  [11:0]     axi_ini_0_b_bits_id,
    input  wire  [1:0]      axi_ini_0_b_bits_resp,

    output wire             axi_ini_0_ar_valid,
    input  wire             axi_ini_0_ar_ready,
    output wire  [11:0]     axi_ini_0_ar_bits_id,
    output wire  [35:0]     axi_ini_0_ar_bits_addr,
    output wire  [7:0]      axi_ini_0_ar_bits_len,
    output wire  [2:0]      axi_ini_0_ar_bits_size,
    output wire  [1:0]      axi_ini_0_ar_bits_burst,
    output wire             axi_ini_0_ar_bits_lock,
    output wire  [3:0]      axi_ini_0_ar_bits_cache,
    output wire  [2:0]      axi_ini_0_ar_bits_prot,
    output wire  [3:0]      axi_ini_0_ar_bits_qos,

    input  wire             axi_ini_0_r_valid,
    output wire             axi_ini_0_r_ready,
    input  wire  [11:0]     axi_ini_0_r_bits_id,
    input  wire  [31:0]     axi_ini_0_r_bits_data,
    input  wire  [1:0]      axi_ini_0_r_bits_resp,
    input  wire             axi_ini_0_r_bits_last,

    // ── General Bus (interrupt forwarding) ───────────────────────────────
    input  wire  [31:0]     generalbus_in,
    output wire  [31:0]     generalbus_out,

    // ── TideLink FC Node (packed bus) ────────────────────────────────────
    input  wire  [49:0]     tidelink_in,
    output wire  [49:0]     tidelink_out,

    // ── PTP Short Packet (packed bus) ────────────────────────────────────
    input  wire  [25:0]     ptp_in,
    output wire  [25:0]     ptp_out,

    // ── TX Link Idle ─────────────────────────────────────────────────────
    output wire             tx_link_idle,

    // ── I2C Sideband AXI (master mode: CPU → I2C master → remote) ───────
    input  wire             s_i2c_axi_awvalid,
    input  wire  [1:0]      s_i2c_axi_awid,
    input  wire  [3:0]      s_i2c_axi_awaddr,
    input  wire  [7:0]      s_i2c_axi_awlen,
    input  wire  [2:0]      s_i2c_axi_awsize,
    input  wire  [1:0]      s_i2c_axi_awburst,
    input  wire             s_i2c_axi_awlock,
    input  wire  [3:0]      s_i2c_axi_awcache,
    input  wire  [2:0]      s_i2c_axi_awprot,
    output wire             s_i2c_axi_awready,

    input  wire             s_i2c_axi_wvalid,
    input  wire  [31:0]     s_i2c_axi_wdata,
    input  wire  [3:0]      s_i2c_axi_wstrb,
    input  wire             s_i2c_axi_wlast,
    output wire             s_i2c_axi_wready,

    output wire             s_i2c_axi_bvalid,
    output wire  [1:0]      s_i2c_axi_bid,
    output wire  [1:0]      s_i2c_axi_bresp,
    input  wire             s_i2c_axi_bready,

    input  wire             s_i2c_axi_arvalid,
    input  wire  [1:0]      s_i2c_axi_arid,
    input  wire  [3:0]      s_i2c_axi_araddr,
    input  wire  [7:0]      s_i2c_axi_arlen,
    input  wire  [2:0]      s_i2c_axi_arsize,
    input  wire  [1:0]      s_i2c_axi_arburst,
    input  wire             s_i2c_axi_arlock,
    input  wire  [3:0]      s_i2c_axi_arcache,
    input  wire  [2:0]      s_i2c_axi_arprot,
    output wire             s_i2c_axi_arready,

    output wire             s_i2c_axi_rvalid,
    output wire  [1:0]      s_i2c_axi_rid,
    output wire  [31:0]     s_i2c_axi_rdata,
    output wire  [1:0]      s_i2c_axi_rresp,
    output wire             s_i2c_axi_rlast,
    input  wire             s_i2c_axi_rready,

    // ── I2C Interrupts ───────────────────────────────────────────────────
    output wire             i2c_nbsy_irq,
    output wire             i2c_nrd_empty_irq,

    // ── I2C Pins (tristate, active-low drive) ────────────────────────────
    input  wire             i2c_scl_i,
    output wire             i2c_scl_o,
    output wire             i2c_scl_t,
    input  wire             i2c_sda_i,
    output wire             i2c_sda_o,
    output wire             i2c_sda_t,

    // ── Scan / DFT ───────────────────────────────────────────────────────
    input  wire             scan_mode,
    input  wire             scan_asyncrst_ctrl,
    input  wire             scan_clk,
    input  wire             scan_shift,
    input  wire             scan_in,
    output wire             scan_out,

    // ── Wlink Interrupt ──────────────────────────────────────────────────
    output wire             interrupt,

    // ── PHY Pads ─────────────────────────────────────────────────────────
    output wire             pad_clk_tx,
    output wire  [7:0]      pad_tx,
    input  wire             pad_clk_rx,
    input  wire  [7:0]      pad_rx,

    // ── §9 per-lane IDELAYE2 RX delay (FPGA only; USE_IDELAY=1) ───────────
    // 200 MHz IDELAYCTRL reference clock + its active-high reset. Both are
    // completely unused when USE_IDELAY=0 (passthrough) — tie to 1'b0 in
    // sim / ASIC. The FPGA BD drives idelay_ref_clk from a clk_wiz 200 MHz
    // output (see tidelink_design.tcl change spec in the agent report).
    input  wire             idelay_ref_clk,
    input  wire             idelay_rst,

    // ── v2 Eye visibility (docs/EYE_VISIBILITY_RTL_PROPOSAL.md) ───────────
    // Calibrator control surface (driven by tidelink_eye_regs at top level).
    input  wire  [2:0]      swi_eye_lane_sel_i,
    input  wire  [31:0]     swi_eye_dwell_us_i,
    input  wire  [31:0]     swi_eye_ctrl_i,
    input  wire  [6:0]      eye_score_idx_i,
    // Calibrator status / score readouts back to the eye_regs shim.
    output wire  [31:0]     eye_status_o,
    output wire  [5:0]      eye_score_data_o,
    output wire             eye_score_lane_passed_o,
    output wire  [5:0]      eye_score_best_o,
    output wire  [2:0]      eye_score_best_slip_o,
    output wire  [3:0]      eye_score_best_phase_o,
    // tidelink-gpio-phy lane_checker control & observability (replaces the
    // pre-rewrite crc_err_cnt counters; see deps/tidelink-gpio-phy spec §6, §10).
    input  wire  [23:0]     lane_lock_thresh_i,        // 8 × 3-bit per lane
    input  wire             lane_clear_noise_i,        // 1-cycle pulse from APB
    output wire  [7:0]      lane_mismatch_pulse_o,     // 1-cycle pulse per lane
    output wire  [15:0]     lane_wire_status_o,        // 8 × 2-bit wire status
    output wire  [39:0]     lane_dist_raw_o,           // 8 × 5-bit
    output wire  [39:0]     lane_dist_voted_o,         // 8 × 5-bit
    output wire  [39:0]     lane_dwell_min_dist_o,     // 8 × 5-bit
    output wire  [39:0]     lane_noise_min_o,          // 8 × 5-bit
    output wire  [39:0]     lane_noise_max_o,          // 8 × 5-bit
    output wire  [39:0]     lane_noise_mean_o,         // 8 × 5-bit
    output wire  [39:0]     lane_noise_current_o,      // 8 × 5-bit
    output wire  [7:0]      lane_canary_pass_o,        // bit-order canary
    output wire  [7:0]      lane_canary_valid_o,       // canary measurement done
    // Recovered RX clock — for the tidelink-gpio-phy APB slave's link_rx_clk
    // port at tidelink_top scope (spec §6 CDC contract; spec §10).
    output wire             link_rx_clk_o,
    // EYE_LAST_LATCHED mirror (current calibrator outputs).
    output wire  [23:0]     eye_last_slip_o,
    output wire  [7:0]      eye_last_lane_fault_o,
    // SoC Labs Bug-A FCSM observation 2026-06-02 — surface the three FCSM
    // gate signals up to tidelink_top so mark_debug at top level can route
    // them through the dbg_hub for ILA capture. (mark_debug inside the IP
    // package gets stripped by the IP-packaging step; doing it at top
    // works — see fc_rx_fifo_wdata pattern.)
    output wire             obs_a2l_replay_link_valid_o,
    output wire  [7:0]      obs_fe_rx_credit_max_o,
    output wire             obs_fe_rx_is_full_o,
    // SoC Labs Bug-A FCSM observation 2026-06-03
    output wire             obs_a2l_replay_app_valid_o,
    // SoC Labs TideChart sequencing contract 2026-07-17 (G1 dual-root fix) —
    // docs/TIDECHART_G1_SEQUENCING_CONTRACT.md.
    //
    // "The Wlink link layer is in its credit/data-exchange region", i.e. the
    // link genuinely CARRIES FC/EXT words. This is a strictly LATER milestone
    // than role_locked_o (~5us later in sim): role_locked only means the roles
    // are settled and PHY training MAY start. TideChart's root election must be
    // gated on THIS, not on role_locked/link_active — gating on role_locked
    // elects before any CLAIM can cross the die boundary, so both dies
    // self-root (a silent dual-root).
    //
    // Domain: apb_clk. Source is sync_obs_fcsm_state_1, the far side of the
    // existing 2-flop apb_clk synchroniser on the Wlink FCSM state (the same
    // net already published as APB 0x2108[19:17] and already consumed by the
    // retire-autonomy logic). NOTE the decode `>= 3'd4` on a 3-bit state is
    // EXACTLY bit [2], so this is a single synchronised flop output with no
    // multi-bit decode hazard — it cannot glitch on a partial CDC update.
    // The FCSM's operational region is states 4..7 (4=data exchange,
    // 5=LINK_DATA, 6=SEND_ACK, 7=SEND_NACK); 0..3 are reset/CR/credit init.
    // That region is CLOSED — no arc returns to 0..3 short of reset — so
    // bit[2] is exactly "the LL has reached its operational region", and it is
    // monotonic by construction. Holding through 6/7 is INTENDED: SEND_ACK is
    // routine healthy traffic and SEND_NACK is a retransmission request, not a
    // link-down event. This port is NOT a link-health/liveness signal; if one
    // is ever needed it must be a separate port.
    // (Corrected 2026-07-19 after review finding F8 — the previous "states are
    // 0..5" was false; 6 and 7 exist. See the contract doc §3.1/§6.5.)
    // See docs/TIDECHART_G1_SEQUENCING_CONTRACT.md §3.1.
    output wire             data_mode_o
`ifdef TIDELINK_PHY_V2
    // SoC Labs V2 epoch-anchor engagement obs 2026-06-14 — pass-through of the
    // WlinkGPIOPHY lane-deskew anchor state up to tidelink_top's
    // tidelink_gpio_phy_apb_regs.epoch_*_i (SWI_EPOCH_STATUS @ 0x4403_2140).
    // link_rx_rx_link_clk domain; the APB slave 2-flop-syncs into apb_clk
    // itself, so NO sync here. V1 builds never see these ports.
    ,
    output wire             obs_epoch_anchored_o,
    output wire  [5:0]      obs_epoch_span_o,
    // TL-009 leak witness from tidelink_top's XHB500 ahb_sub side (Region F slot
    // 3'h6 @ 0x21F8). Unconnected in bare-link/debug tb instantiations (floats,
    // harmless — they never read 0x21F8); tidelink_top drives it on the HW build.
    input  wire  [31:0]     xhb_sub_obs_word_i
`endif
);

    // =====================================================================
    // Internal resets (Wlink uses active-high)
    // =====================================================================
    wire apb_reset     = ~hresetn;
    // SoC Labs 2026-06-21: app_clk_reset assigned below (after role_locked decl) so it
    // can mirror wlink_por_reset's ~role_locked gating. This makes the a2l replay FIFO's
    // app/write-side reset release COHERENTLY with its link/read-side reset (which is
    // already held by ~role_locked), eliminating the asymmetric reset-RELEASE skew that
    // desyncs the replay ACK-pointer synchronizer (silicon: a2l_full=1 / link_empty=1 on
    // the first AHB_TX write -> FCSM wedged state 4 -> die_b RXW=0). NOT apb_reset, which
    // must stay alive pre-role_locked so SW can drive the bring-up recipe + read OBS taps.
    wire app_clk_reset;

    // =====================================================================
    // Bug N2 fix (2026-05-29) — slv_apb_* fan-out to Region 4/8 + readback
    //
    // Diagnosis (docs/BUG_N2_DIAGNOSIS.md): the slave's I²C-driven APB ingress
    // (slv_apb_*) used to be muxed solely onto the Wlink core (wl_apb_*).
    // Region 4 / Region 8 chiplet-controller registers (ROLE_CFG, NEGO_*,
    // SWI_TRAINING_MODE @ 0x100, SWI_LANE_STATUS @ 0x108, …) sit BEHIND
    // ctrl_reg_write / ctrl_reg_addr / ctrl_reg_wdata, which up to now
    // were driven ONLY by the external CPU/AHB→APB master (renamed to
    // apb_ctrl_reg_* on this module's input port). The peer-side I²C
    // burst from the master autoneg FSM (ST_TRAIN_ENTER, etc.) therefore
    // never reached the slave's chiplet-controller register decoder, so
    // swi_training_mode_r stayed at 0 and ST_TRAIN_POLL_PEER timed out.
    //
    // Fix shape (Shape B from the diagnosis): inside this module, decode
    // slv_apb_* and OR-merge a locally-generated ctrl_reg_* path with the
    // external (apb_ctrl_reg_*) path. The merged ctrl_reg_* nets feed all
    // the existing Region 4 and Region 8 write logic untouched, so this
    // change is a strict fan-in widening — Wlink keeps owning every
    // address that does NOT decode to Region 4 / Region 8.
    //
    // Forward declarations: slv_apb_* are driven by the AXIL→APB bridge
    // instance below (u_axil2apb), but are needed up here so the merged
    // ctrl_reg_* wires can be referenced from the Role / Region-4 /
    // Region-8 logic that follows.
    // =====================================================================
    wire            slv_apb_psel;
    wire [12:0]     slv_apb_paddr;
    wire            slv_apb_penable;
    wire [2:0]      slv_apb_pprot;
    wire            slv_apb_pwrite;
    wire [31:0]     slv_apb_pwdata;
    wire [3:0]      slv_apb_pstrb;

    // slv_apb_* targets the chiplet-controller register decoder when its
    // address falls in Region 4 (paddr[8:5]=4'b0100 → 0x080-0x09C) or
    // Region 8 (paddr[8:5]=4'b1000 → 0x100-0x11C). Mirrors the external
    // path's decode in tidelink_apb_regs.sv:443-445.
    //
    // Note: no need to gate on !role_is_master here — the i2c_slave core
    // (drives slv_apb_*) is held in reset whenever role_is_master=1
    // (see i2c_slv_reset below: `~hresetn | role_is_master`). So
    // slv_apb_psel never pulses while we are master, and we avoid a
    // forward-reference to role_is_master.
    wire slv_apb_ctrl_region4 = (slv_apb_paddr[8:5] == 4'b0100);
    wire slv_apb_ctrl_region8 = (slv_apb_paddr[8:5] == 4'b1000);
    wire slv_apb_ctrl_regionC = (slv_apb_paddr[8:5] == 4'b1100);
    wire slv_apb_ctrl_hit     = slv_apb_psel &&
                                (slv_apb_ctrl_region4 || slv_apb_ctrl_region8 || slv_apb_ctrl_regionC);
    // Single-beat APB write completion: psel & penable & pwrite — one cycle.
    wire slv_apb_ctrl_write   = slv_apb_ctrl_hit && slv_apb_penable && slv_apb_pwrite;

    // ctrl_reg_addr layout (see tidelink_apb_regs.sv).
    //   ctrl_reg_addr = {paddr[8:7], paddr[4:2]} (5 bits)
    //     bits[4:3] = 2'b01 → Region 4
    //     bits[4:3] = 2'b10 → Region 8
    //     bits[4:3] = 2'b11 → Region C (Bug N7/N8 observability, RO)
    wire [4:0]  slv_ctrl_reg_addr  = {slv_apb_paddr[8:7], slv_apb_paddr[4:2]};
    wire [31:0] slv_ctrl_reg_wdata = slv_apb_pwdata;

    // OR-merge the external APB-driven ctrl_reg_* path with the I²C-driven
    // (slv_apb_*) path. The external CPU is idle during autonomous bring-up,
    // so cycle-level conflict is not expected; if both fired together the
    // slv_apb path wins on write data (mux-after-OR semantics) and the FSM
    // would observe a single ctrl_reg_write strobe. In practice the external
    // path is quiescent during ST_TRAIN_ENTER, so the priority is moot —
    // documented here so a future arbitration scheme can replace the OR if
    // needed.
    //
    // IMPORTANT: ctrl_reg_addr must be driven from slv_apb_* whenever the
    // I²C path is targeting Region 4/8/C — INCLUDING READS — because the
    // combinational ctrl_reg_rdata mux below uses ctrl_reg_addr[4:3] to
    // pick Region 4 / Region 8 / Region C, and region{4,8,C}_rdata index
    // off ctrl_reg_addr[2:0]. The WRITE strobe (ctrl_reg_write) on the
    // other hand stays gated on penable & pwrite so the always_ff blocks
    // below only fire on a real write completion.
    wire        ctrl_reg_write = apb_ctrl_reg_write || slv_apb_ctrl_write;
    wire [4:0]  ctrl_reg_addr  = slv_apb_ctrl_hit ? slv_ctrl_reg_addr
                                                  : apb_ctrl_reg_addr;
    wire [31:0] ctrl_reg_wdata = slv_apb_ctrl_write ? slv_ctrl_reg_wdata
                                                    : apb_ctrl_reg_wdata;

    // =====================================================================
    // Role Register Block
    //   Reset only by poresetn (survives warm hresetn reset)
    //   Register map (via ctrl_reg_* pass-through):
    //     0: ROLE_CFG      [0]=role (0=master,1=slave), [1]=role_lock (W1S)
    //     1: ROLE_STATUS   [0]=effective_role, [1]=locked, [2]=i2c_busy, [3]=i2c_addressed  (RO)
    //     2: I2C_SLV_ADDR  [6:0]=device address (default 0x00)
    //     3: I2C_PRESCALE  [15:0]=I2C master prescaler (default 1)
    // =====================================================================

    logic        role_cfg_reg;       // bit[0] of ROLE_CFG
    logic        role_lock_reg;      // bit[1] of ROLE_CFG (W1S, POR-only clear)
    logic [6:0]  i2c_slv_addr_reg;
    // TL-021 first-silicon debug (David-gated, default 0 = bit-identical): SW
    // override at I2C_SLV_ADDR[7] (SoC 0x2088[7]) to release i2c_slv_reset while
    // master, so the on-silicon I2C sideband slave can be un-parked for probing.
    logic        i2c_slv_dbg_force_reg;
    logic [15:0] i2c_prescale_reg;

    // Auto-negotiation registers (POR-only reset domain)
    logic [6:0]  nego_cfg_reg;       // NEGO_CFG[6:0]; bit[6]=mask_hs_auto_en
    logic [15:0] nego_priority_reg;  // NEGO_PRIORITY[15:0]
    logic [31:0] nego_timeout_reg;   // NEGO_TIMEOUT[31:0]

    // Auto-negotiation FSM wire forward declarations (instantiated later)
    // Bug N7/N8 silicon observability: mark_debug on FSM-side AXIL bus + role-
    // arbitration nets. Inert unless FPGA_INSERT_DEBUG_CORE=1 at build time.
    wire [3:0]  nego_state_w;
    wire        nego_done_w, nego_error_w, nego_won_w, nego_lost_w, nego_sda_start_seen;
    wire        nego_role_w;
    wire        nego_set_role_cfg_w, nego_role_value_w, nego_set_role_lock_w;
    wire [7:0]  fsm_axil_awaddr;
                              wire [7:0]  fsm_axil_araddr;
    wire        fsm_axil_awvalid;
                              wire        fsm_axil_wvalid, fsm_axil_bready;
    wire        fsm_axil_arvalid, fsm_axil_rready;
    wire [31:0] fsm_axil_wdata;
    wire [3:0]  fsm_axil_wstrb;
    wire        nego_driving;

    wire         role_locked   = role_lock_reg;
    wire         nego_en       = nego_cfg_reg[0];
    wire         role_in_nego  = nego_en && !role_locked;
    wire         role_effective = role_locked  ? role_cfg_reg
                                : role_in_nego ? nego_role_w
                                :                role_strap_i;
    wire         role_is_master = ~role_effective;

    assign role_is_master_o = role_is_master;
    assign role_locked_o    = role_locked;

    // I2C slave status (directly from core)
    wire i2c_slv_busy;
    wire i2c_slv_addressed;

    // ====================================================================
    // Peer-mask handshake gating
    //   Hardware refuses to assert role_lock unless the peer-mask handshake
    //   has reported a match. Sequence (SW-driven for now; FSM automation
    //   is a follow-up):
    //     1. Both sides program their own Wlink lane_mask @ 0x214.
    //     2. Negotiation runs as before; when nego completes the FSM pulses
    //        nego_set_role_lock_w → that latches into nego_lock_pending_reg.
    //     3. Master SW reads peer's lane_mask via I2C, compares, and writes
    //        either 0x01 (match) or 0x02 (fail) to peer's
    //        link_lane_mask_hs_result @ 0x21C.
    //     4. wlink_mask_hs_result[0] going high releases the gate;
    //        role_lock_reg latches on the next clock.
    //     5. wlink_mask_hs_result[1] going high latches the sticky
    //        nego_mask_mismatch_reg, which surfaces on nego_status[8] and
    //        contributes to nego_error_irq.
    //   apb_debug_unlock_i bypasses the gate entirely (existing debug strap;
    //   used by the UVM testbench and bring-up flows that don't yet drive
    //   the handshake).
    //
    //   Phase 4 autonomy update: apb_debug_unlock_i and mask_hs_bypass_i are
    //   both DEBUG STRAPS — tied to 0 in production silicon, TAP-driven for
    //   bench debug only. The autoneg FSM's mask_hs_local_match path (line
    //   428 below, driven by u_autoneg at lines 1272-1273) now closes the
    //   handshake without SW intervention, so the standard FPGA deploy
    //   script (pynq_host/scripts/deploy_pair.sh) no longer asserts the
    //   AXI GPIO at 0x4404_1000 (apb_debug_unlock) at deploy time.
    // ====================================================================
    wire [1:0] wlink_mask_hs_result;  // [0]=peer_says_match, [1]=peer_says_fail

    // Autoneg peer-mask scaffolding (Phase 2A). Outputs zero until Phase 2B
    // wires them to FSM capture/verdict logic.
    wire [7:0] autoneg_peer_tx_lane_mask;
    wire [7:0] autoneg_peer_rx_lane_mask;
    wire       autoneg_mask_hs_local_match;
    wire       autoneg_mask_hs_local_fail;
    // Combined match/fail: SW path (Wlink hs_result register, written by SW
    // or master peer over I2C) OR FSM path (autoneg_mask_hs_local_match,
    // driven by Phase 2B's HW handshake).
    wire mask_hs_match     = wlink_mask_hs_result[0] | autoneg_mask_hs_local_match;
    wire mask_hs_fail      = wlink_mask_hs_result[1] | autoneg_mask_hs_local_fail;
    // 2026-07-24 — apb_debug_unlock_i REMOVED from this OR (F2b). It served TWO
    // unrelated purposes and they must be independent:
    //   (1) "bypass the peer-mask gate"  — a SHAM opener, removed here;
    //   (2) "enable external-APB WRITES to Wlink on a slave die" (:3599) — a
    //       real, still-needed bring-up capability.
    // Because one strap did both, the handshake could never be honest while
    // bring-up worked. MEASURED both ways on kr260-pair-onchip: with the strap
    // welded 1 the slave showed gate_open=1 while mask_hs_match=0 (the SHAM,
    // 07-23); with it driven 0 the gate became honest but the slave's Wlink
    // config writes were silently dropped read-only, so FC never bootstrapped
    // and BOTH dies stuck at fcsm=2 (07-24). Dropping the term here decouples
    // them: debug-unlock may stay asserted for bring-up WITHOUT ever forging a
    // peer-mask match.
    // The gate now opens ONLY on a genuine match, or via the dedicated
    // mask_hs_bypass_i debug strap (xlconstant 0 in production, and the ONLY
    // remaining explicit escape — which the §5.4 autonomy proof checks).
    wire mask_hs_gate_open = mask_hs_match | mask_hs_bypass_i;

    reg  nego_lock_pending_reg;
    // Sticky witness that a GENUINE peer-mask match was observed on this die
    // (never settable by mask_hs_bypass_i or the nego_lost_w free pass).
    // Gates entry to autonomous RETIRED operation; mirrored in OBS_MASK_HS[23].
    reg  mask_hs_verified_reg;
    reg  nego_mask_mismatch_reg;
    wire nego_error_irq_internal;

    // Role registers — POR-only reset domain
    always_ff @(posedge apb_clk or negedge poresetn) begin
        if (!poresetn) begin
            role_cfg_reg           <= 1'b0;
            role_lock_reg          <= 1'b0;
            i2c_slv_dbg_force_reg  <= 1'b0;   // TL-021 debug override: default OFF (bit-identical)
            i2c_slv_addr_reg       <= 7'h7E;  // default to autoneg slave address so
                                                // post-role_lock device_address mux
                                                // doesn't NACK in-flight claim writes
            // Bug N1 second-cause fix (2026-05-29): POR default i2c_prescale=1
            // produces ~12.5 MHz I²C SCL at 50 MHz apb_clk, far above any
            // sensible bus rate. The slave's bit-detection FSM cannot track
            // those edges, so the address byte is mis-shifted, the slave
            // wedges holding SDA low, and the master's i2c_master_axil
            // bus_active_reg stays asserted forever (STATE_START_WAIT loop).
            // The autoneg FSM in turn polls TXN_POLL → TXN_CHECK → TXN_POLL
            // indefinitely because I2C_STS_BUSY never clears.
            //
            // 16'd125 yields 50 MHz / (125 * 4) = 100 kHz — the I²C standard
            // bus rate — which is the lowest spec-compliant value and gives
            // the slave's start/stop/bit detector ample margin. The TXN_PRESCALE
            // sub-step at ST_NEGO_CLAIM writes this value into the master's
            // PRESCALE register before the first CLAIM transaction, so the
            // entire autoneg mask-handshake runs at 100 kHz from cold boot.
            // See probe trace in test_13_bug_n1_second_cause_probe.py.
            i2c_prescale_reg       <= 16'd125;
            nego_cfg_reg           <= NEGO_CFG_RESET;
            // Bug N7 fix (2026-06-01): role_strap-derived asymmetric POR.
            // Identical priority on both dies (16'hFFFF default) made the
            // autoneg ST_NEGO_WAIT backoff timer compute identical delays
            // → neither claims first → both timeout → ST_ERROR with
            // sda_start_seen=0. test_18 reproduces it in sim (1258 s wall
            // pre-fix). The strap bit differentiates the two dies at FPGA
            // POR (axi_gpio_strap DOUT default per-target — die_a=0,
            // die_b=1), so this POR value is correct at the moment the
            // autoneg FSM samples nego_priority_reg.
            //   strap=0 (die_a / master) → priority=1 → low backoff → claims first
            //   strap=1 (die_b / slave)  → priority=2 → higher backoff → defers
            nego_priority_reg      <= role_strap_i ? 16'h0002 : 16'h0001;
            nego_timeout_reg       <= 32'd131_082_000;
            nego_lock_pending_reg  <= 1'b0;
            nego_mask_mismatch_reg <= 1'b0;
            mask_hs_verified_reg   <= 1'b0;
        end else begin
            // 2026-07-24 — GENUINE-HANDSHAKE WITNESS (sticky, POR-only clear).
            // Latches the first cycle this die observes a REAL peer-mask match:
            // either its own comparator verdict (master) or the winner's I2C
            // verdict byte sniffed at Wlink 0x21C (slave, see Wlink.v). It is
            // deliberately driven from mask_hs_match ALONE — never from
            // mask_hs_bypass_i and never from nego_lost_w — so no strap and no
            // "trust the winner" fallback can forge it.
            //
            // WHY THIS EXISTS: role_lock still latches on the lost path via the
            // nego_lost_w free pass (see the role_lock block below), because
            // role_locked is a MUTUAL CLOCK ENABLE — wlink_por_reset (:2832)
            // gates this die's forwarded pad_clk_tx, which IS the peer's
            // pad_clk_rx. Making role_lock itself wait for the verdict would
            // (a) collapse the ~3.1 ms bring-up stagger the CR/CRACK exchange
            // relies on, and (b) on the I2C-NACK fallback leave a die that never
            // receives a verdict permanently gating its own PHY clock — a hard,
            // bilateral, unrecoverable dead link.
            // So integrity is enforced HERE instead: this witness gates entry to
            // autonomous RETIRED operation, which fails closed in a recoverable,
            // observable way rather than by bricking the clock.
            if (mask_hs_match)
                mask_hs_verified_reg <= 1'b1;

            // Sticky mismatch: latch on the first cycle the peer reports fail.
            if (mask_hs_fail)
                nego_mask_mismatch_reg <= 1'b1;

            // Latch the FSM's role-lock request OR a SW W1S of ROLE_CFG[1]
            // pre-lock; release on gate-open. The pending bit lets us hold
            // the lock intent across cycles while waiting for the
            // mask-handshake gate to open.
            if (nego_set_role_lock_w ||
                (ctrl_reg_write && !role_locked && ctrl_reg_addr == 5'b01_000 && ctrl_reg_wdata[1]))
                nego_lock_pending_reg <= 1'b1;
            else if (nego_lock_pending_reg && (mask_hs_gate_open || nego_lost_w || SELF_ARM_TRAIN_EN))
                // Bug N9 fix: also clear pending on the lost path so the
                // (SELF_ARM_TRAIN_EN: clear pending on the self-arm path too, so
                //  the pending bit doesn't stay stuck after role_lock latches via
                //  the self-arm term below — symmetric with the lost-side clear.
                //  Default 0 ⇒ this term constant-folds away, bit-identical.)
                // pending bit doesn't stay asserted after role_lock_reg
                // has latched via the lost-side workaround below.
                // (2026-07-24: this term is paired with the lost-side lock
                // below — both were retired together as F3 and both were
                // REVERTED together after the silicon A/B showed fcsm stalling
                // at 2. Do not remove one without the other: clearing on
                // nego_lost_w while the lock requires a gate would drop the
                // intent and deadlock the slave.)
                nego_lock_pending_reg <= 1'b0;

            if (nego_set_role_cfg_w) begin
                // FSM role-cfg write-back has priority (single-cycle pulse).
                role_cfg_reg <= nego_role_value_w;
            end

            // role_lock latches when (a) the FSM has pending lock and the
            // mask gate is open, OR (b) software writes the lock bit and
            // the mask gate is open.
            //
            // Bug N9 fix (2026-06-02): the lost-side never opens its own
            // gate. When master loses autoneg (MISS_ACK on CLAIM, or
            // sda_start_detect early-exit on the slave's WAIT) the FSM
            // parks at ST_NEGO_DONE with nego_lost_w=1 and does NOT walk
            // the local MASK_RD_* / MASK_RES_TX states — so
            // autoneg_mask_hs_local_match stays 0. The fallback is
            // wlink_mask_hs_result[0]=1 (the peer writing the verdict
            // byte over I²C into our 0x21C reg), but the Wlink submodule
            // currently hardwires mask_hs_result_o to 2'b00
            // (deps/axi-chiplet-controller/logical/wlink/Wlink.v:210 —
            // port stub awaiting Chisel regen). With both gate-openers
            // permanently 0 on the lost side, role_lock_reg never
            // latches even though nego_lock_pending_reg is set.
            //
            // Workaround until the Wlink stub is regenerated: on the
            // lost path, trust the winner. The peer that won the autoneg
            // arbitration is responsible for the mask handshake; the
            // local die has neither participated in the comparison nor
            // can observe its outcome (Wlink port stubbed). Honour the
            // FSM's nego_set_role_lock pulse without waiting for a gate
            // signal that will never arrive.
            //
            // 2026-07-24 (F3) — ATTEMPTED AND REVERTED, MEASURED ON SILICON.
            // With the 0x21C verdict sniffer in place (F1) the lost side CAN
            // now open its own gate, so this free pass is no longer strictly
            // necessary and tightening it looked correct. It is NOT SAFE YET:
            // removing the `nego_lost_w` term makes the slave latch role_lock
            // LATER (only once the winner's I2C verdict has arrived) instead of
            // immediately at ST_NEGO_DONE. role_locked gates the slave's Wlink
            // out of reset, so the later release misses the training window and
            // the FC state machine stalls.
            //   A/B on kr260-pair-onchip, identical flow, 2026-07-24:
            //     F1 only          -> match=1 gate=1 locked=1 fcsm=4  (healthy)
            //     F1 + this change -> match=1 gate=1 locked=1 fcsm=2  (stalled)
            // Sim did NOT catch it: the v2 pair test passes, and test_24's own
            // docstring disclaims asserting downstream training ("TRAIN_RUN /
            // TRAIN_POLL_PEER ... may still fail under straps=0, tracked
            // separately"). The integrity hole this would close is already
            // closed in practice by F1 (the slave's gate opens on a genuine
            // match), so the free pass is now redundant rather than load-bearing.
            // TO RETIRE IT PROPERLY: make the slave's Wlink-out-of-reset
            // independent of the role_lock TIMING (or hold the training window
            // open until the verdict lands), then re-run this A/B.
            if ((nego_lock_pending_reg && mask_hs_gate_open) ||
                (nego_lock_pending_reg && nego_lost_w) ||
                // I1 SELF-ARM (2026-07-30): third OR term. With the peer-I2C
                // control plane dead on the eth-chiplet, neither mask_hs_gate_open
                // nor nego_lost_w ever fires, so role_lock_reg stayed 0 and held
                // the mutual clock enable / calibrator in reset (cal_done=0,
                // fcsm=0). This latches role_lock on the SW ROLE_CFG[1] intent
                // (which set nego_lock_pending_reg above) as soon as the param is
                // enabled. mask_hs_verified_reg is NOT set here, so the honest
                // integrity witness is preserved. Default 1'b0 ⇒ constant-folds
                // away ⇒ every existing build is byte-behaviour-identical.
                (nego_lock_pending_reg && SELF_ARM_TRAIN_EN)) begin
                role_lock_reg <= 1'b1;
            end else if (ctrl_reg_write && !role_locked && ctrl_reg_addr == 5'b01_000) begin
                role_cfg_reg  <= ctrl_reg_wdata[0];
                if (ctrl_reg_wdata[1] && mask_hs_gate_open)
                    role_lock_reg <= 1'b1;
            end else if (ctrl_reg_write && !role_locked &&
                         (ctrl_reg_addr[4:3] == 2'b01) &&
                         (ctrl_reg_addr[2:0] != 3'h0)) begin
                // Slot 0 (ROLE_CFG) handled above with mask gate; remaining
                // pre-lock writable Region-4 registers handled here.
                case (ctrl_reg_addr[2:0])
                    3'h2: begin
                              i2c_slv_addr_reg      <= ctrl_reg_wdata[6:0];
                              i2c_slv_dbg_force_reg <= ctrl_reg_wdata[7]; // TL-021 debug override
                          end
                    3'h3: i2c_prescale_reg  <= ctrl_reg_wdata[15:0];
                    3'h4: nego_cfg_reg      <= ctrl_reg_wdata[6:0];
                    3'h6: nego_priority_reg <= ctrl_reg_wdata[15:0];
                    3'h7: nego_timeout_reg  <= ctrl_reg_wdata[31:0];
                    default: ;
                endcase
            end else if (ctrl_reg_write && role_locked &&
                         (ctrl_reg_addr[4:3] == 2'b01)) begin
                // After lock, only I2C slave address, prescale, and nego regs remain writable
                case (ctrl_reg_addr[2:0])
                    3'h2: begin
                              i2c_slv_addr_reg      <= ctrl_reg_wdata[6:0];
                              i2c_slv_dbg_force_reg <= ctrl_reg_wdata[7]; // TL-021 debug override
                          end
                    3'h3: i2c_prescale_reg  <= ctrl_reg_wdata[15:0];
                    3'h4: nego_cfg_reg      <= ctrl_reg_wdata[6:0];
                    3'h6: nego_priority_reg <= ctrl_reg_wdata[15:0];
                    3'h7: nego_timeout_reg  <= ctrl_reg_wdata[31:0];
                    default: ;
                endcase
            end
        end
    end

    // -----------------------------------------------------------------
    // §9 auto-cal calibrator + lane-checker output nets. Declared here
    // (hoisted above the Region 8 block) because the Region 8
    // SWI_LANE_STATUS CDC synchroniser references them and this module
    // uses `default_nettype none` (no forward net references). The nets
    // are *driven* by the tidelink_lane_checker / tidelink_phy_align_
    // calibrator instances further down in the §9 block.
    // -----------------------------------------------------------------
    wire [23:0] cal_bit_slip_w;
    // §9.7: per-lane 4-bit phase offset from the calibrator (8 lanes ×
    // 4 bits, lane N at [4N+3:4N]). OR-merged with the Region 8
    // SWI_PHASE_OFFSET override below, same pattern as cal_bit_slip_w.
    wire [31:0] cal_phase_offset_w;
    wire        cal_training_mode_w;
    wire        cal_calibration_done_w;
    wire [7:0]  cal_lane_fault_w;
    wire [3:0]  cal_state_w;
    // L4 training-exit-deadlock fix (2026-07-01): "locally parked in S_HOLD"
    // from the deps calibrator (rx_link_clk domain; CDC-synced to apb_clk as
    // sync_cal_in_hold_1 before feeding the autoneg FSM). This is the
    // rendezvous the autonomous training-exit uses (both dies in S_HOLD).
    wire        cal_in_hold_w;
    // M7 (2026-06-05): calibrator auto-retry counter for silicon observability
    wire [15:0] cal_resweep_ctr_w;
    // I1 winscan obs (2026-07-30): calibrator validation-timeout give-up flag
    // (sticky in the calibrator; was left UNCONNECTED on the V2 instance). RO tap
    // for tidelink_winscan_obs -> Region F WINSCAN_STAT[5]. Zero datapath change.
    wire        cal_valto_w;
    // EYE-WIDTH VISIBILITY (2026-06-17): per-lane-selected eye-width read from
    // the deps calibrator (rx_link_clk domain; CDC-synced to apb_clk before the
    // APB read mux). best = matched-window WIDTH (taps) of the SWI_EYE_LANE_SEL
    // lane; start (slip,phase) of that run; passed = best >= LOCK_THRESH.
    wire [5:0]  cal_eye_best_w;
    wire [3:0]  cal_eye_best_phase_w;
    wire [2:0]  cal_eye_best_slip_w;
    wire        cal_eye_lane_passed_w;
    // Task 3 (2026-06-17): effective eye-width lane select. In V2 the APB-writable
    // swi_eye_lane_sel_r (Region 10 slot 5, SoC 0x2154) drives it so all 8 lanes
    // scan remotely; in V1 it falls back to the swi_eye_lane_sel_i input port
    // (driven by tidelink_eye_regs at top level — bit-identical). The wire is
    // declared here; its continuous assignment lives below the swi_eye_lane_sel_r
    // declaration (VCS forbids forward reference to a reg under
    // `default_nettype none`).
    wire [2:0]  eye_lane_sel_eff;
    // Forward declarations — definitions below; needed early so the
    // tidelink-gpio-phy lane_checker instantiation can wire them in.
    wire [31:0] swi_phase_offset_w;
    wire        swi_training_mode_w;
    wire [7:0]  lane_locked_w;
    // Wlink-exposed recovered link clock + per-lane 16-bit deserialised data.
    wire [127:0] phy_link_rx_rx_link_data_w;
    wire         phy_link_rx_rx_link_clk_w;

    // -----------------------------------------------------------------
    // SoC Labs credit-path observability (RO APB exposure, replaces the
    // ILA debug core). Wlink surfaces the FCSM (LL_RX -> cr_pkt -> FCSM)
    // internals + the byte-align FSM internals + two 16-bit saturating
    // ECC event counters. These nets are driven by the Wlink instance
    // further down; declared here (above the Region 8 block) because the
    // Region 8 CDC synchroniser references them and this module uses
    // `default_nettype none` (forward net refs are illegal). All sources
    // live in the recovered-RX-link / FCSM clock domains; the 2-flop
    // sync into apb_clk below mirrors the existing sync_lane_locked_*
    // pattern. cocotb tests can hierarchically force the *_w nets.
    // -----------------------------------------------------------------
    wire [2:0]  obs_fcsm_state_w;
    wire        obs_cr_pkt_seen_rx_w;
    wire        obs_crack_pkt_seen_rx_w;
    wire        obs_pkt_is_cr_pkt_w;
    wire        obs_pkt_is_crack_pkt_w;
    wire [1:0]  obs_llrx_state_w;
    wire        obs_is_short_pkt_w;
    wire        obs_is_long_pkt_w;
    wire        obs_llrx_valid_w;
    // SoC Labs RX-FRAMER long-DATA STICKY CAPTURE 2026-06-21 (rxcap) — packed
    // sticky framer (llrx) + FCSM (tl2wl) words from the Wlink obs bundle.
    // rx-link-clk / io_rx_clk domains; 2-flop-synced to apb_clk below and read
    // at the new Region D (SoC MMIO 0x4403_21A0/0x4403_21A4/0x4403_21A8) in V2.
    wire [31:0] obs_rxcap0_w;
    wire [31:0] obs_rxcap1_w;
    wire [31:0] obs_fcsmcap_w;
    wire [15:0] obs_ecc_corrupted_cnt_w;
    wire [15:0] obs_ecc_corrected_cnt_w;
    // SoC Labs 2026-06-08: SYNC-detected saturating counter (cross-lane-skew obs)
    wire [15:0] obs_sync_detected_cnt_w;
    // SoC Labs Bug-A FCSM observation 2026-06-02
    wire        obs_a2l_replay_link_valid_w;
    wire [7:0]  obs_fe_rx_credit_max_w;
    wire        obs_fe_rx_is_full_w;
    // SoC Labs Bug-A FCSM observation 2026-06-03
    wire        obs_a2l_replay_app_valid_w;
    // SoC Labs V2 data-send observation 2026-06-21 — a2l replay buffer true
    // app_ready (app-clk domain) and link_empty (link-clk domain). Both are
    // pure read-only fan-outs of existing FCSM/replay nets, 2-flop synced to
    // apb_clk below and read at Region 10 slots 6/7 (SoC 0x4403_2158/0x215C).
    wire        obs_a2l_replay_app_ready_w;
    wire        obs_a2l_replay_link_empty_w;
    // SoC Labs V2 data-send RAW-POINTER observation 2026-06-21 — a2l replay
    // buffer raw write ptr / app-clk-synced ACK ptr / false-FULL flag / enable
    // demet term of app_ready. All app-clk domain, pure read-only fan-outs of
    // existing replay-buffer nets; 2-flop synced to apb_clk below and PACKED
    // into the spare bits of the 0x2158 A2L_REPLAY_OBS word.
    wire [4:0]  obs_a2l_wptr_w;
    wire [4:0]  obs_a2l_synced_ack_w;
    wire        obs_a2l_full_w;
    wire        obs_a2l_enable_app_demet_w;
    // SoC Labs V2 data-send LINK-SIDE RESET + READ-POINTER observation 2026-06-21
    // — a2l replay buffer read-side reset (== fifo_io_rreset) and LINK read
    // binary pointer (== link_cur_addr). Link-clk domain, pure read-only fan-outs
    // of existing replay-buffer nets; 2-flop synced to apb_clk below and PACKED
    // into the spare bits of the 0x2158 A2L_REPLAY_OBS word (rptr [18:14],
    // rreset [19]).
    wire        obs_a2l_rreset_w;
    wire [4:0]  obs_a2l_rptr_w;
    // SoC Labs FC credit observation 2026-06-12 — far-end RX credit pointer
    // (FCSM tx-clk domain). Consumed by the OBS_FC_CREDIT Region C slot.
    wire [7:0]  obs_fe_rx_ptr_w;
`ifdef TIDELINK_PHY_V2
    // SoC Labs SYNC-insert TX observability 2026-06-15 (PART 1) — raw probe from
    // the V2 WlinkGPIOPHY fork, io_link_tx_tx_link_clk domain. 2-flop synced to
    // apb_clk below (sync_obs_tx_sync_*). Read at the new SYNC-OBS register
    // (SoC MMIO 0x4403_2120). V2-only (the V1 PHY fork has no such ports).
    wire [15:0] obs_tx_sync_ins_cnt_w;
    wire        obs_tx_link_idle_level_w;
    wire        obs_tx_training_level_w;
    // SoC Labs RX mask-aware SYNC-beacon DETECT (2026-06-15, PART 1) — raw probe
    // from the V2 WlinkGPIOPHY fork (post-deskew word, rx-link-clk domain).
    // 2-flop synced to apb_clk below (sync_obs_sync_seen_*). Read at the new
    // SYNC-DETECT register (SoC MMIO 0x4403_2124). V2-only.
    wire [15:0] obs_sync_seen_cnt_w;
    wire [7:0]  obs_sync_seen_lane_w;
    // SoC Labs RX RAW-WORD + PERMUTATION obs (2026-06-15, rawobs) — raw probes
    // from the V2 WlinkGPIOPHY fork (post-deskew word, rx-link-clk domain).
    // 2-flop synced to apb_clk below (dbg_obs_*). Read at Region 9 slots 3..7
    // (SoC MMIO 0x4403_212C..0x4403_213C). V2-only.
    wire [127:0] obs_dbg_raw_word_w;
    wire [7:0]   obs_dbg_lane_any_match_w;
    wire [3:0]   obs_dbg_best_popcount_w;
    wire [31:0]  obs_dbg_slice_idx_w;
    // SoC Labs PER-LANE SYNC-match LIVE oracle (2026-06-16, perlane-wp) — raw
    // rx-link-clk-domain "matched since last clear" per-lane vector from the V2
    // WlinkGPIOPHY fork. 2-flop synced to apb_clk below (sync_obs_lane_live_*).
    // Read at the new LIVE-MATCH register (SoC MMIO 0x4403_2144). V2-only.
    wire [7:0]   obs_sync_lane_live_w;
    // SoC Labs STICKY-POISON per-lane deskew sync_seen vector (2026-06-23) — raw
    // rx-link-clk-domain per-lane "SYNC re-anchor committed" vector from the V2
    // WlinkGPIOPHY fork (deskew sync_seen_vec_o). 2-flop synced to apb_clk below
    // (sync_obs_seen_vec_*). Read at the new SYNC-SEEN register (SoC MMIO
    // 0x4403_215C, Region 10 slot 7, RO). V2-only.
    wire [7:0]   obs_sync_seen_vec_w;
    // DATA-MODE per-lane SYNC HAMMING-DISTANCE OBS (2026-06-25, the winscan
    // metric) — raw rx-link-clk-domain per-lane 5-bit Hamming distance of the
    // current word to that lane's SYNC slice from the V2 WlinkGPIOPHY fork
    // (deskew sync_dist_vec_o). 2-flop synced to apb_clk below
    // (sync_obs_dist_vec_*) then lane-selected. Read at the new SYNC-DIST
    // register (SoC MMIO 0x4403_21AC, Region D slot 3, RO). V2-only.
    wire [39:0]  obs_sync_dist_vec_w;
    // R-A FINALIZE ANCHOR-VERIFY (2026-07-04) — raw rx-link-clk-domain sticky
    // from the WavD2DGpio_v2 local override: the ENGAGED deskew re-anchor has
    // delivered >=1 post-deskew word EXACTLY equal to TIDELINK_SYNC_WORD on
    // every active lane simultaneously (zero tolerance — the wrong-slot
    // mis-anchor detector: a lane whose sticky sync_idx latched one slot off
    // matches its own slice one beat AWAY from the others, so the
    // simultaneous exact match can never fire on a mis-anchored link).
    // Cleared by POR / the F3 sync_obs_clr. 2-FF synced to apb_clk below
    // (ws_verify_q) and consumed by the winscan WS_FINALIZE release gate.
    wire         obs_anchor_verified_w;
`endif

    // Role/Region-4 register read mux. Region 8 reads served below the
    // region8_rdata mux and OR-merged into ctrl_reg_rdata.
    reg [31:0] region4_rdata;
    always_comb begin
        case (ctrl_reg_addr[2:0])
            3'h0:    region4_rdata = {30'b0, role_lock_reg, role_cfg_reg};
            3'h1:    region4_rdata = {28'b0, i2c_slv_addressed, i2c_slv_busy,
                                       role_locked, role_effective};
            3'h2:    region4_rdata = {24'b0, i2c_slv_dbg_force_reg, i2c_slv_addr_reg}; // [7]=TL-021 dbg override (default 0)
            3'h3:    region4_rdata = {16'b0, i2c_prescale_reg};
            3'h4:    region4_rdata = {25'd0, nego_cfg_reg};
            3'h5:    region4_rdata = {22'd0, nego_mask_mismatch_reg, nego_sda_start_seen, nego_lost_w, nego_won_w, nego_error_w, nego_done_w, nego_state_w};
            3'h6:    region4_rdata = {16'd0, nego_priority_reg};
            3'h7:    region4_rdata = nego_timeout_reg;
            default: region4_rdata = 32'b0;
        endcase
    end

    // Region 8 read mux is driven by the Phase 3 phy_align + I²C-train
    // register block instantiated below. Region C is the Bug N7/N8
    // autoneg observability bank (autoneg internal counters and i2c_master
    // STATUS). ctrl_reg_rdata picks Region 4 / Region 8 / Region C based on
    // ctrl_reg_addr[4:3].
    wire [31:0] region8_rdata;
    wire [31:0] regionC_rdata;
    // SoC Labs SYNC-insert TX obs 2026-06-15 (PART 1): the previously unused
    // region-select 2'b00 carries the new SYNC-OBS register bank (Region 9, SoC
    // MMIO 0x4403_2120-0x4403_213C). tidelink_apb_regs.sv maps apb_region
    // 4'b1001 onto ctrl_reg_addr[4:3]==2'b00. In V1 this bank is tied 0 so the
    // legacy default-0 read for that select is preserved.
    wire [31:0] region9_sync_obs_rdata;
    // SoC Labs perlane-wp (2026-06-16): Region 10 (SoC 0x2144/0x2148/0x214C)
    // shares the 2'b00 select with Region 9; apb_ctrl_reg_r10 picks Region 10.
    wire [31:0] region10_rdata;
    // SoC Labs RX-FRAMER long-DATA STICKY CAPTURE 2026-06-21 (rxcap) — Region D
    // (rxcap) read data. Folds onto the same 2'b00 controller select as Region
    // 9/10; apb_ctrl_reg_rd disambiguates (takes priority over r10/r9 because
    // tidelink_apb_regs.sv asserts at most one of {rd, r10} for a given paddr).
    wire [31:0] regionD_rxcap_rdata;
    // SoC Labs AXI data-node observability (I4, 2026-07-29). Region F
    // (0x4403_21E0+) also folds onto 2'b00; apb_ctrl_reg_rf picks it, taking
    // priority over rd/r10/r9 (tidelink_apb_regs.sv asserts at most one of
    // {rf, rd, r10} for any paddr). Live in both V1 and V2 (assigned below,
    // outside the `ifdef TIDELINK_PHY_V2` guard the other 2'b00 banks use).
    wire [31:0] regionF_axinodes_rdata;
    always_comb begin
        unique case (ctrl_reg_addr[4:3])
            2'b00:   ctrl_reg_rdata = apb_ctrl_reg_rf  ? regionF_axinodes_rdata
                                    : apb_ctrl_reg_rd  ? regionD_rxcap_rdata
                                    : apb_ctrl_reg_r10 ? region10_rdata
                                                       : region9_sync_obs_rdata;
            2'b01:   ctrl_reg_rdata = region4_rdata;
            2'b10:   ctrl_reg_rdata = region8_rdata;
            2'b11:   ctrl_reg_rdata = regionC_rdata;
            default: ctrl_reg_rdata = 32'b0;
        endcase
    end

    // =====================================================================
    // Region 8 — Chiplet Extended (PHY-align + I²C-train registers)
    //   Canonical home for the §9 soft-strap controls (formerly the interim
    //   shim at MMIO 0x4403_1000) plus the I²C-coordinated training
    //   protocol regs. Addresses are paddr 0x100..0x11C within the
    //   TideLink-config APB, MMIO 0x4403_2100..0x4403_211C. See
    //   docs/REGISTER_MAP.md "Region 8" and src/rdl/tidelink_regs.rdl.
    // =====================================================================

    // Slot 0 — SWI_TRAINING_MODE bit[0]. POR-only reset domain so training
    // state survives a warm hresetn.
    reg        swi_training_mode_r;
    // Slot 0 bit[1] — SWI_RECAL: SW-driven calibrator re-trigger. The
    // calibrator only self-triggers on the cold-boot role_locked rising
    // edge; under an SSH-staggered FPGA bring-up the two calibrators sweep
    // in non-overlapping windows and every lane faults with no way to
    // re-arm (role_lock is W1S, POR-only clear). This level bit feeds the
    // calibrator's `swreset`: SW writes {recal=1,train=1} to cancel the
    // stale S_DONE, holds the training pattern on BOTH boards, then writes
    // {recal=0,train=1}; the recal falling edge (role_locked still high)
    // re-triggers a fresh sweep that clears lane_fault — now against a live
    // peer pattern. POR-only domain, same as training_mode.
    reg        swi_recal_r;

    // ---------------------------------------------------------------------
    // Slot 0 bit[6] — SWI_FORCE_RECAL (P1, 2026-07-19, lane B1). WRITE-1-PULSE.
    //
    // THE DEFECT IT CLOSES: the calibrator latches `calibrated_once_q` on its
    // first S_DONE and from then on gates off BOTH re-trigger edges, so the
    // level SWI_RECAL above is a MEASURED NO-OP after first lock — there was no
    // firmware-reachable PHY retrain at all, in the FPGA image AND the ASIC
    // path (docs/LINK_RECOVERY_MECHANISM.md §4: the FSM was sampled 60x on both
    // dies and never left S_DONE; §6.1 P1 is this remedy).
    //
    // WHY A SEPARATE BIT AND NOT A WIDER SWI_RECAL: `swi_recal_r` shares the
    // calibrator's `swreset` port with the autoneg FSM's local_swreset_pulse_w.
    // calibrated_once_q exists precisely to reject that IMPLICIT pulse (Bug-A:
    // the winner's ST_TRAIN_EXIT recal re-entered training mid-FCSM-credit-init
    // and wedged the master at state 2 with zero TX credit). SWI_FORCE_RECAL is
    // driven by NOTHING but a deliberate APB write, so the calibrator can honour
    // it unconditionally without weakening that guard.
    //
    // WHY A PULSE STRETCHER: this is a W1P in the apb_clk domain (~100 MHz) but
    // the calibrator lives in rx_link_clk (~1.5-6.25 MHz on FPGA, /16 of pad
    // clk). A single apb_clk-wide pulse would be MISSED entirely by the
    // calibrator's 2-FF synchroniser — the classic slow-destination CDC trap.
    // Holding the request for FORCE_RECAL_STRETCH apb_clk cycles guarantees the
    // destination sees a stable 1 across many of its own edges (1024 apb cycles
    // ~= 15 rx_link_clk cycles at the WORST ratio of 100 MHz : 1.5 MHz). The
    // calibrator edge-detects the synced level, so a wide assertion still
    // produces exactly ONE re-arm.
    //
    // Bounded and self-clearing (no handshake, so no way to deadlock if the
    // calibrator never responds). POR-only domain, same as the two bits above.
    //
    // OPEN-LOOP, AND SAID PLAINLY: this timer has NO feedback path from the
    // calibrator. Its expiry means "the request was PRESENTED for 1024 apb_clk
    // cycles", NOT "the calibrator consumed it". The stretch is sized so that
    // presentation is sufficient at every supported clock ratio, but the only
    // authoritative evidence a retrain actually happened is the calibrator FSM
    // leaving S_DONE (Region C OBS_CAL / cal_state). This is why bit[6] is
    // write-only and reads back 0 (see the Region 8 read mux) rather than
    // exposing a "busy"/"consumed" status that could not honestly mean either.
    // ---------------------------------------------------------------------
    localparam int FORCE_RECAL_STRETCH = 1024;
    reg        swi_force_recal_r;
    reg [10:0] force_recal_ctr_r;
    // Combinational W1P write strobe. region8_write / ctrl_reg_write are module
    // -scope wires declared further down; both are `wire`, and this is a
    // continuous-assign context, so there is no `default_nettype none forward
    // -reference problem (unlike a reg read in the region8 mux above).
    wire       force_recal_w1p_w = ctrl_reg_write
                                   && (ctrl_reg_addr[4:3] == 2'b10)   // Region 8
                                   && (ctrl_reg_addr[2:0] == 3'h0)    // slot 0
                                   && ctrl_reg_wdata[6];              // SWI_FORCE_RECAL
    always_ff @(posedge apb_clk or negedge poresetn) begin
        if (!poresetn) begin
            swi_force_recal_r <= 1'b0;
            force_recal_ctr_r <= 11'd0;
        end else if (force_recal_w1p_w) begin
            // (Re-)arm. A write during an in-flight stretch simply reloads it.
            swi_force_recal_r <= 1'b1;
            force_recal_ctr_r <= FORCE_RECAL_STRETCH[10:0];
        end else if (force_recal_ctr_r != 11'd0) begin
            force_recal_ctr_r <= force_recal_ctr_r - 11'd1;
            if (force_recal_ctr_r == 11'd1)
                swi_force_recal_r <= 1'b0;   // deassert -> ready for the next W1P
        end
    end
`ifdef TIDELINK_PHY_V2
    // Slot 0 bit[2] — SWI_SYNC_INSERT_EN: DEFAULT-OFF enable for the V2 PHY's
    // SYNC-word re-hunt beacon (tidelink_phy_sync_insert inside WavD2DGpio).
    // Wlink RX framer is a byte-counter with no SOP; on silicon die_a can lock
    // the wrong packet byte-phase and never decode the peer CR. SYNC gives the
    // framer a periodic re-hunt beacon. SoC addr = Region 8 slot 0 = 0x44032100,
    // bit[2]. Reset 0 -> the PHY inserter is a pure passthrough so the TX
    // datapath is bit-identical to today (zero-regression default). V2-only so
    // the V1 build stays bit-identical (V1 has its own idle-gated insertion).
    reg        swi_sync_insert_en_r;
    // Slot 0 bit[3] — SWI_SYNC_FORCE_ALWAYS: DEFAULT-OFF gate-fix control for the
    // V2 PHY's SYNC beacon (PART 2, 2026-06-15). The inserter is gated by
    // io_link_tx_tx_idle, which is sparse during the FC handshake and rarely
    // coincides with the 1-in-32 inserter counter on silicon (RX SYNC-detect
    // count stays 0). With this bit set the PHY DROPS the idle term so the beacon
    // fires on enable alone (it still self-gates on ~training internally). SoC
    // addr = Region 8 slot 0 = 0x44032100, bit[3]. Reset 0 -> original idle-gated
    // production behaviour (bit-identical when SWI_SYNC_INSERT_EN is also 0).
    // V2-only so the V1 build stays bit-identical.
    reg        swi_sync_force_always_r;
    // Slot 0 bit[4] — SWI_SYNC_ROBUST_DETECT: DEFAULT-OFF selectable robust framer
    // re-hunt (PART 2, 2026-06-15). Reset 0. When 0 the framer re-hunt is the
    // legacy full-128 exact compare only (bit-identical). When 1 the PHY's
    // mask-aware per-lane SYNC detector also drives the re-hunt (the silicon fix
    // for the full-128 compare never firing). SoC addr = Region 8 slot 0 =
    // 0x44032100, bit[4]. V2-only so the V1 build stays bit-identical.
    reg        swi_sync_robust_detect_r;
    // SoC Labs RX SYNC-detect SW LANE_MASK (PART 3, 2026-06-15) — 8-bit
    // SW-writable per-lane mask feeding the PHY detector's lane_mask_i, so the
    // operator can mask marginal lanes on silicon. Reset 0xFF (all lanes in).
    // SoC addr = Region 9 slot 2 = 0x44032128. V2-only.
    reg [7:0]  swi_sync_lane_mask_r;
    // SoC Labs RX SYNC-detect Hamming TOLERANCE (2026-06-17) — 5-bit SW-writable
    // per-lane SYNC-slice Hamming budget feeding the PHY detector's sync_tol_i
    // (and the 0x2144 live-match oracle). Lets the operator sweep 0..5 on
    // marginal-eye silicon so a lane that drops 1 bit/word in its SYNC slice
    // still matches and the framer re-anchor engages. Reset 0 (EXACT match ->
    // bit-identical to all prior images). Shares the LANE_MASK register: SoC
    // addr = Region 9 slot 2 = 0x44032128 [12:8]. V2-only.
    reg [4:0]  swi_sync_tol_r;
    // SoC Labs PER-LANE SYNC-match SWEEP ORACLE + word-pin override (2026-06-16,
    // perlane-wp). All V2-only so the V1 build stays bit-identical.
    //   swi_sync_obs_clr_r        : Region 8 slot 0 bit[5] SWI_SYNC_OBS_CLR
    //                               (SoC 0x44032100[5]). W1-PULSE, self-clearing —
    //                               held high for exactly one apb_clk on a wdata
    //                               bit[5]=1 write, then auto-clears. The PHY
    //                               2-flop-syncs + edge-detects it (one clear per
    //                               write) to reset the per-lane live/sticky/raw
    //                               obs. Reset 0 (no clear) -> bit-identical.
    //   swi_word_pin_perlane_r    : 8 x 4-bit per-lane word-pin override value,
    //                               lane L at [4L+3:4L] (SoC 0x44032148 [31:0]).
    //   swi_word_pin_perlane_en_r : 8-bit per-lane override enable, lane L at
    //                               bit L (SoC 0x4403214C [7:0]). Reset all-0 so
    //                               every lane keeps its legacy auto/global pin
    //                               (bit-identical datapath).
    reg        swi_sync_obs_clr_r;
    reg [31:0] swi_word_pin_perlane_r;
    reg [7:0]  swi_word_pin_perlane_en_r;
    // EYE-WIDTH LANE SELECT (2026-06-17, Task 3). APB-writable 3-bit field that
    // picks WHICH lane's eye-width the 0x2150 EYE_WIDTH_SEL register reports, so
    // ALL 8 lanes can be scanned remotely from one register pair. Was hardwired
    // 3'h0 at tidelink_top.sv (only lane 0 readable). Region 10 slot 5
    // (SoC 0x4403_2154 [2:0]). Reset = lane 0 (bit-identical to the old tie).
    reg [2:0]  swi_eye_lane_sel_r;
    // DATA-MODE SYNC-DIST LANE SELECT (2026-06-25, the winscan metric). APB-
    // writable 3-bit field that picks WHICH lane's SYNC Hamming distance the
    // 0x4403_21AC SYNC_DIST_OBS register reports, so all 8 lanes are scanned
    // remotely from one register pair (mirrors swi_eye_lane_sel_r). Region D
    // slot 4 (SoC 0x4403_21B0 [2:0]). Reset = lane 0.
    reg [2:0]  swi_dist_lane_sel_r;
`endif
    // FULL-RANGE IDELAY TAP LSB (2026-06-25). Per-lane low bit of the 5-bit RX
    // IDELAY tap: tap[N] = {swi_phase_offset_w[4N +: 4], swi_phase_lsb_r[N]} =
    // 2*nibble + lsb. The coarse nibble (SWI_PHASE_OFFSET 0x118) supplies the
    // high 4 bits; this reg supplies bit[0], so the tap reaches the FULL 0..31
    // IDELAYE2 range (odd taps + upper half) instead of the even-only 0,2,..30.
    // Region D slot 5 (SoC 0x4403_21B4 [7:0], lane N at bit N) — write decode is
    // V2-only (Region D), but the REG is declared in BOTH builds so the always-
    // present u_idelay_rx instance can wire .lsb_i unconditionally. Reset 0 =>
    // tap stays {nibble,1'b0} = the historical even-only behaviour, BIT-IDENTICAL
    // (in V1 there is no write path, so it stays 0 forever — zero regression).
    reg [7:0]  swi_phase_lsb_r;
    // Task 3 effective-select assignment (placed after swi_eye_lane_sel_r so the
    // reg reference is BACKWARD, satisfying VCS under `default_nettype none).
`ifdef TIDELINK_PHY_V2
    assign eye_lane_sel_eff = swi_eye_lane_sel_r;
`else
    assign eye_lane_sel_eff = swi_eye_lane_sel_i;
`endif
    // Slot 1 — SWI_BIT_SLIP_LO bits[23:0] (8 × 3-bit per-lane slip)
    reg [23:0] swi_bit_slip_lo_r;
`ifdef TIDELINK_PHY_V2
    // V2 word-pin override (mirrors BIST BIT_SLIP_OVR[28:24]). V2-only so the
    // V1 build stays bit-identical. Captured from SWI_BIT_SLIP_LO writes.
    reg [3:0]  swi_word_pin_ovr_r;       // [27:24] manual global word pin
    reg        swi_word_pin_auto_dis_r;  // [28] 1 = force manual (auto off)
`endif
    // Slot 6 — SWI_PHASE_OFFSET bits[31:0] (8 × 4-bit per-lane sub-bit
    // sample-point phase). §9.7: SW override of the calibrator's per-lane
    // phase sweep, OR-merged with cal_phase_offset_w into the Wlink
    // swi_phase_offset_in port (same pattern as swi_bit_slip_lo_r). This
    // slot was the reserved "SWI_BIT_SLIP_HI" (16-lane builds); repurposed
    // for the 8-lane FPGA bring-up — see docs/REGISTER_MAP.md / RDL. The
    // legacy single-global-phase APB path (Wlink PHY-ctrl reg bits[20:17])
    // is independent and still works (per-lane OR-merge inside WavD2DGpio
    // means a lane left at 0 here still takes the global APB phase). POR-
    // only reset domain, same as the other §9 soft-straps.
    reg [31:0] swi_phase_offset_r;
    // Slot 3 — NEGO_TRAIN_CFG: bit[0]=auto_en, bit[1]=sw_step,
    //          bit[2]=retrain (W1P), bits[7:4]=poll_timeout,
    //          bits[15:8]=fsm_wait_hi.
    reg [15:0] nego_train_cfg_r;
    // M11b: calibrator MIN_LOCK_DWELLS runtime override — slot 3 [23:20].
    // Separate from nego_train_cfg_r[7:4] (= autoneg train_poll_timeout).
    reg [3:0]  min_lock_dwells_r;
    reg        nego_train_retrain_pulse;  // 1-cycle pulse on W1P write

    // LOOP-9 AUTONOMY SCOPE (2026-07-03, silicon-root-caused): the single
    // qualifier for EVERY autonomous SYNC/winscan/handoff machine (the SYNC
    // config drive + F1b heal, the winscan FSM kick, the fch handoff arm).
    // nego_en & role_locked is NOT sufficient to exclude the manual recipe:
    // on silicon NEGO_CFG PORs to 0x61 (nego_en=1) and the proven manual
    // recipe never writes 0x2090 — it disarms autonomy by writing
    // NEGO_TRAIN_CFG 0x210C = 0 FIRST (td_v2_hwlib.sh rcp :91), i.e. the
    // real manual-vs-autonomous discriminator is train_auto_en (0x210C
    // bit[0], POR 1 for zero-poke). Without this term the winscan FSM kicked
    // on the MANUAL recipe's training falls (pre-existing since 8705a99,
    // previously masked because mid-scan kicks were LOST); the FIX-1
    // abort-restart let the recipe's LAST recal fall restart a ~8 s silicon
    // force-SYNC window (winscan_force_sync ORs into insert_en AND
    // force_always at the Wlink ports) that then overlapped MANUAL data
    // mode — force_always is the R4 word-deleter: die_b credit_count=4098 /
    // underrun=1, GP1 zeros, TXSYNC 0x2120=0x5c01ffff while R8 correctly
    // read 0x10 (the reg was clean; the PORT OR was not). Contract: with
    // train_auto_en=0 (or nego_en=0) every APB R8 write is AUTHORITATIVE
    // and all autonomous machines are dormant/parked — the manual path is
    // bit-identical. A mid-run disarm also PARKS an in-flight winscan (see
    // the FSM's disarm arc) so 0x210C=0 is an immediate on-silicon escape
    // hatch from a stuck force window.
    // ── EVENT-GATED AUTONOMY RETIRE (2026-07-15, silicon B->A fix) ──────────
    // autonomy_retire_q is a STICKY ONE-SHOT that autonomously replicates the
    // proven on-silicon escape hatch `0x210C=0` (clear train_auto_en). Once the
    // link is provably up (REANCHORED & bilateral FC seen, then a short dwell —
    // see the retire block below for why reanchored, NOT winscan_done, and why
    // early), it drops the effective autonomy_armed term. That fires the FSM's
    // LOOP-9 DISARM-PARK arc (:~4640),
    // which drops winscan_force_sync / ws_serve_active_r (the FORCED-SYNC chain
    // OR'd into the Wlink insert_en+force_always+robust ports) — the ACTUAL B->A
    // corruptor: on the receiver (die_a) a stuck autonomous force window keeps
    // SYNC beating over the B->A payload so its RX framer never commits. SILICON
    // PROOF (td_b2a_diag2.log): B->A recovered byte-exact the instant die_a's
    // autonomy_armed dropped (0x210C=0) — with R8 STILL 0x14 (insert_en=1) and
    // reanchored=0 — so insert_en/R8[2] is NOT the blocker; autonomy_armed is.
    // KEEPS the manual path bit-identical: retire only ever asserts on the
    // armed autonomous path (nego_en & role_locked & train_auto_en); with
    // nego_en=0 or train_auto_en=0 it can never set, so autonomy_armed is
    // unchanged. PER-EPISODE: re-armed (cleared) on swi_training_mode_rise so a
    // retrain/re-scan restores the forced-SYNC chain the peer needs and avoids
    // the ws_kicked_q re-scan trap — see the retire block below.
    reg  autonomy_retire_q;
    wire autonomy_armed = nego_en & role_locked & nego_train_cfg_r[0]
                        & ~autonomy_retire_q;

    // Phase 1 G1b — sticky train-fail IRQ. Latches on train_fail_irq_w
    // rising-edge (the FSM holds it stable for the duration of
    // ST_TRAIN_FAIL); SW reads it via Region 8 slot 3'h3 bit[16] and
    // clears with W1C to the same bit position. The dead-ended
    // `_unused_phase3_b` wire is replaced by this register.
    reg        train_fail_irq_r;
    reg        train_fail_irq_w_d;   // 1-cycle delay for edge-detect

    // Forward decls — driven by the autoneg FSM (Step 4 wires these up).
    wire [3:0] train_state_w;
    wire       train_ok_w, train_fail_w, train_in_progress_w, train_peer_nack_w;
    // R-B (2026-07-04): the autoneg is in ST_FIN_RDV/ST_FIN_GO and owns the
    // I2C-master AXIL bus (nego_state_w's 4-bit truncation aliases 18/19 to
    // WAIT/CLAIM, so nego_driving needs this dedicated level).
    wire       fin_rdv_in_progress_w;
    wire [7:0] train_peer_lane_locked_w, train_peer_lane_fault_w;
    wire [7:0] train_local_lane_fault_w;
    wire       train_fail_irq_w;
    wire       local_training_mode_set_w, local_training_mode_clr_w;
    wire       local_swreset_pulse_w;

    // Forward decl (R4b 2026-07-02; the D2 fix removed the upstream SYNC-OFF
    // consumer, but the WINSCAN_OBS readback + anchored-late obs still read it
    // ahead of the driver) — DRIVEN by the FC data-mode handoff sequencer
    // (block after the autoneg instance). `default_nettype none` forbids a
    // forward reference, so the declaration is hoisted here; the driver keeps
    // its documented position in the fch block below.
    reg        fch_done_r;      // sticky: this fch episode's burst completed
    // Q1 QUIESCE-BEFORE-FINALIZE (2026-07-04) forward decls — same hoist
    // rationale (the WINSCAN_OBS readback reads fch_quiesced_r upstream of the
    // fch block that drives it; the fch block reads fch_quiesce_req upstream
    // of the V2 winscan section that assigns it).
    //   fch_quiesced_r  : sticky — the LL swi_swreset (FCCTRL 0x208 bit[3]) is
    //                     currently held ON by the quiesce path (the early
    //                     FCH_LL_SWRESET_ON write issued at WS_FINALIZE entry).
    //                     Cleared when the bootstrap walk deasserts it, or by
    //                     the disarm-release write. WINSCAN_OBS 0x21B8[8].
    //   fch_quiesce_req : level request from the winscan FSM — asserted while
    //                     the FSM sits in WS_FINALIZE / WS_FIN_CLRLOW on the
    //                     ARMED autonomous path (V2 winscan section assigns
    //                     it; the V1 arm ties it 0 so the fch sequencer is
    //                     bit-identical on V1).
    reg        fch_quiesced_r;
    wire       fch_quiesce_req;
    // -------------------------------------------------------------------------
    // SoC Labs FCH APB WATCHDOG (2026-07-09, ported from f1b3aac) — silicon-observed.
    //
    // The fch sequencer takes ownership of the Wlink APB bus (fch_active_r, see
    // the wl_apb_* mux) and, in FCH_ACCESS, waits on wl_apb_pready with NO
    // TIMEOUT. The external (PS) APB takes its pready from that SAME bus
    // (`assign apb_pready = ... : wl_apb_pready`) with no arbitration term, and
    // tidelink_top routes every 0x2xxx access to it (tidelink_top.sv:711).
    //
    // Consequence, measured on silicon 2026-07-09 (die_a, master, autonomous
    // bring-up): the FCH burst's first write is FCH_LL_SWRESET_ON (0x27f09),
    // which puts the Wlink LL into swi_swreset. If wl_apb_pready then never
    // returns, the FSM sits in FCH_ACCESS forever with fch_active_r=1, so
    // apb_pready is pinned low and EVERY PS access to the 0x2xxx region never
    // completes. Zynq-7000 M_AXI_GP has no transaction timeout -> the CPU takes
    // a Bus error / hangs in kernel space while Linux stays alive. The link
    // itself trains fine (the peer reaches fcsm=4 cal=1) -- what dies is the
    // processor's view of the PL. That is why "autonomous data = 0/28": you
    // cannot drive data from die_a's PS at all. It was never the FC path.
    //
    // Fix, in two parts:
    //   1. This watchdog. If FCH_ACCESS does not see wl_apb_pready within
    //      FCH_WDOG_LIMIT cycles, abort the burst, RELEASE the bus
    //      (fch_active_r=0) and latch a sticky error + the failing write index.
    //      The bootstrap then fails VISIBLY and RECOVERABLY instead of taking
    //      the processor's bus down with it.
    //   2. Mask apb_pready while fch_active_r (see the assign near the bottom),
    //      so a concurrent PS access is STALLED rather than completing against
    //      the sequencer's transaction (an APB protocol violation today).
    //
    // Software: WINSCAN_OBS 0x21B8 is FULL on this branch ([23:0] all packed —
    // FIX-D ws_verify_stuck at [14], ws_waitpeer at [15], etc.), so unlike the
    // upstream f1b3aac (which used 0x21B8[14]/[16:15]) this port exposes the
    // status in the previously-RESERVED regionD slot 7:
    //   FCH_OBS 0x4403_21BC (RO):
    //     [ 0]    fch_stall_err  (sticky) — the LL never acked the fch APB write
    //     [ 2:1]  fch_stall_widx          — 0=SWRESET_ON,1=SWRESET_OFF,2=ENABLE
    //     [ 3]    fch_active_r   (live)   — sequencer currently owns the wl_apb bus
    //     [31:24] 0xFC presence marker (old images read 0 here = STALE package_ip)
    //   Non-zero [0] means the LL never acked the APB write; [2:1] says which.
    // -------------------------------------------------------------------------
    reg        fch_stall_err_q;    // sticky: an FCH APB access timed out
    reg [1:0]  fch_stall_widx_q;   // which write was in flight when it timed out
    localparam [19:0] FCH_WDOG_LIMIT = 20'd500_000; // ~10 ms @ 50 MHz: >> any legal APB ack
    // R-B ASYMMETRIC PEER-SERVE rendezvous plumbing — RE-ARMED (2026-07-07).
    // History: the Loop-12 SYMMETRIC rendezvous (BOTH dies park in
    // WS_FIN_WAITPEER and BOTH re-confirm over each other's constant idle)
    // regressed b-first on silicon (mutual anchor starvation, 0x21B8=0x57000005
    // both) and was reverted dormant (Loop-13). This is the ASYMMETRIC rework:
    // only die_a (MASTER) parks in WS_FIN_WAITPEER, runs the rendezvous and
    // re-confirms; die_b (SLAVE) HOLDS its already-good anchor and merely SERVES
    // idle beacons (ws_serve_active_r) so it never re-confirms over constant
    // idle — the mutual-starvation mechanism is gone by construction.
    //   ws_fin_wait_lvl : LEVEL — the MASTER is parked quiesced in
    //                     WS_FIN_WAITPEER (role_is_master-gated). Fed to
    //                     u_autoneg.local_fin_wait_i (master ST_FIN_RDV/GO entry
    //                     arc). The SLAVE's peer-visible SWI_LANE_STATUS[27] is
    //                     ready-to-serve instead (see the [27] mux). Tied 0 on
    //                     V1 (arm below).
    //   nego_fin_go_w   : u_autoneg.fin_go_o — the master's local finalize
    //                     release (the slave's FINALIZE_GO write completed).
    //                     Consumed by the WS_FIN_WAITPEER Phase-1 release.
    wire       ws_fin_wait_lvl;
    wire       nego_fin_go_w;
    // FIX-B (2026-07-07 PEER-READY ENTRY GATE) — the broadened "MASTER is in ANY
    // finalize state" level (WS_FINALIZE | WS_FIN_CLRLOW | WS_FIN_WAITPEER),
    // role_is_master-gated. Fed to u_autoneg.local_finalizing_i so the autoneg
    // enters the SIDE-EFFECT-FREE ST_FIN_RDV POLL as soon as the master starts
    // finalizing (not only once parked in WS_FIN_WAITPEER) — it reads the peer's
    // ready-to-serve bit (SWI_LANE_STATUS[27]) WITHOUT writing a GO (the GO write
    // stays gated on the NARROW ws_fin_wait_lvl / local_fin_wait_i). The captured
    // peer bit comes back as peer_ready_to_serve_w below.
    wire       ws_finalizing_lvl;
    // FIX-B: u_autoneg.peer_ready_to_serve_o — the peer's SWI_LANE_STATUS[27]
    // (ready-to-serve) as captured by the master's ST_FIN_RDV poll. Gates the
    // WS_FINALIZE fallback entry into WS_FIN_WAITPEER (~4619): a FIRST-armed die
    // whose peer is still arming (peer[27]=0) must NOT fall into the serve
    // rendezvous — it takes the base fail-open (Loop-14 83% path, sticky anchor
    // preserved). Only the 2nd-armed die (peer in data mode, [27]=1) rendezvouses.
    wire       peer_ready_to_serve_w;
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
